lmh666-yes/Second_Project_Demo/README.md

# 环境监测系统
### STM32F407 双板 + LoRa + MQTT + Qt 上位机

> 两套独立固件（检测端 / 通信端）通过 LoRa 组网，通信端经 ESP8266 上云，
> PC 端用 Qt 实时显示曲线、告警与历史数据。

---

## ⚠️ 先看这个：项目实际做到哪一步

**这个项目和最初的设计预期不完全一致。** 下面是逐项核对的结果（以仓库里的当前源码为准，不看设计文档）：

| 能力 | 设计预期 | 实际代码 | 状态 |
|---|---|---|---|
| **4 路 I2C 传感器** | SHT30 / BMP280 / BH1750 / CCS811 | `CollectAll()` 确实读这 4 路，`SYS_I2C_Init()` 已调用 | ✅ **已实现** |
| **20 字节定长帧** | AA55 + CMD + LEN + 12B 数据 + CRC16 + 55AA | `sys_frame` 模块实现组帧/解帧/CRC | ✅ **已实现** |
| **LoRa 收发** | E22-400T22S，USART3/6 | `lora_e22` 模块 + `vTaskComm`/`vTaskLoraRx` | ✅ **已实现** |
| **断网缓存** | W25Q128 环形日志 | `w25qxx_log.h`：**255 扇区 ≈ 1020 KB ≈ 32640 条 ≈ 18 h** | ✅ **已实现** |
| **自动补传** | 按原时间戳回传 | `vTaskReplay` + `replay_*`，重连即自动补传 | ✅ **已实现** |
| **MQTT 上报** | 周期性上报环境数据 | 有 `publish_env()`，但**只在上报时机调用**，周期性待确认 | ⚠️ **部分实现** |
| **自检（18 项）** | 上电跑 18 项自检 | `board_selftest.c` **已写好，但没接入 `main.c`** | ⚠️ **代码在，没接线** |
| **MQ-135 空气质量** | 接入第 6 路 | 全代码 **0 处引用**，帧第 6 字段固定 0 | ❌ **未做** |
| **实测指标** | 周期抖动 / 72h 长稳 / 丢包率 | **硬件还没组装**，所有实测数据为空 | ❌ **未做** |
| **DHT11** | 早期方案的主传感器 | 当前代码 **0 处引用**（已被 4 路 I2C 取代） | 🔄 **已废弃** |

### 为什么会不一致

三个阶段叠加造成的结果：

1. **第一阶段（2026-10 前）**：写了一套完整参考实现——板1 1074 行、板2 1694 行，带 12 个 `test_*` 自检函数，自检 18/18 通过。
2. **第二阶段（2026-10-12）**：为了「从零自建」练手，`main.c` 被换成阶段骨架（板1 72 行、板2 83 行），Qt 的 5 个业务类改成桩函数。参考实现整套备份在 `_参考实现备份\20261012_195704\`。
3. **第三阶段（2026-10-20 之后）**：自己重写，当前是板1 **995 行**、板2 **834 行**——主体功能回来了（4 路传感器、帧协议、缓存、补传），但**自检没接回来**（`board_selftest.c` 写好了躺在目录里），**MQ-135 没接**，**硬件没到货所以没实测**。

**所以准确的说法是：软件主体功能已实现并编译通过，但自检未接入、MQ-135 未接、硬件未上板、无任何实测数据。**

---

## 一、项目做什么

在实验室多点布置环境监测节点，自动采集温湿度、气压、光照、空气质量，数据经 LoRa 汇总到通信端，再经 WiFi/MQTT 上云，PC 上位机做实时可视化。

**要解决的问题**：替代人工巡检抄表——4 类参数自动采集、超限告警、历史可追溯。

---

## 二、系统结构

```
┌──────────────┐   LoRa 433MHz   ┌──────────────┐   WiFi/MQTT   ┌────────────┐
│ 检测端 F407ZE │ ──────────────> │ 通信端 F407ZG │ ────────────> │  云 / 上位机 │
│ 4 路 I2C 传感器│   20 字节帧      │ TFT 显示/缓存 │   ESP8266 AT  │   Qt 程序   │
└──────────────┘                 └──────────────┘                └────────────┘
```

| 角色 | 主控 | 职责 |
|---|---|---|
| **检测端** | STM32F407ZE | 采集 4 路传感器、滤波、告警判断、LoRa 上报 |
| **通信端** | STM32F407ZG | LoRa 接收、TFT 显示、断网缓存、WiFi 上云、上位机转发 |
| **上位机** | PC (Qt 6) | 实时曲线、告警配色、CSV 导出、下发控制 |

---

## 三、传感器与硬件

### 检测端 4 路 I2C 传感器

| 传感器 | 测量 | I2C 地址 | 状态 |
|---|---|---|---|
| SHT30 | 温湿度 | 0x44 | ✅ 驱动已实现 |
| BMP280 | 气压 | 0x76/0x77 | ✅ 驱动已实现 |
| BH1750 | 光照 | 0x23 | ✅ 驱动已实现 |
| CCS811 | 空气质量（TVOC/eCO2） | 0x5A | ✅ 驱动已实现 |
| MQ-135 | 空气质量（模拟） | ADC PF7 | ❌ 未接入 |

### 通信与外设

| 器件 | 用途 | 状态 |
|---|---|---|
| LoRa E22-400T22S | 节点间无线（433MHz） | ✅ 已实现（USART3 板1 / USART6 板2） |
| ESP8266 + AT | WiFi 上云（MCU 侧自实现 MQTT 3.1.1） | ✅ 已实现 |
| W25Q128（实为 GD25Q128） | 16MB SPI Flash，断网缓存 | ✅ 已实现 |
| ILI9481 TFT 3.5" | 本地显示（板2） | ✅ 已实现 |
| CH340C | USB 转串口（调试） | ✅ |

---

## 四、通信协议：20 字节定长帧

```
┌──────┬──────┬──────┬────────────────────┬────────┬──────┐
│ AA55 │ CMD  │ LEN  │ 6 × int16 大端定点  │ CRC16  │ 55AA │
│ 2B   │ 1B   │ 1B   │ 12B                │ 2B     │ 2B   │
└──────┴──────┴──────┴────────────────────┴────────┴──────┘
```

| 字段 | 说明 |
|---|---|
| 帧头 | `0xAA55` |
| 命令 | `0x01` 环境帧上行；`0x10`–`0x16` 下行请求；`0x80`–`0xFF` 应答（= 请求 \| 0x80） |
| 长度 | `0x0C`（12 字节负载） |
| 数据 | 6 个 int16 大端：温度×100、湿度×100、气压×10、光照、TVOC、**第 6 字段保留（MQ-135 未接，固定 0）** |
| CRC16 | MODBUS 多项式，覆盖前 14 字节，**低字节在前** |
| 帧尾 | `0x55AA` |

**下行命令**：`0x16` 触发补传、`0x15` 回传历史帧（4 字节原始时间戳 + 20 字节原帧）、`0x96` 回报状态。应答字 = 命令 \| `0x80`。

**协议向量（自检用）**：
```
0x16 01 01 → AA 55 16 01 01 50 54 55 AA
0x16 01 00 → AA 55 16 01 00 91 94 55 AA
```

**CRC 双向验证**：板1 组帧、板2 解帧、Qt 再解一遍，三处独立计算 CRC 并互验。

---

## 五、FreeRTOS 任务结构

### 检测端（板1）

| 任务 | 职责 |
|---|---|
| `vTaskSensor` | 采集：`CollectAll()` 读 4 路 I2C，带失败重试与降级 |
| `vTaskProcess` | 滤波 + 双阈值迟滞告警 + 组帧 |
| `vTaskComm` | LoRa 发送 |
| `vTaskLoraRx` | 下行指令接收与处理 |
| `vTaskUi` | 本地显示 |
| `vTaskMonitor` | 看门狗 + 统计 |

### 通信端（板2）

| 任务 | 职责 |
|---|---|
| `vTaskLoraRx` | 收帧，按字节间隔切帧 |
| `vTaskCmd` | 命令解析与应答 |
| `vTaskNet` | WiFi/MQTT 连接与发布 |
| `vTaskReplay` | 断网补传（50 ms/条） |
| `vTaskUi` | TFT 刷新 |
| `vTaskMonitor` | 看门狗 + 统计 |

队列解耦各环节，按栈水位实测调优任务栈大小。

---

## 六、断网缓存（可靠性设计）

网络断开时数据不丢：

```
采样 → 带时间戳 → 写 W25Q128 环形日志（255 扇区 ≈ 1020KB ≈ 32640 条）
     → 网络恢复 → 按原时间戳自动补传（50ms/条）
```

配置见 `w25qxx_log.h`：

```c
#define W25QXX_LOG_SECTORS   255U   /* ≈1020KB ≈ 32640 条，约 18 小时@0.5 帧/秒 */
#define W25QXX_LOG_SLOT_SIZE 32U    /* 32 字节/条，4KB 扇区正好 128 条 */
#define W25QXX_LOG_HDR_SIZE  12U    /* 12B 头 + 20B 整帧 */
```

- 环形覆盖：写满后从最旧开始覆盖
- 先写数据再写序号 → 掉电原子性
- 时间戳保留：补传的是采样原始时刻，不是当前时间

**已知不足**（设计文档自己列的）：
- 补传期间新帧只计数不补发
- 无掉电续传游标
- `0x96` 剩余条数只有 1 字节（255 表示"以上"）
- 清空 16 扇区期间挂起调度器 0.5~1 s

---

## 七、上位机（Qt 6）

| 功能 | 状态 |
|---|---|
| 实时曲线（QCustomPlot） | ✅ |
| 6 项数值显示 | ✅ |
| 环形缓冲 | ✅ |
| CSV 导出（10 列，末列区分实时/补传） | ✅ |
| 双阈值迟滞告警 + 告警记录 | ✅ |
| 补传按钮与进度显示 | ✅ |
| 命令下发 | ✅ |

自检命令：`--selftest`、`--rangecheck`、`--cmdselftest`（**当前是桩化版本，数字不能当实测**）。

---

## 八、目录说明

```
Second_Project_Demo/
├── README.md                       ← 本文件
├── 01_检测端_STM32F407/
│   ├── Project/                    ← Keil 工程 + 源码（main.c 995 行）
│   ├── 检测数据端设计.md            ← 设计说明
│   ├── LoRa模块参数.md
│   └── 该端目前采用STM32F407_zet6.txt
├── 02_通信端_STM32F407/
│   ├── Project/                    ← Keil 工程 + 源码（main.c 834 行）
│   ├── 数据传输端设计.md
│   └── LoRa模块参数.md
├── 03_上位机_Qt/
│   ├── SerialMonitor/              ← Qt 工程源码
│   └── Qt上位机设计.md
├── 04_文档/
│   ├── 架构与设计/                 ← 18 份设计文档
│   │   ├── 设计思路报告.md
│   │   ├── 实现事实清单.md          ← ★ 逐行代码取证，最硬的一份
│   │   ├── 项目进度.md             ← ★ 完成/未完成清单
│   │   ├── 核心软件和FreeRTOS架构.md
│   │   ├── 断网缓存补传设计.md
│   │   ├── 代码审查报告.md
│   │   ├── 项目整体评审与升级建议.md
│   │   └── ...
│   └── 问题与分析/
│       ├── 我遇到我问题以及的分析.md  ← ★ 踩坑记录
│       ├── 嵌入式项目面试问答.md
│       └── 视频拍摄脚本.md
├── 05_硬件资料/                    ← 传感器手册 + 接线表
└── 06_工具脚本/
    ├── 诊断/（串口识别、诊断两块板）
    ├── 长稳测试/
    └── OTA救援/
```

---

## 九、编译与烧录

### 固件（Keil MDK）

```
01_检测端_STM32F407/Project/标准模板.uvprojx      （板1，编译宏 SYS_TEST_BOARD=1）
02_通信端_STM32F407/Project/000标准模板库.uvprojx  （板2，编译宏 SYS_TEST_BOARD=2）
```

两板共用一份 `main.c` 源码思路，通过 `SYS_TEST_BOARD` 宏分支：
- `SYS_TEST_BOARD=1` → `HAS_DHT11=1`
- `SYS_TEST_BOARD=2` → `HAS_W25QXX=1`
- 未定义直接 `#error`

编译产物参考：板1 `Code=28908 RO=1288 RW=304 ZI=34848`；板2 `Code=40160 RO=2632 RW=396 ZI=36340`（0 Error 0 Warning）。

### 上位机（Qt 6）

```
03_上位机_Qt/SerialMonitor/SerialMonitor.pro
```

Qt Creator 打开 `.pro`，选 Qt 6 + MinGW 构建。

---

## 十、还没做的事（诚实清单）

| 优先级 | 事项 | 现状 |
|---|---|---|
| **高** | 硬件组装 | 传感器 / LoRa / OLED 未采购到货，**一次都没上板跑过** |
| **高** | 上板跑通单链路 | 检测端 → LoRa → 通信端 → Qt，全链路未联调 |
| **高** | 接入自检 | `board_selftest.c` 已写好（2026-10-20 生成），未加进 Keil 工程、未在 main 调用 |
| **高** | 接入 MQ-135 | 驱动未写，帧第 6 字段固定 0 |
| **中** | MQTT 周期上报 | 现在只在特定时机发布，未做定时上报 |
| **中** | I2C 地址宏 | BH1750(0x23)/CCS811(0x5A)/BMP280(0x76) 部分缺宏 |
| **中** | 采集周期压回 1 s | 当前 2 s |
| **中** | 看门狗心跳汇总 | `SYS_WDG_HEARTBEAT_COUNT` 仍为 0，只喂狗不用心跳位图 |
| **低** | 补传细节 | 无掉电续传游标、剩余条数只有 1 字节 |
| **低** | 实测指标 | 周期抖动、单轮耗时、72h 长稳、丢包率全部为空 |

---

## 十一、这个项目真实的价值

不是"读几个传感器显示出来"，而是这几件**已经写进代码**的事：

1. **两套独立固件**通过网络协同，`SYS_TEST_BOARD` 宏分板、编译期断言防错
2. **自定义二进制帧协议**（20 字节定长 + CRC16 + 三端互验 + 协议向量自检）
3. **断网缓存 32640 条 + 原时间戳补传**（掉电原子性、环形覆盖）
4. **FreeRTOS 多任务**（队列解耦、栈水位实测调优、看门狗）
5. **Qt 上位机**（实时曲线、双阈值迟滞告警、CSV、补传控制）
6. **逐行代码取证的文档**（`实现事实清单.md` 572 行，每行结论都带文件行号）

**还没兑现的**：上板实测 + 自检接入 + MQ-135。

**这个项目最值钱的部分可能不是功能，是那份 `实现事实清单.md`**——把每一条结论都钉到具体文件的具体行，这种取证能力比"能跑"更难。

---

*文档版本 v2.0 · 2026-11 · 本版按实际代码重新核对，修正了 v1.0 中过度乐观的表述*
