lmh666-yes/Second_Project_Demo/04_文档/架构与设计/项目整体评审与升级建议.md

# 项目整体评审与升级建议

> 项目 : 精密仪器实验室环境监护系统
> 定位 : 分布式环境监测系统（两块 STM32F407）
> 日期 : 2026-10-09
> 状态 : 设计定稿期（外设尚未采购）

---

## 0. 结论

| 问题 | 结论 |
|---|---|
| 项目能做出来吗 | 能。底层驱动比预期完整：两板各有 40+ 个自研 `sys_*` 驱动，FreeRTOS 已跑通、编译零错误 |
| 技术覆盖面如何 | 覆盖嵌入式岗位的主要考点，比常见的单板学生项目多一个分布式层次 |
| 最大的短板 | 没有可量化的结果（没有丢包率、堆余量等实测数字），以及 8 项外设里 7 项还没买到 |
| 最该先做的一件事 | 用手上的板载 DHT11 先跑通完整链路（采集→队列→组帧→LoRa→网关→Qt），再插传感器 |
| 定位口径建议 | 不用"高精度科研级"这类说法（没有校准设备与计量依据），改为"工业级环境监测 + 数据可追溯"，后者有 CRC16、心跳、断网缓存支撑 |

---

## 1. 项目做什么

用两块 STM32F407 组成"无线采集 + 边缘网关"的分布式系统，对实验室的温湿度、气压、光照、空气质量做长期监测，数据同时送到电脑上位机和云端，超限时本地与远程双重告警。

数据通路：采集节点通过 I2C 挂 SHT30、BMP280、BH1750、CCS811 四类传感器，1 秒一轮采集，经滑动滤波后按自定义的 20 字节二进制协议组帧、带 CRC16 校验，通过 LoRa 无线发出。

网关端也是 F407，用串口 DMA + 空闲中断收帧，状态机解析并校验，然后同时走两路：一路通过 RS232 发给 Qt 上位机做实时曲线和 CSV 记录，一路通过 ESP8266 走 MQTT 上巴法云，云端可直接推到手机。网关侧还有 W25Q128 断网缓存：云端断开时把数据落进 Flash，网络恢复后按序号补传。上位机用 Qt 写，实时显示 6 个参数、画历史曲线、导出 CSV，带双阈值迟滞告警和协议一致性自检。

---

## 2. 技术栈总览

| 层次 | 技术 | 说明 |
|---|---|---|
| 硬件 | STM32F407ZET6（采集节点）+ STM32F407ZGT6（边缘网关） | 双 F407，同系列不同 Flash 容量（512 KB / 1 MB） |
| 底层驱动 | ST 标准外设库（StdPeriph Library） | 非 HAL；两板工程各含 40+ 个自研 `sys_*` 封装驱动 |
| RTOS | FreeRTOS 10.4.6（原生 API，非 CMSIS-RTOS 封装） | heap_4，30 KB 堆，抢占式调度 |
| 无线 | LoRa E22-400T22S（433 MHz） | 板1 ↔ 板2 的唯一链路 |
| 云端 | ESP8266 + AT 指令 + MQTT（巴法云 bemfa.com） | 通过 WiFi 上云，可直接推微信/小程序 |
| 上位机 | Qt 6.11.2（MinGW 64-bit）+ QCustomPlot | 串口通信、实时曲线、CSV、告警 |
| 传感器 | SHT30(I2C) / BMP280(I2C) / BH1750(I2C) / CCS811(I2C) / MQ-135(ADC) | 4 类物理量 + 2 类空气质量 |
| 存储 | W25Q128 SPI Flash（板载） | 断网缓存，64 KB 专用区 ≈ 2000 条 |
| 协议 | 自定义 20 字节二进制帧 + CRC16-MODBUS | 三端（板1/板2/Qt）一致 |

---

## 3. 系统架构

### 3.1 三端数据流

```
┌──────────────────────────────┐
│   板1 采集节点 (F407ZET6)     │
│                              │
│  SHT30 ┐                     │
│  BMP280├─ I2C ──► SensorTask │  1 s 周期
│  BH1750│          (优先级 3)  │
│  CCS811┘              │      │
│  MQ-135 ── ADC ───────┤      │
│                       ▼      │
│                   Queue1     │
│                       ▼      │
│              ProcessTask(3)  │  滤波 + 阈值 + 组帧
│                       ▼      │
│                   Queue2     │
│                       ▼      │
│               CommTask(4) ───┼──► LoRa E22 ──┐
│                              │               │
│  MonitorTask(5) 心跳 + 喂狗   │               │
└──────────────────────────────┘               │
                                               │ 无线 433MHz
                                               ▼
┌──────────────────────────────────────────────────────────────┐
│   板2 边缘网关 (F407ZGT6)                                     │
│                                                              │
│  LoRa ──► USART6 + DMA + 空闲中断 ──► Sem1（二值信号量）       │
│                                              ▼               │
│                                    CommRxTask(4) 状态机解帧   │
│                                      找帧头/验长度/CRC16/验尾  │
│                                              ▼               │
│                                          Queue3              │
│                                              ▼               │
│  ┌───────────────────────────┬───────────────────────────┐  │
│  ▼                           ▼                           │  │
│ ForwardTask(3)          CloudTask(3)                     │  │
│  USART2 → RS232          USART3 → ESP8266 → MQTT         │  │
│      │                        │                          │  │
│      │                  失败 3 次                         │  │
│      │                        ▼                          │  │
│      │                     Queue4                         │  │
│      │                        ▼                          │  │
│      │                  CacheTask(3) → W25Q128           │  │
│      │                  断网落盘 / 恢复后补传              │  │
│      │                                                   │  │
│  MonitorTask(5) 心跳位图 + 喂狗                            │  │
└──────┼───────────────────────────────────────────────────┘  │
       │                                                      │
       ▼                                                      ▼
┌──────────────────┐                              ┌──────────────────┐
│  Qt 上位机        │                              │  巴法云 MQTT      │
│  数值 / 曲线      │                              │  → 微信 / 小程序  │
│  CSV / 阈值告警   │                              └──────────────────┘
│  一致性自检       │
└──────────────────┘
```

### 3.2 任务划分与优先级

板1（采集节点）

| 任务 | 优先级 | 周期/触发 | 职责 |
|---|---|---|---|
| SensorTask | 3 | 1 s（vTaskDelayUntil） | 读 5 路传感器，失败填故障标记不阻塞 |
| ProcessTask | 3 | Queue1 触发 | 滑动/中值滤波、双阈值判断、按协议打包 |
| CommTask | 4 | Queue2 触发 | 组帧 + CRC16 + 经 USART3 发 LoRa |
| MonitorTask | 5 | 定时 | 心跳位图巡查，全刷新过才喂 IWDG |

板2（边缘网关）

| 任务 | 优先级 | 周期/触发 | 职责 |
|---|---|---|---|
| CommRxTask | 4 | Sem1（空闲中断） | 状态机解帧、CRC 校验、提取数据 |
| ForwardTask | 3 | Queue3 触发 | 经 USART2 透传给 Qt 上位机 |
| CloudTask | 3 | 30 s / 告警插播 | AT 指令 + MQTT 上报巴法云 |
| CacheTask | 3 | Queue4 触发 | 断网写 W25Q128，恢复后按序号补传 |
| MonitorTask | 5 | 定时 | 心跳位图 + 喂狗 + ESP8266 在线巡查 |

> CloudTask 与 ForwardTask 必须分开：AT 指令是一问一答，单条 `AT+CIPSEND` 可能阻塞几百毫秒。
> 如果和 Qt 转发挤在一个任务里，云端阻塞时会连带阻塞上位机的实时曲线。

---

## 4. 能力覆盖面

| 方向 | 本项目对应 |
|---|---|
| STM32 外设驱动开发 | GPIO / USART(+DMA+IDLE) / I2C / SPI / ADC+DMA / TIM / EXTI / IWDG / WWDG / RTC / FLASH |
| 通信协议设计 | 自定义 20 字节帧 + CRC16-MODBUS + 状态机解帧 + 边界处理（帧头粘连、半帧、CRC 错） |
| RTOS 应用 | 多任务划分、队列解耦、二值信号量、互斥锁、心跳喂狗、中断优先级约束 |
| 分布式/无线通信 | 双板 LoRa 组网，采集与网关分离 |
| 上位机开发 | Qt 串口、QCustomPlot 实时曲线、CSV 导出、阈值告警 |
| 物联网/云平台 | ESP8266 AT + MQTT + 云平台推送到微信 |
| 可靠性/工程化 | 断网缓存补传、CRC 校验、看门狗、心跳、故障恢复、边界用例测试 |
| 调试手段 | 逻辑分析仪抓 I2C/串口、三端一致性自检、实测指标记录 |

覆盖面较均衡，其中可靠性设计部分（断网、误码、任务卡死的处理）是常见学生项目普遍缺失的一块。

---

## 5. 与常见学生项目的差异

| 常见学生项目 | 本项目 |
|---|---|
| 单板采集，串口打印到电脑 | 双板分布式，采集与网关分离，无线 LoRa 链路 |
| 用文本协议（`TEMP:25.3\n`） | 自定义二进制帧 + CRC16，带完整的状态机解析与边界处理 |
| 只做"读传感器 + 显示" | 有滤波算法、双阈值迟滞告警、分级告警（本地蜂鸣器 + 远程上位机） |
| 断线即中断 | 断网缓存 + 补传（W25Q128，约 2000 条 ≈ 16 小时） |
| 看门狗单点喂狗 | 心跳位图，全任务刷新过才喂狗，避免单任务死循环被掩盖 |
| 没有测试环节 | 三端一致性自检 + 边界用例（负温度、CRC 错、帧头粘连、半帧） |
| 只有"能跑"的结论 | 有实测指标表（周期抖动、丢包率、CRC 错误率、堆余量、端到端延迟） |

---

## 6. 已有的技术底子

评审时把两板的 `FWLIB/inc` 逐个列了出来，结论是底座比一开始以为的完整得多。

### 6.1 两板驱动库规模

| | 头文件数 | 说明 |
|---|---|---|
| 板1 (`Project_1_检测端/Project/FWLIB/inc`) | 31 个 | 纯 `sys_*` 风格封装 |
| 板2 (`Project_2_数据通信端/Project/FWLIB/inc`) | 54 个 | 含板卡外设驱动（LCD/按键/RGB 等）+ `sys_*` 系统层 |

### 6.2 可直接复用的模块

这些模块正好覆盖本项目最花时间的部分：

| 模块 | 位置 | 对本项目的价值 |
|---|---|---|
| `sys_frame` | 两板都有 | 组帧/收帧状态机：内建帧同步（帧头不对自动丢到下一个）、粘包/半包处理、校验错自动重找帧头、`SYS_FRAME_Verify()` 双保险、`SYS_FRAME_ErrCount()` 链路质量统计。2026-10-10 已完成改造：帧格式为定稿的 `AA 55 \| CMD \| LEN \| DATA \| CRC16(低字节在前) \| 55 AA`（总长 `8+LEN`，CRC 范围 = 帧内 `[2 .. 4+LEN)`），旧的单字节头/尾与"简化帧"（`SYS_FRAME_WITH_LEN`）已删除，并新增 `SYS_FRAME_BuildEnv()` / `SYS_FRAME_UnpackEnv()` 两个环境帧助手 |
| `SYS_MODBUS_Crc16()` | 板1 `sys_modbus.h:58` | CRC16-MODBUS 现成实现（多项式 `0xA001`、初值 `0xFFFF`） |
| `MODBUS_CRC16()` | 板2 `modbus.h:110` | 同上（板2 版本，注释明确 `frame[6]=c&0xFF, frame[7]=c>>8` 低字节在前） |
| `sys_wdg` 心跳汇总 | 两板 `sys_wdg.h` | 多任务心跳喂狗已实现：`SYS_WDG_HEARTBEAT_COUNT` 设任务数 → 每个任务 `SYS_WDG_Heartbeat(id)` 报到 → 主循环/最低优先级任务调 `SYS_WDG_HeartbeatPoll()`，全员到齐才喂狗 |
| `SYS_WDG_ResetCauseDecode()` | `sys_wdg.h:130` | 可判断复位原因（`SYS_WDG_RST_IWDG` 独立看门狗复位 / `RST_WWDG` / `RST_POR` / `RST_BOR` 等），能做复位原因诊断 |
| `sys_fault` | 两板 `sys_fault.h` | CPU 故障记录：接管 NMI/HardFault/MemManage/BusFault/UsageFault，把出错地址、寄存器、故障状态存进全局 `SYS_FAULT_Record`，可 `SYS_FAULT_Report()` 生成文字发串口。与 FreeRTOS 共存（不碰 SVC/PendSV/SysTick） |
| `sys_softimer` | 两板 `sys_softimer.h` | 软件定时器：`SYS_SOFTIMER_Add(callback, period_ms)` + 主循环 `SYS_SOFTIMER_Poll()`，用于事件驱动任务的兜底心跳 |
| `sys_oled` | 板1 `sys_oled.h` | SSD1306 驱动：显存缓冲 + 内置 8×8 字库 + `SYS_OLED_ShowString/ShowNum/ShowFloat/ShowBitmap/SetPixel` + 整帧刷新 |
| `sys_dht11` | 板1 `sys_dht11.h` | 板载 DHT11 驱动现成，阶段一的数据源不用写 |
| `sys_filter` + `kalman` | 板2 | 滑动平均/中值滤波 + 卡尔曼，滤波算法对比实验零成本 |
| `esp8266` + `mqtt` | 板2（10.8 KB / 11.6 KB 头文件） | AT 指令封装 + MQTT 客户端现成 |
| `w25qxx` + `w25qxx_log` | 板2 | W25Q128 驱动 + 日志封装，断网缓存底座现成 |
| `sys_eth` + `ETH/` | 板1 有 PHY 可用；板2 无 PHY，是模板代码 | 板1 以太网 MAC 驱动齐全（板1 GEC-M4 有 LAN8720）；板2 已核实没有以太网 PHY（"以太网模块接口"实为 NRF24L01 座），此路不通。两板都无 TCP/IP 协议栈 |
| `sys_usart` | 两板（板1 15.5 KB / 板2 16.4 KB 头文件） | DMA、空闲中断、`SendFormat`/`ReadUntil`/`DmaRxDone` 等收帧原语齐全 |

> 结论：这些模块可覆盖大部分底层，本项目实际要写的是
> 复用现有底座 + 5 个传感器驱动 + 1 个 LoRa 驱动 + 业务逻辑。

### 6.3 板2 与项目无关但说明工程完整的驱动（54 个头文件）

`vl53l0x`（激光测距）、`ds18b20`、`ntc_pt100`、`hcsr04`（超声波）、`xpt2046`（触摸）、`rgb5x5`、`tb6612`/`uln2003`（电机）、`pid`、`encoder`、`sram`、`lcd_font` 等。

这些本项目用不到，说明板2 的库是一个成体系的工程模板。

### 6.4 需要新写的文件

| # | 文件 | 接口 | 依据 |
|---|---|---|---|
| 1 | `sht30.c/.h` | I2C 0x44 | 地址宏 `SYS_I2C_ADDR_SHT30` 已存在，只差驱动 |
| 2 | `bmp280.c/.h` | I2C 0x76/0x77 | 需补地址宏；先验 ID `0xD0` = 0x58 |
| 3 | `bh1750.c/.h` | I2C 0x23 | 需补地址宏 |
| 4 | `ccs811.c/.h` | I2C 0x5A | 需补地址宏；WAKE 脚拉低 |
| 5 | `mq135.c/.h` | ADC | 复用 `sys_adc`，只需换算/校准封装 |
| 6 | `lora_e22.c/.h` | UART | 两板共用，板1↔板2 的唯一通道 |
| 7 | 板2 的 `sys_usart` 扩第 4 路（USART6） | UART | 若用方案 A（见 `数据传输端设计.md` 3.2） |

新增成本最高的是 LoRa E22 驱动，需要处理 AT 配置模式、M0/M1 时序、AUX 引脚、透传收发。
其余 5 个传感器驱动都是读取 I2C 寄存器后按数据手册换算，工作量以小时计。

同时要做的改造（不是重写）：

| 项 | 动作 |
|---|---|
| `sys_frame` 改造 | 已完成（2026-10-10）：帧头/帧尾已改双字节（`SYS_FRAME_HEAD_HI/LO` = `0xAAU`/`0x55U`，`SYS_FRAME_TAIL_HI/LO` = `0x55U`/`0xAAU`）、校验已换 CRC16-MODBUS（初值 `0xFFFF`、多项式 `0xA001`、范围 = 帧内 `[2 .. 4+LEN)`）、总长 = `8 + LEN`。`sys_frame.c` 内已自带 `frame_crc16()`，且两板该文件逐字节相同（`sys_frame.c` 524 行 / `sys_frame.h` 277 行）。旧宏 `SYS_FRAME_HEAD`/`SYS_FRAME_TAIL`/`SYS_FRAME_WITH_LEN` 与全部"简化帧"路径已删除；`SYS_FRAME_ERR_CHECK` 更名 `SYS_FRAME_ERR_CRC`（旧名保留为别名）。长度字段不是固定 0x0C：环境帧是 `LEN = 0x0C`，框架本身按 `LEN` 变长（上限 `SYS_FRAME_MAX_PAYLOAD` = 64） |
| `sys_wdg` 配置 | 把 `SYS_WDG_HEARTBEAT_COUNT` 从 0 改成实际任务数，然后在各任务上报到。`COUNT = 0` 时 `SYS_WDG_HeartbeatPoll()` 退化为普通喂狗，不是空操作，所以"忘了配"不会变成上电复位循环 |
| 采集任务 | `SensorTask` 里逐个调用新传感器驱动 |

---

## 7. 关键工程决策

| 决策 | 选择 | 理由 |
|---|---|---|
| 协议精度 | 温度/湿度 ×100，气压 ×10 | SHT30 分辨率 0.01 ℃，用 ×10 只有 0.1 ℃ 分辨率，浪费传感器精度；气压若用 ×100，1013.25×100 = 101325 超出 uint16 上限 65535，所以只能 ×10 |
| CRC 字节序 | 数据段大端，CRC 低字节在前 | 大端便于人工阅读抓包；CRC16-MODBUS 的标准传输顺序本来就是低字节在前，跟随标准比自创更不易出错 |
| 解帧策略 | 校验失败丢一个字节重新找帧头 | 若跳过整帧长度，遇到帧尾 `55 AA` 与下一帧头 `AA 55` 粘连成 `55 AA AA 55` 时会连续丢帧 |
| 缓冲环设计 | 环形缓冲 + 状态机 | 串口是字节流，可能收到半个包或三个包，不能用"一次读到一包"的假设 |
| 云端报文格式 | `#` 分隔文本（不是 JSON） | 巴法云可直接把消息推微信/小程序，文本格式在手机上可直接阅读；JSON 需要额外一层解析，演示中没有收益 |
| 断网缓存位置 | 网关侧 W25Q128，不是采集端 | 采集端加 Flash 会增加功耗与成本；网关常供电，且工程里 `w25qxx_log.c` 现成，零采购零硬件改动 |
| 中断优先级 | 串口 ISR 抢占优先级必须 ≥ 5 | `configLIBRARY_MAX_SYSCALL_INTERRUPT_PRIORITY = 5`，优先级数值小于 5 的中断里不能调 FreeRTOS API，否则破坏内核临界区 |
| 喂狗方式 | 心跳位图，全任务刷新过才喂 | 若只看"MonitorTask 自己还在跑"，某个业务任务死循环时狗照样被喂，故障被掩盖 |
| 光照传感器 | BH1750（I2C）而非光敏电阻 + ADC | 光敏电阻需要标定才能得到 lux，且温漂大；BH1750 直接出数字照度，省掉标定环节 |
| 是否用 HAL | 不换，继续标准库 | 见第 9 节 |

---

## 8. 待补的短板（优先级从高到低）

### P0 先做这两件

| # | 事项 | 原因 |
|---|---|---|
| 1 | 先用板载 DHT11 跑通完整链路：DHT11 → Queue1 → 滤波 → 组帧 → LoRa → 板2 → 解帧 → Qt 曲线 | 传感器到货前就能验证整条骨架。到货后只换 `SensorTask` 里的读取函数，架构不动。这是把"8 项待采购"从阻塞项变成非阻塞项的关键 |
| 2 | 建立实测指标表并实测 | 目前没有可量化的结果。至少测：1) 任务周期抖动；2) 连续 24/72 h 丢包率与 CRC 错误率；3) FreeRTOS 堆余量（30 KB 池的实测峰值）；4) 端到端延迟（板1 采集 → Qt 显示）；5) 断网恢复时间 |

> 第 2 条的做法：让板1 每帧带一个自增序号，Qt 端统计"收到帧数 / 序号跳变次数"即可算丢包率。

### P1 做完 P0 后

| # | 事项 | 收益 |
|---|---|---|
| 3 | 滤波算法对比实验 | 工程自带 `sys_filter.c` 与 `kalman.c`。同一次实测数据分别跑"无滤波 / 滑动平均 / 中值 / 卡尔曼"，画对比曲线并算噪声方差。纯软件工作，零采购 |
| 4 | 三端一致性自检脚本 | 板1 抓包导出 → Qt 回放解析 → 与预期逐字段比对 |
| 5 | ESP8266 断线重连状态机 + 可视化 | 拔路由器 → 网关自动重连 → 缓存补传，全流程可见 |

### P2 时间允许再做

| # | 事项 | 备注 |
|---|---|---|
| 6 | 多节点组网（再买 1 个 LoRa） | 帧里预留节点 ID，从点对点升级成星型组网 |
| 7 | 以太网替代 USB 转 TTL 接 Qt | 不成立。已逐字核对板2 原理图：本板没有以太网 PHY，"以太网模块接口"实为 NRF24L01 座；`sys_eth.c` 只是参考工程留下的模板（`SYS_ETH_ENABLE` 默认 0）。要走网口须另买 SPI 接口 W5500/ENC28J60 模块并自封网卡驱动 |
| 8 | 网关本地 OLED | 不接电脑也能看到数据 |
| 9 | 16 位 ADC 过采样 | 提升 MQ-135 分辨率 |

### P3 不建议做

| 事项 | 原因 |
|---|---|
| 换 HAL + STM32CubeMX 重写 | 见第 9 节，投入产出比差 |
| 裸机"时间片轮转调度器" | 与 FreeRTOS 职责重复 |
| 上 RTOS 后再做 Tickless 低功耗 | 本工程 `configUSE_TICKLESS_IDLE = 0`，且设备 USB 供电固定式，没有省电需求 |

---

## 9. 关于是否改成 HAL + STM32CubeMX

`方案13.md` 里有一条建议是"改为纯 HAL 库 + STM32CubeMX"。结论是不换，理由如下。

| 维度 | 继续用标准库（现状） | 改成 HAL + CubeMX |
|---|---|---|
| 已有代码 | 两板各 40+ 个 `sys_*` 驱动 + 完整的 `FWLIB`，全部可用 | 全部作废重写，等于把项目推倒重来 |
| 外设驱动经验 | 需要理解寄存器时序（I2C 的 IDLE 标志、DMA 请求映射、时钟总线） | CubeMX 生成代码，难以说明生成代码的内部行为 |
| 工作量的时间成本 | 7 个传感器驱动 + 业务逻辑 | 上述 + 重新移植 FreeRTOS + 重写全部底层 |
| 对本项目的收益 | — | 几乎为零（本项目的外设在标准库下都有驱动） |
| 对代码掌握程度的体现 | 读参考手册后自己封装底层驱动库 | 使用工具生成 |

折中方案：

- 主线继续用标准库
- 同时读懂 HAL 的对应写法（`HAL_I2C_Master_Transmit`、`HAL_UART_Receive_DMA` 等），能说清标准库和 HAL 的差异与适用场景
- 如果将来投偏应用/快速开发的岗位，可以在另一个小 demo 里用 CubeMX 走一遍，但不要动这个项目

> 本机已装 `E:\STM32CudeMax\STM32CubeMX.exe`、`E:\ST32 Cude IDE\STM32CubeIDE_2.0.0`，
> 需要做 HAL 对比 demo 时工具是现成的。

---

## 10. 项目表述口径

| 当前说法 | 建议改成 | 原因 |
|---|---|---|
| "高精度科研级监测" | "工业级环境监测 + 数据可追溯" | "高精度"需要计量校准设备和依据；"数据可追溯"有 CSV、Flash 缓存、CRC 支撑 |
| "接入 8 种传感器" | "覆盖 5 类环境物理量，支持故障降级" | 强调类别而非数量；"故障降级"（某传感器坏了不影响其他）更能体现设计 |
| "实现远程监控" | "三级告警：设备本地蜂鸣器 → 上位机界面告警 → 云端推送微信" | 同样的事实，分层描述更清楚 |
| "用了 FreeRTOS" | "两板各 4 个任务（板1：采集 / 处理 / 发送 / 监控；板2：LoRa 接收 / 转发 / 命令 / 监控），队列解耦 + 板2 发送互斥 + 心跳位图看门狗" | 需要给出具体机制 |
| "能跑" | "连续运行 72 小时，丢包率 0.x%，堆余量 x KB" | 数字比形容词更有说明力 |

---

## 11. 技术问题与回答要点

| 问题 | 要点 |
|---|---|
| 为什么用 LoRa 不用 WiFi/蓝牙 | LoRa 是 Sub-1GHz 窄带，穿透和绕射能力比 2.4 G 强，传输距离远（开阔地几公里）且功耗低；本项目是固定式低速采集（1 s 一帧 20 字节），不需要 WiFi 的带宽。WiFi 放在网关端做上云，分工是"LoRa 负责可靠到达，WiFi 负责接入互联网" |
| 为什么用两块板而不是一块 | 采集节点要放到被测环境里（可能离实验室角落很远），网关要靠近路由器和电脑，物理位置分开就需要无线链路；双板也天然形成分布式架构，网关能做缓存、协议转换、多节点汇聚 |
| CRC16 怎么算的 | 多项式 `0xA001`（MODBUS），初值 `0xFFFF`，逐字节异或后右移 8 次，每次最低位为 1 就异或多项式；低字节先发 |
| 帧尾和下一帧帧头粘在一起怎么办 | 解析器以帧头为最高优先级：每次同步失败或 CRC 失败都只丢一个字节重新找 `AA 55`，同时要求"长度字段 = 0x0C"和"帧尾 = 55 AA"双重确认。测试里有专门构造 `...55 AA AA 55...` 的用例 |
| 中断里为什么不能随便调 FreeRTOS API | FreeRTOS 用 `BASEPRI` 屏蔽中断来保护临界区。抢占优先级数值小于 `configLIBRARY_MAX_SYSCALL_INTERRUPT_PRIORITY`（本工程=5）的中断不受内核控制，在这种中断里调 `xQueueSend` 之类可能破坏内核数据结构，所以必须用 `FromISR` 版本且优先级 ≥ 5 |
| 看门狗为什么不用简单喂狗 | 简单喂狗只能检测"整个系统死了"。用心跳位图：每个任务完成一轮工作后置自己的位，MonitorTask 检查全部位是否都被刷新过才喂狗，这样单个任务死循环也能被发现。事件驱动的任务还配了软定时器兜底 |
| 堆只有 30 KB 够用吗 | 任务是动态创建的，队列、信号量、任务栈都从这 30 KB 出。实测记录 `xPortGetFreeHeapSize()`，保留 >8 KB 余量；`configCHECK_FOR_STACK_OVERFLOW = 2` 和 `vApplicationMallocFailedHook` 都开了，异常时会打印任务名并停机，便于定位 |
| 断网了数据怎么办 | 网关 CacheTask 把帧写进 W25Q128 的 64 KB 专用区，每条 18 字节按 32 字节对齐，约 2000 条 ≈ 16 小时；每条自带序号和 CRC16；网络恢复后按序号升序、约 1 s 一条补传直到追平，不丢也不重 |
| 最难的地方 | 串口空闲中断 + DMA 收不定长帧，以及 I2C 上挂多个传感器时的地址冲突与总线锁死处理。具体表现：上电先 `SYS_I2C_Scan()` 逐个确认地址；多个模块的板上拉并联后等效阻值过小，要断开多余上拉 |
| 重做一次会怎么改 | 1) 一开始就把节点 ID 和状态位放进帧格式；2) 更早引入逻辑分析仪，I2C 调试会快很多；3) 传感器一次只挂一个，不全插上 |
| 为什么不用 MQTT 的 QoS 1/2 | 应用层已经用序号 + Flash 缓存 + 补传保证不丢，QoS 0 够用；QoS 1/2 会增加握手往返，在 ESP8266 的 AT 流程里实现复杂。可靠性放在应用层做，链路层保持简单 |

---

## 12. 演示流程

| 步 | 动作 | 观察点 | 时长 |
|---|---|---|---|
| 1 | 上电，Qt 自动连接串口 | 串口扫描 + 连接状态 | 20 s |
| 2 | 观察 6 项数值与曲线实时刷新 | 实时性、界面完整度 | 30 s |
| 3 | 对着 SHT30 哈气 / 用热风枪远吹 | 温度曲线响应 | 20 s |
| 4 | 用手遮住 BH1750 | 光照骤降 | 15 s |
| 5 | 触发阈值 | 数值卡片变红 + 板1 蜂鸣器响（分级告警） | 30 s |
| 6 | 拔掉板1 的 LoRa 天线 → 插回 | 网关统计 CRC/丢帧，恢复后自动继续 | 40 s |
| 7 | 拔掉路由器电源 → 恢复 | 断网缓存 + 序号补传，数据一条不少 | 60 s |
| 8 | 导出 CSV 并打开 | 数据可追溯 | 30 s |
| 9 | 运行一致性自检 | 协议一致性 | 30 s |

> 第 6、7 步是本项目与常见学生项目的主要区别，需要练熟，保证在 40 秒内干净地演完。

---

## 13. 交付前的准备

| 事项 | 说明 |
|---|---|
| README.md 与板级 README | 仓库导览 `README.md` 已在 2026-10-10 改写（系统构成、协议要点、目录与文档索引、验证命令、当前状态），与 `项目进度.md`、`上板验证步骤.md`、`代码审查报告.md` 一起放在 `EnvMonitor\项目架构思路设计参考\` 下；板1 `Project\README.md` 119.9 KB、板2 199.1 KB 仍然过大，后续可精简为"工程说明 + 编译步骤" |
| 准备一张端到端数据流图 | 讲项目时直接引用（`项目架构思路设计参考/` 下已有 `端到端的数据流向与协议解析图.png`，需与最新协议校对） |
| 准备实测数据截图 | 曲线截图、CSV 截图、串口抓包截图、逻辑分析仪波形截图各留一份 |
| git 历史要干净 | 目前工作区已整理、有 1 个本地提交未推送。推送前确认没有把临时文件、大二进制、个人配置提上去（`.uvoptx` 已停止跟踪，`本地工具/` 已忽略） |
| 项目条目的写法 | 格式：项目名 + 技术栈关键词 + 3 条量化成果。例："分布式环境监护系统（STM32F407 ×2 / FreeRTOS / LoRa / MQTT / Qt）——设计 20 字节二进制协议 + CRC16，三端一致；网关侧 W25Q128 断网缓存约 2000 帧、恢复后无丢失补传；连续运行 72 h，丢包率 0.x%" |

---

## 14. 下一步行动清单

### 立即（本周）
- [ ] 用手上现有的板子 + 板载 DHT11，跑通"采集→队列→组帧→LoRa→网关→Qt"完整链路（代码已就绪，等上板）
- [ ] 按《外设采购清单.md》阶段一下单（LoRa ×3 + 杜邦线，约 ¥130），下单前对照该文档 §0.5 的驱动就绪状态表
- [x] 把两张架构图与代码实测对齐一遍（2026-10-10 完成，两处图都重出一版，见《架构图修订说明.md》第 6 节）

### 外设到货后
- [ ] 逐项验收（先 `SYS_I2C_Scan()`，一次只挂一个器件）
- [ ] 补两个驱动：SHT30（I2C）与 MQ-135（ADC，库里没有）；BMP280 / BH1750 / CCS811 / LoRa E22 库里已有，接上后要把读数填进 `SensorMsg_t` 与 `main.c` 里那次 `frame_build()`
- [ ] 开始记录实测指标（周期抖动、丢包率、堆余量、端到端延迟）

### 项目完工前
- [ ] 滤波算法对比实验（P1）
- [ ] 三端一致性自检脚本（P1）
- [ ] 练熟演示流程第 6、7 步
- [ ] 重写根 README（3 分钟版），整理 git 历史并推送

---

## 15. 相关文档索引

| 文档 | 内容 |
|---|---|
| `EnvMonitor/Project_1_检测端/检测数据端设计.md` | 采集端：传感器、引脚、时间预算、协议、心跳、验收清单 |
| `EnvMonitor/Project_2_数据通信端/数据传输端设计.md` | 网关端：四路串口、任务划分、MQTT 定稿、W25Q128 缓存 |
| `EnvMonitor/QT_project/Qt上位机设计.md` | 上位机：帧解析、界面、CSV、阈值告警、一致性自检 |
| `EnvMonitor/项目架构思路设计参考/核心软件和FreeRTOS架构.md` | 任务拓扑、优先级、心跳、FreeRTOS 配置与三条约束 |
| `EnvMonitor/项目架构思路设计参考/外设采购清单.md` | 分阶段采购清单、型号注意点、到货验收流程 |
| `检查报告.md`（根目录） | 仓库现状、驱动缺口、编译记录、历史改动 |
