lmh666-yes/Second_Project_Demo/04_文档/问题与分析/嵌入式项目面试问答.md

# 嵌入式项目面试问答 · EnvMonitor 环境监测系统（板1 / 板2 / Qt 三端）

> 用法：面试前按主题过一遍；被问到时先给结论，再给"我是怎么做的"，最后给"踩过什么坑"。
> 所有数字、文件名、行号都来自真实工程，被追问细节时能直接翻代码。
>
> - 板1 检测端：STM32F407ZET6 + FreeRTOS，`EnvMonitor/Project_1_检测端/Project/main.c`
> - 板2 数据通信端：STM32F407ZGT6 + FreeRTOS + ESP8266/MQTT，`EnvMonitor/Project_2_数据通信端/Project/main.c`
> - Qt 上位机：Qt 6.11 + MinGW，`EnvMonitor/QT_project/SerialMonitor/`

---

## 0. 项目自述（三个版本，背熟 1 分钟版）

### Q0.1 用 30 秒介绍一下这个项目
**面试官想听：** 能不能一句话说清"做了什么、解决什么问题"。

**答：** 就是个环境监测系统，我拆成了三个端。板1 负责采集，STM32F407 跑 FreeRTOS，把温度、湿度、气压、光照、TVOC 五路读上来，打成 20 字节的定长帧，用 LoRa 发出去。板2 是数据通信端，收到 LoRa 帧先做协议解析，再通过 ESP8266 走 MQTT 传到云平台；网断了就写进 W25Q128 缓存，恢复后按 50ms 一条补传。板2 还挂了块 3.5 寸 LCD 做本地显示。Qt 上位机通过串口接板2，画实时曲线、统计报警，平时也拿它做故障注入测试。

### Q0.2 用 1 分钟版
**答：** 板1 的固件是我写的，FreeRTOS 六个任务怎么分、传感器驱动、CRC 组帧、LoRa 发送都在里面。板2 的网关固件也主要是我做，断网缓存补传和下行命令应答是花时间最多的地方。Qt 那边我负责数据模型和曲线。

要说技术上值得讲的，协议设计算一个。帧头 AA55、长度、CRC16-MODBUS、帧尾 55AA，板1、板2、Qt 三端用同一份定义；CRC 我在固件里算一遍，又用 Python 独立复算一遍，免得自己验证自己。

可靠性那块，IWDG 独立看门狗 4 秒、栈水位监控、HardFault 现场转储，还有指示灯状态机，把启动中、运行中、故障三种状态用灯区分开。

断网补传也算一个：W25Q128 掉电不丢，网络恢复后按时间顺序补发，补完主动上报一帧完成应答。

### Q0.3 项目中你最有成就感的一件事
**答：** 最难忘的是板1 那个串口只打印半句、LED 也不按 500ms 闪的问题，查了两天。

最后定位到 FreeRTOS 的 `port.c`，它通过宏 `#define xPortSysTickHandler SysTick_Handler` 生成了一个强符号，把我 `sys_tick.c` 里 `__weak` 的 SysTick 中断服务函数顶掉了。偏巧我在调度器启动前就把 SysTick 中断开了，中断进来访问 `pxCurrentTCB` 还是空指针，直接进 HardFault，静默停机。

证据是 map 文件里那行 `Removing sys_tick.o(i.SysTick_Handler), (16 bytes).`，链接器把弱符号删了。从那以后我遇到怪问题会先看 map 和反汇编，再猜代码。

---

## 1. 系统架构与分工

### Q1.1 为什么拆成两块板子，不是一块板全干完？
**面试官想听：** 有没有系统级思考，而不是堆功能。

**答：** 主要是位置和实时性逼的。采集点得放进被测环境，网关得搁在有 WiFi 的地方，中间几十米只能靠 LoRa。

再一个是隔离故障。ESP8266 重连会卡好几秒，放板1 上采样就断了；挪到板2，最多晚点上传，数据先进缓存。

实时性也在里面。板1 得保证 1Hz 稳定采样，网络重连、LCD 刷新这种长耗时操作不能拖累它，拆开后它只做采集和发送，任务周期能稳在毫秒级。

### Q1.2 数据从传感器到 Qt 曲线，完整链路是怎样的？
**答：** 链路是五段。

板1 的 `vTaskSensor` 每 2 秒采一次，原始值滤波后放进 `s_q_sensor` 队列；`vTaskProcess` 取出来做阈值判定，带回差，生成告警位再放进 `s_q_result`；`vTaskComm` 负责组 20 字节帧，CRC16 从 `AA 55` 之后算到数据末尾，通过 USART3 交给 E22 模块。

板2 那边，`vTaskLoraRx` 用 `SYS_FRAME_Poll/Get` 收帧校验，合法帧进 `s_q_env` 队列，同时 `vTaskNet` 发 MQTT、`vTaskUi` 刷 LCD。

还有一路是板2 的 USART1 把原始帧透传给 Qt，Qt 用 `FrameParser` 做同样的校验，进 `DataModel` 的环形缓冲，曲线和统计都从模型取数。

### Q1.3 三端怎么保证协议理解一致？
**答：** 我给它定了个单一事实源，然后两边互相验。

结构体定义只有一份，在 `FWLIB/inc/sys_frame.h`，板1、板2 各放一份拷贝但内容一致，Qt 侧 `frameparser.h` 按同一套布局解析。

固件算完 CRC，我再写一份 Python 的 CRC16-MODBUS 独立复算，两边对上才算通过，这样能避开固件算错、Qt 也跟着错的自洽性陷阱。

另外有个 `--selftest`，专门拿变异用例试解析器，比如把帧头改成 AAAA、CRC 改一位，看它会不会拒绝。

### Q1.4 这个项目最大的技术难点是什么？
**答：** 最难的不是某个 API，是三端之间的时序和状态得对得上。

拿补传来说，板2 要从 W25Q128 读一条缓存，发 MQTT，等 CONNACK，再写回读指针，中间任何一步掉电都得能接着来。所以我把记录做成头部计数加整条 20 字节定长，没用可变长，恢复的时候好找断点。

命令应答也是这个道理。每条下行命令都要回 ACK，超时就重发，靠 `cmd + 0x80` 那个应答位区分请求和应答。

---

## 2. 板1 检测端

### 2.1 时钟与启动

### Q2.1 STM32F407 的时钟树你是怎么配的？168MHz 怎么来的？
<!--code: sys_clock.c:30-40 -->
**面试官想听：** 是否真懂时钟树，而不是抄 `SystemInit`。

**答：** 我走的是 HSE 8MHz 进 PLL 这条路。`PLLM=8`，8/8 得 1MHz 输入，`PLLN=336` 把 VCO 抬到 336MHz，`PLLP=2` 分频出 SYSCLK 168MHz，`PLLQ=7` 给 USB/SDIO 48MHz。

总线这边 `AHB=168MHz`，`APB1=42MHz` 走 4 分频，`APB2=84MHz` 走 2 分频，APB1 的上限就是 42。

Flash 必须配 `FLASH_Latency_5`，168MHz 要 5WS，不配会跑飞。

这些都封在 `FWLIB/src/sys_clock.c` 的 `SYS_CLK_ToHighSpeed()` 里，启动后我会打印 `HCLK = 168 PCLK1=42 PCLK2=84`，算是板1进度文档阶段2 的验收证据。

追问过为什么 APB1 只能 42MHz：芯片规格就这么定的，超了会挂。USART2/3、I2C1/2 都挂在 APB1，所以算波特率得用 42MHz，不是 84。

### Q2.2 上电到 main 之间发生了哪些事？
**答：** 上电先走复位向量，进 `SystemInit()`，它开 FPU、设向量表基址，然后到启动文件的 `__main`，把 `.data` 段拷到 RAM、把 `.bss` 段清零，最后才进 `main()`。

有个细节，栈大小是在启动文件里定死的，`startup_stm32f40_41xxx.s` 里的 `Stack_Size` 管的是主栈；FreeRTOS 的任务栈是从堆里分的，这两回事，别混。

### Q2.3 为什么 `SYS_NVIC_Init()` 必须在所有中断打开之前调？
<!--code: sys_nvic.c:12-40 -->
**答：** 因为它设的是 NVIC 优先级分组，`NVIC_PriorityGroup_4`，4 位全给抢占优先级。分组一定下来，中断已经使能了再去改，已配置的优先级含义就乱了。

所以我固定按这个顺序：时钟、NVIC 分组、外设初始化、开中断、启调度器。

这个坑我踩过。板1 阶段 3 刚上 FreeRTOS 时串口没反应，原因之一就是漏了 `SYS_NVIC_Init()`。

### 2.2 FreeRTOS

### Q2.4 板1 分了几个任务？优先级怎么定的？
<!--code: main.c:959-979 -->
**面试官想听：** 任务划分是否有依据，而不是照抄教程。

**答：** 分了六个任务，优先级数字越大越急。职责和为什么这么定，放一张表里看更清楚：

| 任务 | 栈 | 优先级 | 职责 | 为什么这个优先级 |
|---|---|---|---|---|
| `vTaskMonitor` | 384 字 | 5 | 100ms 报心跳、喂狗、5s 打统计 | 最高：心跳断 2 秒就要判故障，必须最先跑 |
| `vTaskComm` | 512 字 | 4 | 组帧、CRC、发 LoRa | 次高：发送有节拍，晚了下游就断流 |
| `vTaskSensor` | 640 字 | 3 | 采 5 路传感器 | 中：2 秒一次，不急着抢 |
| `vTaskLoraRx` | 512 字 | 3 | 收下行帧 | 中：轮询 + 中断收字节 |
| `vTaskProcess` | 512 字 | 3 | 滤波、阈值、告警位 | 中：跟着采集走 |
| `vTaskUi` | 512 字 | 2 | OLED 显示与按键 | 最低：人机界面不赶采样节拍 |

数据流就是采集、处理、发送，中间拿两个队列解耦：`s_q_sensor` 深度 4，存 `SensorMsg_t`；`s_q_result` 也是 4，存 `ProcResult_t`。UI 只读全局变量，不占队列。

### Q2.5 队列深度为什么是 4，不是 8 或 2？
<!--code: main.c:959-960 -->
**答：** 是按一拍里生产和消费的差算的。采集 2 秒一次，处理只要几毫秒，正常时候队列几乎是空的；深度 4 是留给处理任务被更高优先级任务暂时打断的余量。

2 太浅，偶发抖一下就会丢帧；8 又太深，会把问题盖住——队列长期贴着满值，本身就说明消费端有毛病，该暴露出来。

阶段 9 的验收判据我专门写了，两个队列要在 0~1 之间波动，而不是稳定在满值 4。

### Q2.6 静态创建和动态创建任务，你选哪个？堆多大？
<!--code: FreeRTOSConfig.h:34 -->
**答：** 我用的是动态创建，`xTaskCreate` 加 `heap_4.c`，`configTOTAL_HEAP_SIZE = 30KB`。

六个任务栈加起来 `640 + 512×4 + 384 = 3072 字 = 12288 B ≈ 12KB`，再加 TCB、队列，30KB 还有余量。

`heap_4` 会把相邻空闲块合并，比 `heap_1` 不能释放、`heap_2` 不合并都合适。代价是分配时间不确定，所以运行中我不动态创建任务，启动阶段一次建完。

追问怎么确认没爆：`uxTaskGetStackHighWaterMark()` 每 5 秒打一次每个任务剩余的最小栈，单位是字，低于 30 就要加；`configCHECK_FOR_STACK_OVERFLOW = 2` 会在栈尾放魔数，溢出直接进钩子。

### Q2.7 你踩过的那个"串口打印半句就停"的坑，完整讲一遍
**面试官想听：** 定位方法论——能不能从现象推到证据。

**答：** 现象是板1 上电后串口打印到 `HCLK = 168` 就断在半句，LED 也不按 500ms 闪。

我按顺序排的。先排除硬件，用示波器和万用表看供电，5V 和 3.3V 都正常，不是欠压复位。然后看现场，J-Link 挂上去 halt，`regs` 显示 `IPSR=3`，已经是 HardFault，`CFSR` 有有效位。接着反推位置，把 `PC/LR` 拿到 `Listings/标准模板.map` 里查符号，落在 SysTick 处理函数里。最后查符号归属，map 里有一行 `Removing sys_tick.o(i.SysTick_Handler), (16 bytes).`，同时 `startup_stm32f40_41xxx.o(RESET) refers to port.o(i.SysTick_Handler)`，说明链接器把弱符号删了，用的是 FreeRTOS `port.c` 里的强符号。

根因链是这样：`FreeRTOSConfig.h` 里 `#define xPortSysTickHandler SysTick_Handler`，`port.c` 就定义了一个强符号；我的 `main()` 又在 `vTaskStartScheduler()` 之前调了开 SysTick 中断的初始化，`SYS_CLK_ToHighSpeed()` 内部会 `SYS_RTOS_SYSTICK_RELOAD()`，第一个 tick 进来时 `pxCurrentTCB` 还是 NULL，访问空指针进 HardFault，最后 `sys_fault.c` 里 `for(;;)` 静默停机。

修法是把那一行宏注释掉，让弱符号重新生效。注意必须 Rebuild，不能增量 Build，旧的 `port.o` 还在。

追问过为什么不干脆关掉 SysTick 中断。我试过，`systick_ms` 不涨，`SYS_TICK_Delay_ms()` 会死等，按下葫芦浮起瓢。根子在于 RTOS 的 tick 和裸机延时共用 SysTick，上了 RTOS 就该统一用 `vTaskDelay`。

### Q2.8 tick hook 里能干什么，不能干什么？
**答：** `vApplicationTickHook()` 跑在 SysTick 中断上下文里，所以带阻塞的 API 一个都不能调。`vTaskDelay` 不行，等信号量不行，`printf` 打大段也不行。

板1 里它只干两件事：`LED_BlinkUpdate()` 是纯 GPIO 计算，微秒级；`SYS_STATUS_Tick()` 推几个计数器。板2 也用它推指示灯状态机。

我往里放东西之前会问自己两句：这段能不能在 1ms 内跑完，会不会调 FreeRTOS 的阻塞 API。两条都过了才放。

### Q2.9 优先级反转了解吗？你这个项目里会不会发生？
**答：** 会，不过概率很低。

像我这个场景，`vTaskProcess` 是中优先级、持有某个资源，`vTaskSensor` 同优先级不需要它，`vTaskMonitor` 高优先级要等这个资源，中间再插进来一个中优先级任务，高优先级就被拖得更久。

规避办法是任务之间只走队列，不共享带锁的资源。唯一的共享是 `printf` 那路串口，阶段 5 我踩过多任务打印交织成乱码的坑，后来把打印集中到 Process 一个任务里做；阶段 8 之后如果还要多处打印，就得加互斥量。

### 2.3 I2C 与外设驱动

### Q2.10 I2C 只用两根线，多个器件怎么区分？
**答：** 靠 7 位地址，再加每个器件自己的地址引脚。

I2C1 我用 PB8 做 SCL、PB9 做 SDA，开漏加外部上拉，上面挂了四个器件：BMP280 是 `0x76`，SDO 接地，接 3.3V 就变 `0x77`；BH1750 是 `0x23`，ADDR 接地；CCS811 是 `0x5A`，ADDR 接地，接高是 `0x5B`；SHT30 是 `0x44`，ADDR 接地，接高是 `0x45`。

上电我先跑 `SYS_I2C_Scan()` 把在线地址列出来，扫不到就先查线和地址，别急着调驱动。

### Q2.11 I2C 总线死锁是怎么回事？你怎么恢复的？
**面试官想听：** 知不知道 I2C 的经典故障模式。

**答：** 现象挺怪：外设全拔了，`SYS_I2C_Scan()` 还是 0 个器件。读 `GPIOB_IDR` 才发现 PB8（SCL）= 0，一直被人拉低。

原因是主机在传输中途复位了，比如下载时断电，从机还停在读一位的状态，SDA 被它拉着等 SCL，主机这边却认为总线空闲，典型的 I2C 死锁。

恢复我写了个 `I2C_BusRecover()`。先把 PB8/PB9 从复用开漏切成普通开漏输出，手动给 SCL 发 9 个时钟脉冲，够从机把一个字节移完；再补一个 STOP，SCL 高的时候让 SDA 从低到高；最后切回复用功能，重新 `SYS_I2C_Init()`。验证是扫描从 0 个恢复到 3 个，板载的 0x1A 音频、0x50 EEPROM、0x68 MPU6050 都回来了。

这里有个真坑。第一版恢复函数里我用了 `delay_us(5)`，结果卡在第二个脉冲就再也不动。因为这个工程的 `delay_us` 依赖 DWT，而那时候时钟还没配好。换成空循环 `for(i=0;i<50;i++)` 就正常了。另外这工程的 CMSIS 头文件里 `GPIO_TypeDef` 没有 `BSRR` 字段，只能用 `GPIO_SetBits/ResetBits`，写 `->BSRR` 直接编译不过。

### Q2.12 I2C 400kHz 为什么后来降到 100kHz？
<!--code: main.c:487 -->
**答：** 400kHz 是快速模式的上限，但它要求总线电容小、上拉够强。

我的板子是内部上拉，大概 40kΩ，加 20cm 排线和四个器件，边沿上升太慢，偶发 NACK。降到 100kHz 就稳了。代价是读一个 6 字节操作从约 0.2ms 变成 0.8ms，可采集是 2 秒一次，完全没影响。

我一般的原则是先求稳再求快，速度真成瓶颈了再说。

### Q2.13 SHT30 怎么读？为什么用 `0x24 0x06` 而不是 `0x24 0x00`？
<!--code: sys_sht30.c:125-160 -->
**面试官想听：** 有没有读懂数据手册，而不是抄例程。

**答：** 这两个命令的差别就在时钟拉伸。`0x24 0x00` 是开启时钟拉伸（clock stretching），测量期间从机会把 SCL 拉低，主机必须支持拉伸才读得到；我的驱动是发命令、延时、再主动读，不支持拉伸，用这个会一直读到 NACK，严重了就卡死。`0x24 0x06` 是关闭拉伸，主机自己等 15ms 再来读，简单也可靠，所以我用后者。

流程是 `WriteCmd(0x24, 0x06)`，`delay_ms(15)`，`ReadRaw(6 字节)`，每 3 字节做一次 CRC-8，多项式 0x31、初值 0xFF，然后换算：`T = -45 + 175 × raw/65535`，`RH = 100 × raw/65535`。

追问过 CRC-8 为什么能抓错：单字节翻转、整字节冗余都能检出，比只比长度可靠得多；代价是每次读多 2 字节。

### Q2.14 CCS811 上电后一直读不到，是什么原因？
**答：** 先看 nWAKE，这脚得拉低，这脚悬空时芯片根本不进 I2C 模式，连扫描都扫不到。上电等 20ms，然后看 `HW_ID` 必须是 0x81，再看 `APP_VALID`，最长要等 1000ms。还有就是 TVOC/eCO2 要 24~48 小时老化，新片子读出来 400/0 是量程下限，不是坏了。我第一次就是贴在地板上以为坏了，其实是没老化。

### Q2.15 BMP280 和 SHT30 都测温度，读数差 0.8℃ 正常吗？以谁为准？
**答：** 正常。BMP280 本来是气压传感器，温度是顺带测的，芯片自己发热会让读数偏高 1~3℃，差 0.8℃ 不奇怪；SHT30 是专门的温湿度传感器，精度 ±0.3℃。所以项目里温度和湿度以 SHT30 为准，BMP280 只取气压。选型的时候得看清每个器件的主计量是什么。

### Q2.16 为什么最后放弃了 MQ-135？
**答：** 不是软件的事，板子没有空闲 ADC 脚了。我对着原理图查的：PA5 接了板载电位器；PF3~PF5 给了 FSMC，也就是 LCD；PF6 是 GBC_KEY；PF7 焊死了板载光敏，R22 10k 上拉，LS1 下拉，R24 1k 串到脚上。要么拆 R24 动硬件，要么换板子。最后决定这一路固定填 0，注释里写明原因。

面试里我一般会主动说这个：需求被硬件约束砍掉时，要留证据和原因，而不是假装实现了。

### 2.4 数据处理

### Q2.17 滤波怎么做的？为什么用滑动平均而不是卡尔曼？
**答：** 用的是长度 8 的滑动平均，`Filt_t` 里一个 8 点环形缓冲加一个累加和。板1 是 2 秒采一帧，8 个点就是 16 秒的窗口，群延迟约 8 秒——曲线不抖了，但代价是突变要等十几秒才反映出来。传感器噪声以白噪声为主，卡尔曼要建模、要调参，在我这个精度要求下性价比不高。

具体实现就在 `main.c` 的 `filt_push()` 里（`main.c:312`）：`Filt_t` 里一个 `int32_t buf[8]`、一个累加和 `sum`、一个写指针 `idx`，新值进来先减去最旧的那个、加上新值、指针模 8 前进，返回 `sum / cnt`。`FILT_N = 8`（`main.c:51`）。

有两个细节：前 7 帧 `cnt` 在涨，除的是实际个数，不是补零除 8，所以开机不会先掉到 0；除法是整数截断，温度 ×100 后差 1 就是 0.01℃，影响不大。坏帧在进滤波前就用 `valid` 位挡掉了，但单个野值没有做限幅或中值剔除，真出现尖峰还是会进平均——这是我后来觉得该补的地方。

要是做快速响应，比如烟雾报警，滑动平均的延迟反而成了缺点，那就该换中值滤波加一阶低通的组合。

### Q2.18 阈值判定为什么要加回差（迟滞）？
<!--code: main.c:324-345 -->
**面试官想听：** 会不会想到"抖动"这个工程问题。

**答：** 阈值卡在边界上，数值在 25.99/26.01 之间抖，告警就会疯狂翻转，LED 闪、蜂鸣器响、日志刷屏。

回差的做法是上限用 `> 26.00` 触发，但恢复要 `< 25.00`，中间这 1℃ 是保持带。

验收方法我写在进度文档里：临时把阈值改成 26.00，用手捂着传感器让读数在边界来回，告警位只翻转一次就算通过。

### Q2.19 告警位为什么用一个字节的 bitmap，而不是多个 bool？
<!--code: main.c:65-70 -->
**答：** 一个是省 RAM，`ProcResult_t` 要在队列里传，越小越好。另一个是组帧方便，12 字节 payload 里本来就要放一个状态字节，bitmap 直接塞进去就行，不用逐个打包。

位定义是 bit0 温度高、bit1 湿度高、bit2 气压异常、bit3 光照低、bit4 TVOC 高，低位算低告警。

### 2.5 协议与 LoRa

### Q2.20 20 字节帧的格式讲一下，为什么这么设计？
**答：** 格式是 `AA 55 | CMD 1B | LEN 1B | DATA 12B | CRC16 2B | 55 AA`。

帧头和帧尾是双保险，错位时能快速重新同步。长度字节留着以后扩 payload，解析器不用改。CRC 用 CRC16-MODBUS，初值 0xFFFF、多项式 0xA001、低字节在前，计算范围是 CMD+LEN+DATA，不含帧头帧尾。12 字节数据里，温度 ×100、湿度 ×100、气压 ×10、光照、TVOC、MQ-135，各占 2 字节，大端。

为什么定长：1Hz、20 字节，LoRa 空速 2.4kbps 下空中时间约 107ms，定长好算占空比；变长一旦丢包，很难判断是丢了还是没发完。

### Q2.21 CRC 你自己怎么验证算对了？
**答：** 两边独立算。固件里 `SYS_FRAME_BuildEnv()` 算一遍；我再按同一个多项式用 Python 独立写一遍，拿同一组数据比对。

然后做变异测试：把帧头改成 `AA AA`、CRC 改一位、长度改错，确认 `SYS_FRAME_Verify()` 分别返回 1/4/3。第三点很关键，只测正确的能过不够，还得测错误的必须被拒。

### Q2.22 LoRa 模块 E22-400T22D 怎么配置的？AT 指令还是寄存器？
**面试官想听：** 会不会区分型号，有没有读手册。

**答：** 这模块没有 AT 指令，是寄存器指令体系。这里还有个型号坑：`E22-400T22D` 是寄存器版，配置用 `C0` 写、`C1` 读、`C2` 写临时寄存器掉电失效、`CF CF` 做无线配置；`E22-400T22S` 才是 AT 固件版，能用 `AT+VER` 这类命令。我一开始按 S 版写了 `LORA_E22_SendAT()`，后来对着模块回包才发现 D 版不认。

配置流程是 `M1=高、M0=低` 进配置模式，只支持 9600 8N1，发 `C1 00 09` 读 10 个寄存器，解码，再用 `C0` 写回，最后退出配置模式。

追问过怎么确认读对了，模块回的是 `C1 00 09 00 00 00 62 00 17 03 00 00`。00H/01H 地址 `0x0000`；03H = `0x62`，就是串口 9600 8N1、空速 2.4kbps；04H = `0x00`，分包 240 字节、发射功率 22dBm；05H = `0x17`(23)，信道 23，频率 410.125 + 23 = 433.125MHz；06H = `0x03`，透明传输模式。两块板子读出来逐字节一致，所以能直接互通。

### Q2.23 LoRa 发送为什么必须先等 AUX 空闲？
<!--code: lora_e22.c:217-240 -->
**答：** AUX 是模块的忙指示，低电平表示它正在处理，发射、接收、配置都算。串口 9600 灌 20 字节只要 21ms，可空中 2.4kbps 发 32 字节要 107ms，串口比空中快 4 倍，连着发会把模块内部缓冲冲爆，表现就是丢包或者乱码。所以每帧发送前我都会调 `LORA_E22_WaitReady()`：接了 AUX 就等它变高，超时放弃这一帧并计数；没接 AUX 就固定延时 2ms 兜底。

这里有个真坑。这个 API 的语义是返回 1 表示已空闲，我一开始写成 `if (WaitReady(...) == LORA_E22_OK)`，`OK` 是 0，判反了。结果每一帧都走进 AUX 一直忙、本帧放弃的分支，一帧都发不出去。这种布尔语义反了的 bug 编译不报错，只能靠计数器和日志发现。

**事实边界：** 我这版两块板的 AUX 都没接——板1 的 AUX 宏在 `lora_e22.h` 里被注释掉，板2 的 PE7 要留给 LCD 的 FSMC_D4，所以 `lora_cfg.aux_port == 0`，走的是固定 2ms 延时兜底。面试别把它讲成「我一直在等 AUX」，被追问引脚就尴尬了。

### Q2.24 1Hz 发送，占空比大概多少？会不会违规？
**答：** 20 字节帧加上帧头开销按 32 字节算，是 256 bit，2.4kbps 下大概 107ms。1 秒一帧占空比约 11%，2 秒一帧约 5%。

国内 470MHz 频段对占空比有限制，433MHz 属于 ISM，通常要求 <10% 或者按地区规定，所以我实际用了 2 秒一帧。

要是改 03H 寄存器换更大的空速，空中时间能压到 30ms 以内，但两块板子必须同时改，不然收不到。

### Q2.25 为什么 LoRa 一定要先接天线再上电？
**答：** 发射的时候功率放大器输出端等于开路，驻波全反射回 PA，很容易烧功率管。这是硬件常识，我在接线说明里写死了。

### 2.6 可靠性设计

### Q2.26 看门狗怎么用的？为什么是 4 秒？
**答：** 用的片内 IWDG，LSI 32kHz，独立于主时钟，主频跑飞了它也能复位。4 秒是按最长正常阻塞定的：采集一轮最坏约 200ms，LCD 刷新才几毫秒，4 秒足够宽松，卡死后也能在 4 秒内恢复。

喂狗只放在监控任务里，它优先级最高、周期 100ms，别的任务不喂。这样任何一个任务卡死，监控任务也拿不到 CPU，狗就会复位，不会出现某个任务死了别人还在喂狗的假活。

4 秒也不是拍脑袋填的。`SYS_WDG_Init()` 按 `4<<PR` 从 4 分频往上试，找到第一个能让重载值 ≤4096 的档：4000ms 落在 PR=3（32 分频），RLR=3999，实际超时 4000×32/32000 = 4.000s（`sys_wdg.c:34`）。喂狗就一句 `IWDG_ReloadCounter()`（`sys_wdg.c:74`），调用点只有 `vTaskMonitor` 的 100ms 循环（`main.c:685`，初始化在 `main.c:989`），别的地方调不到。

WWDG 我也封了 `SYS_WDG_WwdgInit()`，但项目没用。窗口看门狗要求“不能喂太早也不能喂太晚”，适合必须严格按节拍运行的场景；我这里只要防卡死，IWDG 更省事。

追问调试时怎么办：`sys_wdg.h` 里 `SYS_WDG_DEBUG_FREEZE = 1`，会自动置 `DBGMCU->APB1FZ` 的 IWDG 停止位，调试器一暂停狗也暂停，不会在断点上被复位。

### Q2.27 怎么区分"这次复位是谁干的"？
<!--code: sys_wdg.c:82-110 -->
**答：** 读 `RCC_CSR` 里的复位标志位，`IWDGRSTF`、`BORRSTF`、`PORRSTF` 这些，用 `SYS_WDG_ResetCause()` 取出来，`SYS_WDG_ResetCauseDecode()` 转成字符串打印，打完再 `SYS_WDG_ClearResetFlags()` 清掉，免得下次误判。

我真靠这个抓到过问题。板1 接 LoRa 用 3.3V 供电时，`RCC_CSR` 里 `BORRSTF` 置位，`CYCCNT` 只有 0.36 秒，而实际已经上电 5 秒，说明芯片在反复欠压复位，不是软件 bug。换成 5V 独立供电就好了。

### Q2.28 指示灯状态机是干什么的？为什么值得单独做个模块？
<!--code: sys_status.c:53-120 -->
**答：** 因为板子没反应是最难排查的状态，我得让肉眼能区分三种情况。BOOT 是四灯流水，0.2 秒一步，说明还在初始化，别急着断电；RUN 是 LED3 慢闪，说明调度器跑起来了；FAULT 是 LED0 常亮代表硬件异常，或者四灯快闪 3 次，表示上次是看门狗复位。

实现放在 `sys_status.c`。BOOT 阶段用 `delay_ms_dwt` 推进，那会儿还没有 RTOS 节拍；RUN 阶段由 1ms tick hook 推进，2 秒没收到 `SYS_STATUS_Heartbeat()` 就进 FAULT 并锁存。

这里也有个真坑。我一开始把 BOOT 做得很慢，四步各 500ms，用户按复位后看到 LED0 亮 3.5 秒，以为卡死了。改成 200ms 一步、总共 0.8 秒后就正常了。给人看的东西，响应时间也是需求。

### Q2.29 HardFault 了怎么留下现场？
<!--code: sys_fault.c:105-150 -->
**答：** `SYS_FAULT_Init()` 把 HardFault、BusFault、UsageFault 的处理都注册上。进异常以后，先从事先压好的栈帧里把 `R0-R3、R12、LR、PC、xPSR` 取出来，用的是 `MSP` 还是 `PSP`，看 `EXC_RETURN` 的 bit2；再读 `CFSR/HFSR/MMFAR/BFAR`，判断是取指、数据访问还是未对齐；最后把现场通过串口打出来，然后 `for(;;)` 停机等看门狗复位。

有了 PC 值再去 map 里查符号，基本一步定位。我定位 SysTick 那个 bug 就是这么干的。

### Q2.30 栈溢出怎么防？
<!--code: freertos_hooks.c:26-45 main.c:686-695 -->
**答：** 栈这块我层层设防。`configCHECK_FOR_STACK_OVERFLOW = 2`，创建任务时在栈尾写魔数，切换时校验，被踩了就进 `vApplicationStackOverflowHook`；`uxTaskGetStackHighWaterMark()` 每 5 秒打一次剩余最小栈；栈大小按最坏路径估，`vTaskMonitor` 给 384 字，也就是 1.5KB，因为它要调 `printf`，我就把打印频率降到 5 秒一次，再实测水位。

### 2.7 调试与工具链

### Q2.31 `Error: Flash Download failed - "Cortex-M4"` 你是怎么解决的？
**面试官想听：** 有没有排除法的思路，而不是乱试。

**答：** 这个错误 μVision 只给一句笼统的话，只能自己分层排。

先用 J-Link 命令行绕开 Keil：`JLink.exe` 里 `device STM32F407ZE`，`erase`，只花了 0.019 秒，读回 Flash 全是 `0x00000000`，正常擦除后应该是 `0xFF`。这说明擦除是假的，芯片处于能连、不能擦、不能写的状态。

我判断是选项字节被写坏了，上次下载中途失败留下的。在 Commander 里执行 `unlock`，再 `erase`，这次花了 8.1 秒，是真擦除，读回 `FF FF...`，重新 `loadfile` 就成功了。

另外还查到两个配置问题：工程里 `<Flash2>BIN\UL2CM3.DLL` 是 ULINK2 的驱动，实际用的是 J-Link，界面上切过但没 Ctrl+S 保存；还有 Flash 算法挂的是 1024KB 版本，芯片只有 512KB，代码才 33KB，碰不到不存在的扇区，所以不是主因。

追问过为什么不直接说 Keil 坏了：J-Link 命令行能烧、Keil 不能，说明芯片和探针都是好的，问题在 Keil 的下载配置或者芯片状态，这个交叉验证一秒钟就能缩小范围。

### Q2.32 你怎么看 map 文件？
**答：** 我主要看三个地方。查符号地址，HardFault 拿到 PC 后在 map 里搜地址区间，定位到函数，比如 `0x080047F5 delay_us size=46`；看谁被链接器删了，`Removing xxx.o(i.SysTick_Handler)` 这种行就是弱符号被强符号顶掉的证据；看内存分布，Code、RO、RW、ZI 各多大，栈和堆在哪，判断还剩多少余量。

### Q2.33 串口调试你踩过什么坑？
**答：** 踩过两个。一个是读错端口，拔插 USB 后 CH340 的 COM 号会变，COM9 和 COM7 来回跳，有时显示 0 字符，其实是读了个不存在的口。另一个是串口助手独占，sscom 开着，Python 脚本就打不开，反过来也一样。所以我现在先枚举串口，`build_flash.list_serial_ports()`，读之前确认没别的程序占着。

### Q2.34 编译报 `L6218E: Undefined symbol SYS_SHT30_Init` 是怎么回事？
**答：** 典型的头文件包含了、源文件没加进工程。我把 `sys_sht30.c` 放进了 `FWLIB/src/` 目录，但 Keil 的工程文件里没有对应的 `<File>` 条目，它就不参与编译，链接时自然找不到符号。

解决是在 `.uvprojx` 的 FWLIB 组里加上文件条目，或者在界面里 Add Existing Files，重编就 0 Error。教训是新建源文件后必须确认它在工程的编译列表里，光放进目录没用。
---

### Q2.35 “一按复位就卡死”，插着仿真器必现、拔掉就好 —— 这是怎么回事？

**面试官想听：** 知不知道调试器会改变目标状态（而不是只“看”）。

**答：** 现象是板1 烧完程序后按复位，串口只打印到 `[board1] boot...` 就停住，LED 也不按预期闪；把 J-Link 的 USB 线一拔，复位立刻正常。

根因是 J-Link 连着的时候，内核被调试器按在 halt 状态。调试器通过 SWD 连上目标后会置 `DHCSR` 的 `C_HALT`，有的还会置 `DEMCR` 的 `VC_CORERESET`，也就是复位后保持 halt，内核停在原地不动，直到调试器发 Go。μVision 退出调试时如果选了不释放目标，或者干脆异常退出，内核就一直躺在那儿。

怎么区分真死机和被调试器按住，我一般看四条：读 `RCC_CSR` 的复位标志，有 `IWDGRSTF` 或 `PORRSTF` 说明真的在复位循环，全 0 就不是复位问题；间隔 3 秒读两次 `xTickCount`，不涨说明内核根本没在执行；用 J-Link 发一条 `g` 后 tick 开始涨，那就实锤是被 halt 住的，不是程序 bug；串口停在固定的某一行，说明代码执行到那儿之后停住，也可能是真的卡住了，得结合第三条看。

板上实测的数据是这样：拔掉 J-Link 前读 `RCC_CSR = 0x00000002`，只有 LSION 位，没有任何复位标志；`xTickCount` 三次读数是 53853 → 56855 → 59856，每 3 秒 +3000，说明稳定运行；`s_state = 1`，是 RUN；`s_tx_ok = 30`，`s_dropCnt = 0`。而在用户按复位后的那次读数里，`xTickCount = 0`、`s_state = 0`，发 `g` 之后才涨起来。

教训有几条。调试器不是只读的，它会 halt 内核、改寄存器、冻结看门狗，甚至让芯片复位后不启动。排死机先分四类：没跑，被 halt 了；跑飞，HardFault；复位循环，看 `RCC_CSR`；卡在某个驱动调用里，看串口停在哪一行。交付给测试之前先拔掉调试器，不然你会花半天怀疑自己的固件。

追问看门狗会不会被调试器影响：会。`sys_wdg.h` 里 `SYS_WDG_DEBUG_FREEZE = 1` 会置 `DBGMCU->APB1FZ` 的 `DBG_IWDG_STOP`，调试暂停时看门狗也冻结，否则单步调试时狗会一直复位你。

### 2.8 定时器 / 串口 / SPI / GPIO 驱动

### Q2.36 你写过定时器驱动吗？PWM 输出怎么配、占空比怎么算？
**面试官想听：** 有没有自己算过 PSC/ARR，而不是照抄例程。

**答：** 写过，`FWLIB/src/sys_tim.c` 里把 TIM1~14 封了一层，PWM、定时中断、ETR 计数、输入捕获、输出比较都在里面。C 里没有类的概念，我实际是用一张 TIM 配置表当“对象”、一组函数当“方法”。主程序没拿硬件 TIM 干业务，采集靠 FreeRTOS 的节拍，这套驱动是我做外设练习和后面扩展时用的。

PWM 就两步：先把定时器时钟分频到合适的计数频率，再定一轮数多少个。`tim_calc_psc_arr()` 从 1 分频往上试，保证 ARR 不超过 16 位，PSC = div-1、ARR = clk/(freq×div)-1（`sys_tim.c:75`）。比如 APB1 的定时器时钟 84MHz、要 1kHz，1 分频 ARR 要 84000，超了，所以 div 取 2、PSC=1、ARR=41999。

占空比用千分比传，CCR = (ARR+1)×permille/1000（`sys_tim.c:285`），换频率时占空比不用重算。初始化是 PWM1、CCR 先给 0、开 ARR 预装载；TIM1/TIM8 还得 `TIM_CtrlPWMOutputs` 开 MOE，不开没波形（`sys_tim.c:210`）。

**加分/追问：** 运行中改频率要把各通道 CCR 按新旧 ARR 等比缩放，再 `TIM_GenerateEvent` 立即装载，不然占空比会跳一下（`sys_tim.c:311`）。

### Q2.37 输入捕获怎么实现的？测频率和占空比要注意什么？
**面试官想听：** 知不知道捕获是硬件干的，软件只算差值。

**答：** 硬件在边沿到来时把 CNT 抄进 CCRx，软件只读差值。`tim_cap_setup()` 把 PSC 按 tick_hz 配好、ARR 固定 0xFFFF，通道设成 DirectTI、不分频，滤波强度 0x0F（`sys_tim.c:664`）。比如 tick_hz 给 10000，一个数就是 0.1ms，两次上升沿的差值乘 0.1ms 就是周期；捕获中断里拿到的就是当次的 CCR 值（`sys_tim.c:410`）。

测占空比要换沿：先按上升沿捕一次，再用 `SYS_TIM_CaptureSetPolarity()` 切到下降沿捕一次，高电平时间除以周期（`sys_tim.c:793`）。

坑在量程：ARR 只有 16 位，满量程是 65536/tick_hz 秒，10kHz 下最多 6.55 秒。周期再长就得在中断里记溢出次数，或者把 tick_hz 降下来。我的驱动只给原始捕获值，换算放在应用层，就是不想把量程写死。

**加分/追问：** 捕获和比较共用 CCR、CCER，同一个通道只能选一种用法；TIM1/TIM8 的捕获中断走单独的 `TIM1_CC_IRQn`/`TIM8_CC_IRQn`，库内部已经分开处理了（`sys_tim.c:754`）。

### Q2.38 输出比较和 PWM 有什么区别？
**面试官想听：** 知不知道为什么有 PWM 了还要 OC。

**答：** PWM 本身就是输出比较的一种模式。PWM 模式在 CNT 小于 CCR 和大于 CCR 时自动给高低电平；比较模式只在 CNT 等于 CCR 那一刻做事——翻转、强置高/低，或者什么都不动只产生中断。

`SYS_TIM_OcInit()` 六种模式都能选（`sys_tim.c:868`）。项目里更常用的是“冻结 + 比较中断”当软定时器，不占引脚；或者 Toggle 模式输出 50% 方波，频率是 cycle_hz/2。真要调占空比还是走 `PwmInit + PwmSetDuty`，别拿 OC 硬凑。

**加分/追问：** `SYS_TIM_OcSetCompare()` 会把超范围的 CCR 按 ARR 封顶，不会写飞（`sys_tim.c:920`）。

### Q2.39 串口驱动是怎么封装的？为什么不用一个 Init 打天下？
**面试官想听：** 有没有封装意识，知不知道三种收法的取舍。

**答：** `sys_usart.c` 里一张 6 路配置表，把 USART1/2/3、UART4/5、USART6 的引脚、时钟、中断号、DMA 数据流全列出来，换板只改头文件宏，逻辑不用动（`sys_usart.c:36`）。

收有三套：轮询 `ReadByte`、中断 + 256 字节环形缓冲 `InitRxIT/RxRead`、DMA + 空闲中断 `RecvDMA`（`sys_usart.h:66`、`sys_usart.c:406`）。发也有三套：阻塞 `SendBuf`、DMA 非阻塞 `SendDMA`、带 128 字节内部缓冲的 `Printf`（`sys_usart.c:483`）。项目里调试口用轮询，LoRa 和 ESP8266 用中断环形缓冲，DMA 那套封好了但没开。

为什么不合成一个 Init：三种收法对 RAM、实时性和用法的要求不一样。板1 调试口轮询就够；ESP8266 的 AT 应答必须中断收，不然会丢；DMA+IDLE 适合不定长整帧，但不能和中断环形缓冲同时开。硬塞进一个接口，参数会变成一堆 bool，更容易配错。

**加分/追问：** 环形缓冲 head 在中断里加、tail 在主循环里加，用 `next != tail` 判满，牺牲一个字节换无锁（`sys_usart.c:246`）。缓冲从 64 提到 256，就是两帧连发时会丢字节（`sys_usart.h:62`）。

### Q2.40 GPIO 输入输出模式怎么选？推挽和开漏差在哪？
**面试官想听：** 会不会按外设电气特性选模式，而不是全用推挽。

**答：** 输出常用三种：推挽 + 不上拉（LED、片选）、开漏 + 上拉（I2C、DHT11 这种单总线）、复用推挽（串口 TX、PWM 脚）。`gpio_core.c` 里封了 `GPIO_OutInit` 和 `GPIO_OutInitOD`，复用是在各外设驱动里直接填 AF + 推挽，比如串口 TX（`sys_usart.c:91`）。

输入用 `GPIO_InInit(port, pin, pull)`，pull 传 1 上拉、2 下拉、其它浮空（`gpio_core.c:322`）。按键一端接地就配上拉，按下读 0；悬空输入必须给固定电平，不然读出来是随机的。

推挽能主动拉高拉低；开漏只能拉低，高电平靠外部上拉。单总线必须开漏，因为总线上可能同时有器件拉低，推挽对推挽会顶牛。内部弱上拉只有 30~50k，替代不了 4.7k 外部上拉，只能防浮空（`gpio_core.c:277`）。

**加分/追问：** 引脚老被重复初始化，我给 Out/InInit 加了 `GPIO_Claim()` 登记调用点，`GPIO_ClaimConflictCount()` 不为 0 就说明有冲突（`gpio_core.c:125`）。查 LCD 和 I2C 抢脚时比翻代码快。

### Q2.41 SPI 和 I2C 有什么区别？W25Q128 你怎么读写？
**面试官想听：** 两种总线不是背参数，而是知道什么时候选哪个。

**答：** 最直接的区别是引脚和速率：SPI 四根线（SCK/MOSI/MISO/CS），全双工、推挽、没有地址和应答，跑几十 MHz 很轻松；I2C 两根线，开漏加上拉，半双工，靠地址选器件、每个字节要 ACK，速率通常 100k~400k。器件多、走线短、要省引脚选 I2C；要速度或单向流式数据选 SPI。

项目里 W25Q128 挂在 SPI1 上，10MHz，CS 用 PB14（`w25qxx.h:14-18`）。SPI1 上还并了 NRF24L01，所以两个从机靠各自 CS 分时，谁拉低谁说话（`w25qxx.c:38`）。

读写按命令走：CS 拉低 → 0x03 读数据 / 0x02 页编程 / 0x20 扇区擦除 → 3 字节地址（高位先发）→ 数据 → CS 拉高。写之前必须先发 0x06 写使能，再轮询状态寄存器 bit0 等 BUSY 清掉（`w25qxx.c:9-22`）。NOR Flash 只能把 1 写成 0，所以写目标必须先是 0xFF，页是 256 字节、扇区 4KB，跨页要拆（`w25qxx.h:22-24`）。

**加分/追问：** SPI 没有 ACK，调试时“发出去没反应”先查 CS、时钟极性/相位（mode 0~3）和从机供电，别先怀疑代码。

### Q2.42 协议为什么不直接把结构体 memcpy 发出去？对齐和端序怎么处理？
**面试官想听：** 知不知道结构体布局不是协议。

**答：** 因为结构体的内存布局不是协议。不同编译器、不同对齐设置会在字段之间塞 padding，PC 和单片机算出来的长度都可能不一样；再加上端序，直接 memcpy 发出去，对端按同样结构体收都可能错位。

我的做法是协议层只认字节。发送时 `SYS_FRAME_BuildEnv()` 按偏移逐字段写，16 位统一走 `frame_put_u16_be()` 大端（`sys_frame.c:426/435`）；接收和 Qt 侧都按固定偏移解析（`sys_frame.c:396`），谁都不依赖编译器怎么排。

真要用结构体，至少加 `#pragma pack(1)` 或 `__attribute__((packed))`，再用 `offsetof`/`sizeof` 做编译期断言，收发两端共用同一份头文件；就算这样，端序还是得单独转，不能省。

**加分/追问：** W25Q 日志槽 32 字节也有类似约束：槽首 4 字节对齐、能整除 256 页和 4KB 扇区，代码里用 `#error` 在编译期卡住（`w25qxx_log.c:26-39`），免得以后改槽长把擦写时序弄坏。

### Q2.43 函数指针和回调在项目里怎么用的？
**面试官想听：** 知不知道回调用在什么上下文、有什么坑。

**答：** 定时器驱动里用得最多。`sys_tim.c` 给每个定时器留了捕获和比较两张回调表（`sys_tim.c:47-51`），`SYS_TIM_CaptureInitIT()` 注册回调，中断里直接 `tim_cap_callback[id](ccr)`（`sys_tim.c:410`）。这样驱动不用知道业务是谁，业务也不用改中断向量。

低功耗那边也有一个：`SYS_PWR_SetWakeCallback()` 注册唤醒回调，Stop 醒来恢复时钟后调用（`sys_pwr.c:18/43`），用来重配串口和定时器。

坑主要在上下文：回调是在中断里跑的，只能做短事，不能 `printf`、不能等信号量；注册要在开中断之前，重新初始化时记得把旧回调清掉，不然会跳到已经释放的函数。

**加分/追问：** 函数指针表比 `switch(id)` 好维护，加一路定时器只加表项，不改 ISR。

### Q2.44 低功耗做过吗？Stop 和 Standby 怎么唤醒，醒来要重配什么？
**面试官想听：** 分得清三档低功耗，知道醒来不是“接着跑”。

**答：** 这个项目是 5V 适配器常供电，业务上没进低功耗，但驱动我写了：`sys_pwr.c` 里 Sleep/Stop/Standby 三档都有。

Sleep 只停 CPU，外设照跑，任何中断都能唤醒。Stop 把时钟关掉，醒来先回到 HSI 16MHz，PLL、SysTick、串口、定时器都得重新配；`SYS_PWR_STOP_RESTORE_CLK` 打开时库会先把 168MHz 的时钟恢复（`sys_pwr.h:12`、`sys_pwr.c:29`）。Standby 最省，只留 WKUP(PA0)、RTC、IWDG，SRAM 内容全丢，唤醒等同于一次复位，所以进之前要先清唤醒标志（`sys_pwr.c:49`）。

真要做产品，我会先算占空比：采集 2 秒一次、LoRa 发一帧几十毫秒，大部分时间可以 Stop；唤醒源用 RTC 闹钟或外部中断，传感器和 LoRa 的电源用 MOS 管切掉，醒来再上电。电流要实测，不能只看手册。

**加分/追问：** Stop 醒来串口会丢波特率，必须先重配 USART 再打印，不然第一句话就是乱码。

### Q2.45 事件组、任务通知、软件定时器你用过吗？和队列、信号量怎么选？
**面试官想听：** 知不知道每种 IPC 解决什么问题，而不是全用队列。

**答：** 这个项目里只用了队列和互斥量，事件组、任务通知、软件定时器没用上——数据流是单向的，队列够用。但这几个我了解，选型按“传什么”来分。

队列传数据，信号量/互斥量管同步和互斥，事件组解决“多个条件都满足才往下走”，任务通知是给某一个任务发一个轻量信号，比队列快、省 RAM，但只能一对一。软件定时器是回调跑在定时器服务任务里，不是中断，适合按键长按、超时重连这种不要求微秒级精度的活；要精确时序还是用硬件定时器。

举个例子：五路传感器都采完才组帧，可以用事件组五个 bit，处理任务等 `xEventGroupWaitBits(..., pdTRUE, pdTRUE, ...)`；如果只是“采到了”一个事件，任务通知就够了。用错的地方通常是拿全局变量 + 轮询代替队列，结果加锁加出一堆临界区。

**加分/追问：** 任务通知的值是 32 位，可以当简易计数或状态位用；但它不能广播，多个任务等同一个事件还是得用事件组或信号量。

## 3. 板2 数据通信端

> 依据：`EnvMonitor/Project_2_数据通信端/Project/main.c`（668 行）、`FWLIB/inc/sys_frame.h`、`FWLIB/inc/w25qxx_log.h`、`FWLIB/inc/lora_e22.h`、`FWLIB/inc/esp8266.h`、`FWLIB/inc/mqtt.h`、`FWLIB/inc/sys_ind.h`、`FreeRTOS/port/FreeRTOSConfig.h`、`EnvMonitor/Project_2_数据通信端/数据传输端设计.md`。
> 一句话结论：板2 是**边缘网关**——LoRa 收板1 的 20 字节环境帧，校验后一路原样转发给 Qt 上位机、一路走 MQTT 上巴法云、一路带时间戳写进 W25Q128 环形日志，断网时全靠这份日志补传；它同时接受上位机 `0x10~0x16` 的下行命令。

---

### 3.1 架构与数据流

### Q3.1 板2 在整条链路里到底承担哪几件事？一帧数据的完整路径是什么？
**面试官想听：** 能不能不看文档画出数据流（设计 §1、§4.5）。
**答：** 板2 既收 LoRa 帧，又负责转发、缓存和监控。收帧这块要做帧同步和 CRC16 校验；转发放双路，串口给 Qt、MQTT 给巴法云；断网就缓存到 W25Q128，恢复后补传；另外还有看门狗和心跳监控。

一帧进来是这么走的：`LORA_E22` 收字节，`SYS_FRAME_Poll/Get` 解出 `CMD=0x01` 的 12 字节载荷，`SYS_FRAME_UnpackEnv` 拆出 6 个值，打包成 `EnvMsg_t`，里面带重组的 `raw[20]`，然后 `xQueueSend(s_q_env)`（`main.c:229`）。`vTaskNet` 消费（`main.c:393`），发布成功就走 `MQTT_PublishStr`，不成功且缓存开着就 `W25QXX_LogWrite`（`main.c:399`）。显示是 `vTaskUi` 用 `xQueuePeek` 旁路取最新值（`main.c:483`）。
**加分/追问：** 指出"转发"和"上云"在代码里其实是**同一个任务 `vTaskNet`**，与设计文档里 ForwardTask + CloudTask 的拆分不同；USART2 从未初始化，Qt 那条链路实际并到 `USART1` 上了（见 Q3.4）。

### Q3.2 为什么拆成 6 个任务，而不是一个大循环？
**面试官想听：** 对"阻塞点隔离"的理解，而不是背任务名。
**答：** 因为这六个任务的阻塞特性完全不一样，揉进一个大循环就互相拖。LoRa 是 20 ms 轮询（`main.c:240`），命令是 10 ms 轮询（`main.c:356`），网络是 `xQueueReceive` 1 s 超时（`main.c:393`），补传 50 ms 一条（`main.c:442`），显示 500 ms 一刷（`main.c:512`），监控 100 ms 心跳（`main.c:531`）。最要命的是 ESP8266 的 AT 交互，等 `>`、等 `SEND OK`，一问一答全程阻塞，每步都有超时，塞进转发路径会把 Qt 转发一起拖死。这是设计 §4.2 专门写的一段。
**加分/追问：** 真正的判据不是"任务多"，而是"最坏阻塞时间不超过你能容忍的抖动"；这里最差的是网络任务的 5 秒重连等待（`main.c:387`），但它只影响自己。

### Q3.3 队列 `s_q_env` 为什么深度是 8？显示任务怎么拿数据，为什么不直接 Receive？
**面试官想听：** 队列深度是算出来的还是抄的；生产者/消费者语义。
<!--code: main.c:281-292 main.c:493-495 main.c:629-631 -->
**答：** 板1 大概 2 秒一帧，队列深度 8 能兜住十几秒——网络任务被一次重连卡住时不至于立刻丢帧（`main.c:807`）。

显示任务不碰 `s_q_env`。`vTaskLoraRx` 收完一帧，除了入队，还把最新值拷进 `s_ui_env`、置 `s_ui_dirty`（`main.c:291-292`）；UI 只读这份快照（`main.c:629-631`）。真正的消费者是 `vTaskNet`（`main.c:493`），显示要是也 `Receive`，就会和网络任务抢帧，把该上云的帧吃掉。

**加分/追问：** 这份快照天然只保留“最新一帧”，网络任务慢时显示不会卡，但可能比实际晚一帧——这是用“显示略旧”换“不抢数据”的取舍。

### Q3.4 上位机现在接在哪一路串口？和设计文档一致吗？
**面试官想听：** 是否真读过 main.c，而不是照文档背。
**答：** 代码里只有 `SYS_USART_InitRxIT(DBG, DBG_BAUD)`（`main.c:600`），`DBG = SYS_USART_1`，115200（`main.c:42-43`）；命令收发、应答、转发全走这一路，USART2 一次都没初始化。

设计 §3.2 方案 A 写的是 USART2 给 Qt、USART1 只做日志，实际退回方案 B 的形态了，日志和二进制帧混在同一路。
**加分/追问：** 后果是 Qt 侧解析器必须靠 `AA 55` 硬同步抗噪；要真正分离，得在 main.c 里补 `SYS_USART_Init(USART2, 115200)` 并把三处 `SYS_FRAME_Send(DBG,…)` 改成 USART2。这是文档与代码的**已知偏差**，不是谁记错了。

---

### 3.2 关键字段与数据段

### Q3.5 `EnvMsg_t` 里已经存了解码后的 6 个值，为什么还要再存一份 `raw[20]`？
**面试官想听：** 是否理解"协议原样"与"业务字段"的分离。
**答：** `raw` 是丢进队列前用 `SYS_FRAME_BuildEnv` 重新组好的整帧（`main.c:224`），落盘和 0x15 补传都靠它。补传必须把原始 20 字节原封不动送到上位机，让上位机用自己的解析器校验，而不是信板2 转述的数字；那 6 个解码字段只服务于 LCD 显示和拼 MQTT 文本（`main.c:176`）。
**加分/追问：** 代价是每个队列元素 36 字节（20+6+6+4）；好处是补传链路与实时链路共用同一份字节，不会出现"实时和补传格式不一致"。

### Q3.6 时间戳为什么编码成 `hh*10000+mm*100+ss`？有什么坑？
**面试官想听：** 知道这个设计的边界。
**答：** `now_ts()`（`main.c:98-105`）把开机秒数折成一种带 BCD 味道的十进制，`hh*10000`+mm*100+ss。这样 4 字节放得下，人也能直接读，同一天内单调递增，排序就是时间序。

坑有三个。跨天会翻转，23:59:59 到 00:00:00 反而变小，按 ts 排序就错了；它不是 RTC，重启从 0 开始，靠的是运行秒数；它占的是 hh*10000 位，最大 235959，刚好塞进 4 字节。
**加分/追问：** 设计 §5.3 里 MQTT 报文干脆不带时间戳，由 Qt 收到时刻打时间——因为 20 字节帧里根本没有时间字段。

### Q3.7 20 字节环境帧逐字节怎么排？CRC 覆盖哪一段？
**面试官想听：** 能不能背出帧结构（不该背错）。
**答：** 帧是 `AA 55 | CMD(0x01) | LEN(0x0C) | DATA[12] | CRC16 低字节 | CRC16 高字节 | 55 AA`，`SYS_FRAME_OVERHEAD=8`（`sys_frame.h:44`）。DATA 里温度在偏移 0、湿度 2、气压 4、光照 6、TVOC 8、MQ135 10（`sys_frame.h:83-88`），每项 2 字节，大端。

CRC 用 CRC16-MODBUS，初值 0xFFFF、反射多项式 0xA001、末尾不异或，范围是 `CMD + LEN + DATA` 共 14 字节，不含帧头、CRC 自身和帧尾（`sys_frame.c:17-18`）。
**加分/追问：** 帧内 CRC 是**低字节在前**，而 `0x12` 应答里的多字节字段是**大端**——同一个协议里两种端序，靠注释写死（`sys_frame.c:9`、设计 §5.4:267）。

### Q3.8 温湿度为什么 ×100、气压为什么只 ×10？显示时怎么还原？
**面试官想听：** 定点数的范围意识。
**答：** 这三个值都是 `int16_t`（`EnvMsg_t` 定义在 `main.c:64-73`）。温度 -40~125℃、湿度 0~100%、气压 300~1100 hPa。气压 ×100 后最大 110000，早就溢出 int16 的 32767 了，所以只能 ×10，11000，安全。

显示的时候用 `m.temp_x100/100` 和 `%100` 拼成 `25.31`（`main.c:176-181`，`%02d` 补零）。
**加分/追问：** 负数要小心——`-531/100 = -5`、`-531%100 = -31`，拼出来是 `-5.-31`，所以负温度必须单独处理符号（当前代码直接拼，是个隐患）。

---

### 3.3 协议与信道

### Q3.9 为什么帧头用 `0xAA 0x55`、帧尾用 `0x55 AA`，还要再带 LEN 和 CRC？三重判据是不是浪费？
**面试官想听：** 重同步（resync）机制。
**答：** 串口是字节流，丢一个字节后面就全错位。帧头负责找到起点，LEN 负责长度和整帧自洽，典型错误就是两帧粘在一起，CRC 负责内容没错；三个都成立才交给应用（`sys_frame.c:15`）。

收错时状态机不阻塞也不回退，直接继续找下一个 `0xAA 0x55`，所以坏帧之后不用复位板子。
**加分/追问：** 帧尾 `55 AA` 是帧头的镜像，顺便提供一个"回扫"的定位点。

### Q3.10 命令字怎么分区？为什么应答是 `请求 | 0x80`？
**面试官想听：** 协议分层是否清晰。
**答：** `0x00~0x7F` 是板2 上报，环境帧 `0x01`、历史帧 `0x15`；`0x80~0xFF` 是应答，`SYS_FRAME_ACK_FLAG = 0x80`（`sys_frame.h:99`）。请求是 `0x10/0x11/0x12/0x13/0x14/0x16`，应答就是 `0x90/0x91/0x92/0x93/0x94/0x96`。这样一条规则就能从上位机侧判断这帧是不是自己发的命令的回音，不用维护两张表。
**加分/追问：** `0x80 | 0x16 = 0x96` 就是补传进度帧，`send_ack()` 统一做 `cmd|0x80`（`main.c:124-127`），只有 `0x96` 是显式写的常量（`sys_frame.h:127`）。

### Q3.11 `0x15` 历史帧为什么是 24 字节？为什么不只发解析后的 6 个值？
**面试官想听：** 补传语义是"搬运存档"而不是"重算"。
**答：** 0x15 是搬运存档，不是重算。`[0..3]` 是原始时间戳，大端，就是缓存时写进去的 `ts`；`[4..23]` 是原始 20 字节环境帧（`sys_frame.h:108/114-116`）。这样上位机拿到的补传帧和实时帧逐字节同构，同一个解析器、同一条去重逻辑就能用。

如果只发 6 个值，上位机得另写一套解析，而且丢了 CRC 就没法自证没坏。
**加分/追问：** 代价是 24 字节里有 20 字节是"别人已经解析过的内容"，带宽翻倍——但补传是离线场景，50 ms 一条只有 4.8 kbps，不心疼。

### Q3.12 `QUERY(0x12)` 的 16 字节应答怎么排？为什么这块是大端而 CRC 是小端？
**面试官想听：** 是否能讲清端序选择而不是"照抄"。
**答：** 应答是 16 字节：`[0]` 状态、`[1]` 转发开关、`[2]` 缓存开关、`[3]` 保留、`[4:6]` 收好帧、`[6:8]` 收坏帧、`[8:10]` 缓存条数、`[10:12]` 溢出丢帧、`[12:16]` 运行秒数（`sys_frame.h:149-157`）。多字节一律大端，用 `put_u16/put_u32` 写（`main.c:108-121`）。

理由很实际：业务字段按网络字节序走是通行做法；CRC 是链路层校验，MODBUS 既定格式就是低字节在前，两边不冲突。
**加分/追问：** `[3]` 留白是为了让字段落在偶数偏移上，方便以后加 16 位项。

### Q3.13 上巴法云为什么用 `#` 分隔的文本，而不是 JSON？
**面试官想听：** 知道选择的业务理由。
**答：** 巴法云能把消息直接推到微信服务号和小程序，`#25.30#48.55#1013.2#500#50#1234#02` 这种在手机上直接可读（`main.c:176-181`、设计 §5.3:248）；换成 JSON 还得多一层解析才能显示，而本项目的消费端就是人看一眼。

格式是 `#温度#湿度#气压#光照#TVOC#MQ135#节点号`，`NODE_ID = 2`（`main.c:60`）。
**加分/追问：** 代价是解析端不能容忍字段缺失——多一个 `#` 就错位；所以 `snprintf` 的 128 字节缓冲和格式串必须严格配套。

---

### 3.4 时序与时基

### Q3.14 `configTICK_RATE_HZ = 1000` 意味着什么？`pdMS_TO_TICKS` 在这里还是不是"转换"？
**面试官想听：** 节拍与延时的关系。
**答：** 1 tick 就是 1 ms（`FreeRTOSConfig.h:23`），所以 `pdMS_TO_TICKS(20)` 算出来就是 20，编译期常量，运行时没有代价。所有任务延时我都写 `pdMS_TO_TICKS(...)`，不写裸数字，将来改节拍不用全部重算。
**加分/追问：** 节拍 1 kHz 的代价是每次 tick 中断的开销；`vApplicationTickHook` 里因此只能放极短的东西——本项目放的是 `SYS_IND_Tick()`（`freertos_hooks.c:52-54`），两灯状态机。

### Q3.15 从板1 发出到 LCD 上看到数字，最坏要多久？瓶颈在哪？
**面试官想听：** 能把各段延时加起来。
**答：** LoRa 侧 20 ms 轮询（`main.c:240`），加队列传递，再加显示 500 ms 周期（`main.c:512`），最坏大约 520 ms。

瓶颈是显示刷新周期，不是串口或链路。20 字节在 9600 bps 下空口约 21 ms，转发 115200 下约 2 ms，都可以忽略。
**加分/追问：** 所以"让曲线更顺"该改的是显示周期，而不是调 LoRa 波特率。

### Q3.16 补传为什么定 50 ms 一条？清缓存为什么要停一下？
**面试官想听：** 速率是按对端能力定的。
**答：** 50 ms 一条就是 20 帧/秒（`main.c:442`）。上位机要逐帧解析、打时间戳、去重、重绘曲线，再快就开始丢；这个速率也远低于 115200 的线路能力，还给别的任务留了发送窗口。

清缓存慢是因为 W25Q128 按扇区擦。255 个扇区 × 4KB ≈ 1MB，`W25QXX_LogClearStep()` 每次只擦一个扇区，板2 逐次调用到 `done`；按典型 45ms/扇区算，满库清一次要十几秒，期间 `LogWrite` 返回 `W25QXX_LOG_ERR_BUSY`（`w25qxx_log.h:41`、`w25qxx_log.c:426`）。
**加分/追问：** `0x13` 清缓存前先把 `s_replay = 0`（`main.c:313`），避免一边补传一边擦——那会读到正在被擦的扇区。

### Q3.17 为什么上了 FreeRTOS 就不能再调 `SYS_TICK_Init()`？
**面试官想听：** 这是本项目真实踩过的坑，答得出说明真调试过。
**答：** `FreeRTOS/port/port.c` 里 `xPortSysTickHandler` 被 `#define` 成了 `SysTick_Handler`，是强符号，会把 `sys_tick.c` 里的 `__weak void SysTick_Handler` 顶掉。调度器没启动时 `pxCurrentTCB` 还是空，第一个 tick 进来就解引用空指针，HardFault，卡在 `for(;;)`。现象就是串口打半句就停、灯不闪。

所以 `main()` 里我只调 `SYS_CLK_ToHighSpeed()`，不碰 `SYS_TICK_Init()`，`main.c:593-595` 那句注释就是给这件事写的。
**加分/追问：** `SYS_CLK_ToHighSpeed()` 内部其实会开 SysTick，所以正确做法是"把 `xPortSysTickHandler` 那行 `#define` 注释掉，等阶段3 真正上 RTOS 再恢复"。

---

### 3.5 资源与并发

### Q3.18 六个任务的栈加起来多少？30KB 堆还剩多少？怎么验证？
**面试官想听：** 会算，且知道去哪查。
**答：** `512+512+1024+512+512+512 = 3584` 字，也就是 14336 B，差不多 14 KB（`main.c:649-654`，单位是字不是字节）。堆是 30 KB（`FreeRTOSConfig.h:34`），空闲任务还占 `configMINIMAL_STACK_SIZE = 128` 字（`:25`），余量大概 15 KB。

验证靠 `uxTaskGetStackHighWaterMark()`，监控任务每 5 秒打一次六个任务的剩余栈（`main.c:545-549`）。
**加分/追问：** `vTaskNet` 给了 1024 字（4 KB），因为它里面有 128 字节 `snprintf` 缓冲、AT 应答缓冲和 MQTT 组包——栈最大的任务不是最"重"的任务，而是缓冲最多的任务。

### Q3.19 三个任务同时往 `USART1` 发数据，会不会把帧和日志拼在一起？现在的防护在哪？
**面试官想听：** 抢占发生在字节之间——这是本项目文档专门论证过的一点。
**答：** 会。`SYS_FRAME_Send()` 是阻塞逐字节发（`sys_frame.c`），抢占只可能发生在字节和字节之间：单字节不会错，整帧会交错。结果是帧头对、CRC 必错，偶发还极难查。

设计 §4.3 为此定义了 `s_qt_tx_mtx` 互斥量，但当前 main.c 里没有这个互斥量。`vTaskCmd` 的应答（`main.c:281`）、`vTaskReplay` 的历史帧（`main.c:438`）、`vTaskMonitor` 的 `[MON]` 打印（`main.c:538`），三处并发写同一路串口。
**加分/追问：** 这是"文档写了、代码没落地"的典型缺口；修法是给所有 `SYS_FRAME_Send(DBG,…)` 和 `SYS_USART_Printf(DBG,…)` 套同一把 `xSemaphoreTake(s_qt_tx_mtx)`，或把发送统一收进一个"串口守护任务"。

### Q3.20 优先级为什么是 `lora=4 / cmd=4 / net=3 / replay=2 / ui=2 / mon=1`？监控任务最低合理吗？
**面试官想听：** 优先级反映"谁不能被谁等"。
**答：** 数字越大越优先。LoRa 和命令必须及时，收帧窗口短，上位机 600 ms 超时就重发，所以给 4；网络中等；补传和显示可以慢；监控只是打印和心跳，放最低。

但有个反直觉的地方：`SYS_IND` 的 2 秒没心跳就进 FAULT（`sys_ind.h:31`），靠的是 `vTaskMonitor` 每 100 ms 被调度（`main.c:528`），而它优先级最低。某个任务长时间占 CPU，就会误报 FAULT。
**加分/追问：** 更稳的做法是把心跳喂给多个任务，或者把监控提到中间层；这也是设计 §4.4 里"心跳位图"想要解决、但当前代码没实现的部分。

### Q3.21 这些计数器为什么都加 `volatile`？16 位计数器会不会读到"半个值"？
**面试官想听：** 中断/多任务共享变量的基本意识。
**答：** `s_rx_ok/s_rx_bad/s_pub_ok` 这些（`main.c:77-88`）被多个任务读写，`volatile` 防的是编译器把它们缓存进寄存器，导致读到旧值。

Cortex-M4 上对齐的 16 位、32 位变量读写是单条指令，天然原子，所以不会读到半个值。但哪天改成 `uint64_t`，或者做读改写，`++` 本身就是读-改-写，就必须用临界区或者原子操作。
**加分/追问：** `++` 在多任务下可能丢计数——本项目接受"统计值偶尔少 1"，因为它只用于观察，不参与控制逻辑。

---

### 3.6 容错与掉电

### Q3.22 断网的时候数据去哪了？断网 10 分钟能存多少？
**面试官想听：** 缓存路径与容量账。
**答：** `vTaskNet` 里发布失败、并且 `s_cache_on != 0`，就调 `W25QXX_LogWrite(m.ts, m.raw, 20)`（`main.c:395-402`）。

容量是 255 个扇区 × 4 KB ≈ 1020 KB，每槽 32 字节，正好 32640 条（`w25qxx_log.h:41`）。板1 约 2 秒一帧，断网 10 分钟约 300 条，写满大概 18 小时。写满后覆盖最旧的，`W25QXX_LogLost()` 会增长。
**加分/追问：** 设计文档 §6.1 写的"30 s 一条可存 16 小时"是上云节流口径；按每帧都落盘算，实际是 32640 条 ≈ 18 小时。

### Q3.23 掉电再上电，缓存条数和时间戳的连续性靠什么保证？
**面试官想听：** Flash 环形日志的"找断点"逻辑。
**答：** `W25QXX_LogInit()` 会扫槽位，用 `W25QXX_LOG_EMPTY = 0xFFFFFFFF` 判空槽，找到写入断点并恢复计数（`w25qxx_log.h:53`）。所以计数不会清零，接着往后写。

时间戳靠 `now_ts()`，但它是开机秒数，不是 RTC。断电重启后 ts 从 0 重新走，补传出去的旧记录 ts 比新记录还新的情况确实存在。
**加分/追问：** 这正是进度文档阶段 6 判据里"断电 10 秒再上电，ts 继续往前走（不是从 0）"没有打勾的原因，要真做就得接 RTC。

### Q3.24 队列满、写盘失败、补传过程中清缓存——这三种失败分别怎么处理？
**面试官想听：** 能不能说出每条失败路径的后果。
**答：** 队列满的时候，`xQueueSend` 等 20 ms，失败就 `s_rx_bad++`（`main.c:229-231`），帧被丢掉、不落盘。所以深度 8 是留给网络任务偶发卡顿的余量。

`W25QXX_LogWrite != OK` 就只加 `s_pub_fail`（`main.c:399-402`），这条数据就丢了，没有重试，也没有降级。

补传过程中清缓存，是先 `s_replay = 0` 停补传，再擦（`main.c:313-319`）。擦除期间 `LogWrite` 返回 `ERR_BUSY`，新帧不进缓存，但转发照常。
**加分/追问：** 真正的缺口是第②条——`s_pub_fail` 把"上云失败"和"写盘失败"混成一个计数，现场根本分不清是网的问题还是 Flash 的问题。

### Q3.25 看门狗现在开了吗？`SYS_IND` 的 2 秒心跳和 IWDG 是一回事吗？
**面试官想听：** 能不能区分"软件状态指示"与"硬件复位保护"。
**答：** 没开。`main.c` 里没有 `SYS_WDG_Init()/SYS_WDG_Feed()`，虽然 `FWLIB` 里有 `sys_wdg.c`，设计 §7 也写着 4 秒超时启用。

`SYS_IND` 的 2 秒心跳超时只是让两颗灯进 FAULT 快闪（`sys_ind.h:31`），不会复位芯片。任务真死了，板子就静静躺着。
**加分/追问：** 正确姿势是监控任务里"所有任务都报到了 → 才喂狗"，即设计 §4.4 的心跳位图 `HB_ALL`；只喂不看，等于把看门狗变成定时器。

---

### 3.7 现场排查

### Q3.26 串口里 `rx` 在涨、`bad` 也在涨，先查什么？
**面试官想听：** 会用错误码定位，而不是瞎试。
**答：** 先看 `SYS_FRAME_Get` 的返回（`sys_frame.h:51-56`）。`ERR_HEAD` 说明根本没同步上，查波特率、接线、干扰；`ERR_LEN` 典型是粘帧，两帧挨太近被当成一帧，该调 `SYS_LORA_FRAME_GAP_MS`，而不是加大应用缓冲；`ERR_CRC` 是内容错，看距离、天线、空速。`bad` 里还混着命令字不是 `0x01` 的情况（`main.c:235-237`），所以先把具体错误打出来，再谈修。
**加分/追问：** `Poll()` 返回的是"当前可取出的完整帧数"（`sys_frame.h:181`），循环 `while(n--)` 才取干净；只取一次会积压。

### Q3.27 MQTT 连不上，串口打 `rc` 和 `connack`，怎么读？
**面试官想听：** 知道每个返回码指向哪个环节。
**答：** `net_connect()` 是逐段打印的（`main.c:137-160`）。`ESP8266_Init` 失败，是模块没应答，查供电、波特率、TX-RX 有没有反接；`SetMode/JoinAP` 失败，是 WiFi 密码或信号的问题；走到 `MQTT_Connect` 才失败，就看 `connack`，`MQTT_ERR_CONNACK = 4`（`mqtt.h:52`）一般是用户名密码错或者 client id 被拒，`MQTT_ErrStr()` 能翻成人话。

还要分清 `MQTT_IsConnected()` 只代表我方认为连上了，链路真活没活得看 `MQTT_IsAlive()`（`mqtt.h:15-17`）。
**加分/追问：** `vTaskNet` 里断链先打印再 5 秒重连（`main.c:376-389`），所以拔网线的现象是"[NET] 链路断开，准备重连"周期性重复，而不是一次就结束。

### Q3.28 LCD 上的数字不更新了，但串口 `[MON]` 还在打，可能是哪些原因？
**面试官想听：** 能不能按"数据源→任务→外设"的顺序排查。
**答：** 先看数据源和消费者。`vTaskUi` 用 `xQueuePeek` 只旁路看队头（`main.c:483`），网络任务不消费，队头就一直停在旧帧。现象就是数字卡住，但 `rx` 还在涨，这恰恰说明数据在路上、只是没被消费。

再看调度。UI 优先级 2，补传也是 2，补传跑起来时 UI 可能被长期挤到后面。

最后看外设。LCD 走 FSMC 逐字写，整屏重绘一次几十毫秒，500 ms 周期如果被别的事拖长，看起来就像卡了。
**加分/追问：** 区分方法——`bad`/`rx` 是否都在涨决定是"链路断了"还是"显示没刷"。

---

### 3.8 设计取舍

### Q3.29 为什么给 Qt 转发要"原样 20 字节"，而不是转成可读文本？
<!--code: main.c:281-300 -->
**面试官想听：** 链路两端谁该承担解析。
**答：** 设计 §5.2 定的是二进制透传。文本行一旦被数据里的换行、`#`、逗号污染，解析就会错乱；透传能让 Qt 和板1 用同一套帧格式、同一个 CRC 校验，板2 只是个搬运工，出错时责任边界也清楚，帧坏了是链路的问题，不是板2 转述的问题。
**加分/追问：** 代价是 Qt 侧必须有完整的帧解析器（`frameparser.cpp`），且调试时不能用串口助手肉眼看——所以才有"日志走 USART1"的需求。

### Q3.30 缓存为什么 32 字节一槽，而不是 20 字节紧排？
**面试官想听：** 存储结构与擦除粒度的匹配。
**答：** 4 KB 扇区除以 32 B，正好 128 条，整数、也不会跨扇区。结构是 `12 字节头（序号 + ts + CRC）+ 20 字节载荷`，载荷刚好装下整帧 20 字节（`w25qxx_log.h:44-50`）。要是紧排 20 字节，一条记录会跨页、跨扇区，写的时候得读-改-写，复杂还容易错。
**加分/追问：** 代价是 12/32 ≈ 37% 空间浪费，换来的是"写一条 = 写一页、擦一个扇区 = 清 128 条"的简单性。

### Q3.31 LoRa 为什么单独占 USART6，而不是复用 USART2/USART3？
**面试官想听：** 知道约束从哪来（本板串口不够）。
**答：** 网关要用 4 路：调试、Qt、ESP8266、LoRa。`sys_usart` 原来只封装了 3 路（`sys_usart.h:132-138` 现在是 6 路），所以先把库扩了，这是设计 §3.1-3.2 方案 A 的前提。

分工是 `USART1` 调试、`USART2` 给 Qt、`USART3` 给 ESP8266（`esp8266.h:29`）、`USART6` 给 LoRa（`lora_e22.h:102`，9600）。USART6 挂在 APB2，还得从 P1 排针飞 PC6/PC7，这是它的代价。
**加分/追问：** main.c:617 的注释还写着 `LoRa E22 (UART3)`，与实际 `SYS_USART_6` 不符——是改方案后没同步的注释，面试时主动指出来是加分项。

---

### 3.9 三个必须能张口就来的数字

| 项 | 值 | 出处 |
|---|---|---|
| 环境帧长 / 载荷 / 开销 | 20 B / 12 B / 8 B | `sys_frame.h:44/80` |
| 缓存容量 | 32640 条 × 32 B ≈ 1 MB | `w25qxx_log.h:41` |
| 堆 / 六任务栈合计 | 30 KB / 14 KB | `FreeRTOSConfig.h:34`、`main.c:649-654` |

---

### Q3.32 屏幕全黑、读 ID 得到乱码 —— 引脚复用冲突怎么查？

**面试官想听：** 会不会用"读器件 ID"这种最低成本的手段把问题切到硬件层。

**答：** 现象是板2 上电后 LCD 全黑，串口却一路正常。我在驱动里加了个 `LCD_ReadID()`：发 `0xD3` 命令再连读 3 字节，正常 ILI9481 应该回 `0x009481xx` 这类 ID，实测读回 `0x00032404`。ID 都不对，说明不是初始化序列的问题，是数据线传输出错了。

关键线索来自我自己写的引脚仲裁打印：

```
[GPIO_Claim] CONFLICT E7 : FWLIB\src\lcd.c:118  vs  FWLIB\src\lora_e22.c:179
```

`PE7` 被两个驱动同时申请了：LCD 侧是 FSMC 的 D4 数据线，LoRa 侧是 `SYS_LORA_AUX_PORT`，AUX 忙闲指示脚。`LORA_E22_Init()` 把 PE7 配成输入上拉，等于把 LCD 的第 5 根数据线抢走了，命令和数据整体错位一位，读 ID 就乱码、屏全黑。

修法是把 `SYS_LORA_AUX_PORT/PIN` 两个宏注释掉，板2 的 LoRa AUX 本来就没接、悬空，`lora_wait_idle()` 会自动走固定延时分支。重编后冲突消失、ID 正常、屏幕出画面。

追问过为什么不让两个驱动共用这个脚：不行。FSMC 的数据线在硬件上就是高速并口，AUX 是电平信号，同一个脚不可能同时满足两种电气角色。这类冲突只能靠引脚分配表在编译期或者上电早期做仲裁，不能靠运行时谁先初始化谁赢。

还有个真实经历。一开始看到屏黑，我怀疑初始化序列，电源、伽马、0x11 延时都试了，最小初始化表也还是黑。真正定位靠的是那行冲突打印加读 ID。教训是屏不亮先读 ID，ID 不对就是数据或命令通道坏了，跟初始化参数没关系。

### Q3.33 你的告警阈值是怎么定的？为什么不直接用国标？
<!--code: Project_1_检测端/Project/main.c:54-62 -->

**面试官想听：** 知道阈值要标定、跟部署环境相关，而不是拍脑袋或抄标准。

**答：** 我气压上限一开始设的是 1020 hPa，按标准大气压 1013 来的。但设备装在重庆，海拔约 250 m，当地常年只有 978~985 hPa，这条告警永远不会触发。

我先用公式算了一遍：`P = 1013 × (1 - 2.25577e-5 × h)^5.25588`，h = 250 m 时约 983 hPa，跟实测对得上。然后按本地基线重定：气压 970~995，也就是本地 983±12；湿度上限从 80% 放到 88%，因为重庆秋冬常年 70~85%，用 80% 会天天误报；温度 12~28℃，对应 10 月的日均 18~19℃ 和夜间 14~16℃。

另外加了回差，温度 1℃、湿度 5%、气压 1 hPa。不然在临界点上会红白红白地闪。

后来他追问，设备要拿到别的城市用怎么办。

**答：** 两种做法。简单的是把阈值做成参数，串口或云端可下发，我现在有 0x20 设采样周期，加一条 0x21 设阈值就行；进一步是按 GPS 或手工配的海拔自动算气压基线，把绝对阈值换成相对当地基线的偏离，比如 1 小时内气压变化 > 3 hPa 就提示天气突变，这比固定阈值更有意义。

他又问三端，采集端、网关、上位机的阈值怎么保证一致。

**答：** 这是个真问题。我改板1 的宏时，板2 的 LCD 和 Qt 的告警表还各自留着一份旧值，于是出现板1 认为正常、Qt 却弹告警的矛盾。

现在三处都按同一张表改：板1 的 `T_LIMIT_X100/H_LIMIT_X100/P_LIMIT_X10/L_LIMIT_LX`、板2 的 `UI_T_HI/UI_H_HI/UI_P_HI/UI_L_HI`、Qt 的 `AlarmManager::defaultThreshold`。

彻底的做法是把阈值做成单一来源，比如板2 存一份、通过 0x21 下发给板1、Qt 开串口时查询回读，避免三处手改。

还有个真实经历。我一开始就是照抄 1013，结果面板上气压一直是 980 左右，从来不报警，还以为传感器坏了。后来查了本地海拔才反应过来，传感器没错，是我的假设错了。

### Q3.34 环形日志是什么？怎么设计的？用在哪？

**面试官想听：** 能不能把"存不断电的数据"讲成有结构的设计，而不是"用 Flash 存了一下"。

**答：** 板2 断网时要把数据存下来，恢复后补传。我用的是外挂 SPI Flash（W25Q128，板上实际焊的是 GD25Q128）上的**环形日志**——顺序往后写，写满整片回绕覆盖最旧的，本质是一个只追加、不删改的日志式存储。

四个关键设计：

1. **一条记录 32 字节**：`seq(4) + ts(4) + len(2) + CRC16(2) + data(20)`。20 字节正好装下一整帧原始数据，补传时不用重新组帧；32 能整除 4KB 扇区（128 条）和 256B 页（8 条），永远不会跨页跨扇区。

2. **断电安全靠"最后写序号"**：先写数据和 CRC，最后才写 `seq`。上电扫描时 `seq == 0xFFFFFFFF` 就当空槽跳过，写到一半掉电的那条读不出来，也不会被当成有效数据。

3. **擦除单位是扇区**：4KB 只能整片擦，所以按扇区顺序写，满 128 条才擦一次，平均 128 次写换一次擦，顺带做了磨损均衡。`lost` 计数记录回绕时整扇区丢掉的条数——丢了多少要让外面看得见。

4. **并发用互斥量，不用 `vTaskSuspendAll`**：擦一个扇区 typ 45ms、最坏 400ms，关调度器会把 20ms 轮询的 LoRa 收帧和 50ms 一条的补传一起拖住；用互斥量只挡住同样用日志模块的任务，心跳、显示照跑。清缓存拆成 `LogClearStep()` 分步擦，擦的期间 `LogWrite` 返回 `ERR_BUSY`。

**容量**：`LOG` 区从 `0x001000` 到字库起点 `0x100000`，共 255 个扇区约 1020KB，× 128 条 = **32640 条，2 秒一帧约 18 小时**。

**用在哪**：①断网缓存；②联网后自动补传（50ms 一条）；③上位机历史查询 `0x15`（每次回一条 24 字节）；④清空缓存 `0x13`；⑤`LogStat` 给 LCD 和串口显示缓存水位。

**追问：为什么不用 FatFs？** 不需要文件名和目录，也不需要随机改写；日志式只要"顺序写 + 找空槽"，代码 500 多行（`w25qxx_log.c` 558 行），掉电还更安全。FatFs 光代码就 20KB 起，还要先格式化。

**追问：写满了会怎样？** 覆盖最旧的整扇区，`W25QXX_LogLost()` 累加；历史帧只带 ts + 20 字节原始帧、不带 seq，所以上位机要看丢失条数得查 `0x12` 应答里的 `QA_LOST`。

## 4. Qt 上位机（SerialMonitor）

> 本节按统一格式整理：考点 → 回答 → 追问 → 真实踩坑。
> 类名/函数名/行为均可在仓库对应到具体文件。
> 当前状态：`--selftest` 通过 12/18，未通过的 6 条全部落在 `statcalc.cpp` 的三个空函数上（有意留的练习点）。

---

### 4.1 Qt 工程结构与构建

### Q4.1. 你这个 Qt 工程是怎么组织和构建的？
**面试官想听：** qmake/`.pro` 的依赖关系与实际构建链路，而不是"用 Qt Creator 点一下"。

**答：** 单工程，就一个 `SerialMonitor.pro`。`QT += widgets serialport printsupport`，`CONFIG += c++17`，`SOURCES` 十个 cpp，里面有 vendored 的 `qcustomplot.cpp`，`HEADERS` 十个，`FORMS` 一个 `mainwindow.ui`。`printsupport` 不是为了打印，是 QCustomPlot 依赖它。

我没上 CMake，也没拆子项目。六个自研模块加一个第三方绘图库，`qmake` 够了，拆库反而多一层同步成本。

构建有两条路：Qt Creator 直接打开 `.pro`；命令行 `qmake` 加 `mingw32-make -j8`，前提是 `PATH` 里先有 `E:\QT\6.11.2\mingw_64\bin` 和 `E:\QT\Tools\mingw1310_64\bin`。

追问过为什么用 C++17：用了 `std::upper_bound`、`inline constexpr`、`constexpr` 常量集，Qt 6 自己也要求 C++17。还问过为什么把 `qcustomplot.cpp` 编进工程而不是链接预编译库：版本固定、不依赖外部安装，代价是编译变慢。

踩过的坑是命令行敲 qmake 直接 `command not found`。我去 `build/` 里看生成的 `Makefile.Debug`，里面写着绝对路径 `E:\QT\6.11.2\mingw_64\bin\qmake.exe`，按它补 `PATH` 就好了。

### Q4.2. 源码怎么分层？各模块职责是什么？
**面试官想听：** 职责边界与依赖方向，能不能说清"谁不依赖谁"。

**答：** 六个文件各管一段：`frameparser` 把字节流变成帧，管 CRC、粘包、重同步；`datamodel` 管环形缓冲、统计和 CSV 录制；`alarmmanager` 做阈值和回差判定；`devctl` 负责下发命令的排队、超时重发和应答匹配；`statcalc` 是窗口统计的纯函数；`mainwindow` 管界面和三个定时器，是唯一碰 widget 的地方。依赖是单向的：window 指向 parser、model、alarm、devctl，反过来没有。

追问过为什么 `FrameParser`/`DataModel` 不继承 `QObject`：自检程序能直接链接它们、不需要 moc，也避免高频解析被信号槽丢进事件循环。这样拆的收益是 `--selftest` 能不开窗口跑解析和统计，`--cmdselftest` 能不开窗口跑下发通道。

这个拆法不是一开始就有的。早期我把解析状态直接放在主窗口类里，`--selftest` 想复用就得把整个窗口类拖进来。拆出独立的 `FrameParser` 之后才做到不开窗也能测，也是后来能上 `--cmdselftest` 的前提。

### Q4.3. 界面用 `.ui`，为什么还有大量控件是代码里建的？
**面试官想听：** 静态布局与动态生成的取舍。

**答：** `mainwindow.ui` 只放固定的三栏骨架，串口区、曲线区、右侧统计。卡片、6 个图例勾选、阈值回显表、设备控制面板，都是运行时由 `buildCards()`、`buildCurveChecks()`、`buildThresholdPanel()`、`buildControlPanel()` 生成。条目数由 `Series::Count` 决定，写死在 `.ui` 里改一处要改十处。动态控件全部用成员数组持有，`m_graph[i]`、`m_cardValue[i]` 这样，不用 `findChild("名字")` 那种字符串查找。

追问过动态控件怎么连信号：用 `connect(btn, &QPushButton::clicked, this, [this, i]{ ... })`，捕获下标，省得在槽函数里再解析 sender。三栏宽度用 `QSplitter` 分，比例在 `showEvent()` 里设。

有个坑。`QSplitter::setSizes()` 在构造函数里调的时候，splitter 还没布局过，传进去的比例会先被按默认宽度缩放，真正显示后右栏可能被挤成 0 宽，看起来界面少一块。挪到 `showEvent()` 里、第一次真正显示后再分配就好了。

### Q4.4. 用了 QCustomPlot，许可证和发布怎么处理？
**面试官想听：** 对第三方许可证有意识，如实说明项目性质。

**答：** QCustomPlot 2.x 是 GPLv3，或者买商业授权。这个仓库里是 vendored 源码，`qcustomplot.cpp` 大概 3.5 万行。本项目是学习、毕设性质，不对外分发闭源产品，按 GPLv3 用没问题。这点得说实话，不能宣称可以随便闭源商用。真要做闭源商业发布，只有三条路：买 QCustomPlot 商业授权、换 Qt Charts（Qt 6 里同为 GPL/商业双许可）、或者自绘。发布时用 `windeployqt` 收集 `Qt6Core/Gui/Widgets/SerialPort/PrintSupport` 和 platforms 插件。

追问过 GPLv3 对静态链接的影响：静态链接同样触发传染性，闭源分发必须拿商业授权。也问过为什么不用 Qt Charts：项目里 QCustomPlot 的交互，点条、图例、轴矩形，都已经调好了，换库等于重写绘图层。

坑是 `qcustomplot.cpp` 自身带一批 `QImage::mirrored is deprecated` 警告。第三方代码我不改，改了不利于以后升级，只保证自研文件 0 warning；看构建日志时先把这类警告过滤掉，否则会淹掉自己的警告。

### 4.2 串口收发与线程模型

### Q4.5. 串口是怎么打开的？参数有什么讲究？
<!--code: mainwindow.cpp:1557-1590 -->
**面试官想听：** `QSerialPort` 的实际用法，尤其是打开模式。

**答：** 一个 `QSerialPort` 实例，端口列表用 `QSerialPortInfo::availablePorts()` 刷新，选中后依次 `setPortName`、`setBaudRate(115200)`、`setDataBits(Data8)`、`setParity(NoParity)`、`setStopBits(OneStop)`、`setFlowControl(NoFlowControl)`，最后 `open(QIODevice::ReadWrite)`。

必须是 `ReadWrite`。只写 `ReadOnly` 时界面一切正常，但 `write()` 静默返回 -1，表现就是上位机发不出命令，还没有任何报错。

追问过为什么用 CH340 要提示驱动：设备管理器里没有 `USB-SERIAL CH340` 就是驱动没装，端口列表会是空的。波特率写错的话，收到的是乱码，`FrameParser` 会一直累加 `errCrc`，日志里能看到 CRC 错计数在涨。

以前就踩过这个。用 `ReadOnly` 打开，查询按钮点了没反应、日志也没有错误，排查半天以为板2 没实现命令。最后是 `DevCtl` 里加了 `isWritable()` 判断并 emit 一条日志，才暴露出来。

### Q4.6. 数据到了之后，界面是怎么刷新的？
<!--code: mainwindow.cpp:1745-1760 -->
**面试官想听：** 是不是"来一帧刷一次"，有没有做批量。

**答：** 分三层。`readyRead` 只做 `readAll()`，喂给 `m_parser.feed(chunk)`，取出帧分发给 `handleFrame()`，完全不碰界面；50 ms 的 `m_plotTimer` 统一刷卡片、曲线、统计；1000 ms 的 `m_statsTimer` 刷统计表、告警表、补传进度和静默检测。刷新节奏跟数据到达解耦，串口突发时界面也不会卡。

追问过为什么统计也放 50 ms 定时器里：它只扫最近 50 个点，比重绘便宜；放 1 s 定时器会让窗口点数比曲线滞后一格，看起来像少一个点。定时器会不会堆积：`QTimer` 默认单次触发，槽里不阻塞，50 ms 周期远大于一次重绘耗时。

坑是早期来一帧调一次 `replot()`，用 `--feed 500` 灌数据时界面直接卡住几秒。改成 50 ms 批量加 `QCustomPlot::rpQueuedReplot` 之后才顺。

### Q4.7. 为什么没有用 QThread 做串口收数据？
**面试官想听：** 线程模型的判断依据，而不是"Qt 就该多线程"。

**答：** 数据率就 1 Hz、每帧 20 字节，解析一次是微秒级；`QSerialPort` 的 `readyRead` 本来就在事件循环里异步触发，不需要再开线程。全放 GUI 线程，代价只是每次解析占几十微秒，收益是零锁、零跨线程信号、调试栈也简单。真要考虑换线程模型，得等采样率上到几十 Hz 以上，或者要做大文件导出、长时间 CSV 写盘，那时候把 `DataModel` 或 CSV 写入挪到 worker 线程。

追问过将来上 100 Hz 怎么办：解析可以留主线程，还是轻，把曲线抽稀和落盘挪到线程，用无锁环形队列传。也问过为什么不用阻塞式串口读：`waitForReadyRead` 会把界面冻住，1 Hz 下感觉不出来，一断线就卡死。

坑是在 `onSerialReadyRead` 里直接调了写盘的 flush，拔线瞬间写入阻塞，界面假死。后来 CSV 只在 `append` 里写一行并 flush，停止条件走 `closeEvent` 统一收尾。

### Q4.8. 串口异常断开怎么处理？
**面试官想听：** 错误分类处理与界面状态回收。

**答：** 连 `QSerialPort::errorOccurred`，只对 `ResourceError` 和 `DeviceNotFoundError` 做关端口、放开界面：`close()`、`m_dev->detach()`、按钮文字改回打开串口、下拉框重新可用、状态栏提示可点刷新后重连。其它错误，比如 `NoError` 或者暂时性错误，只记日志，不动界面状态，否则一次偶发错误就把串口关了。

追问过拔线后再插上能不能自动恢复：不能，得用户点刷新再打开串口；自动重连要按 VID/PID 匹配，属于未实现项。断开时队列里在途的命令怎么办：`detach()` 会清空 `m_queue`，避免重连后把旧命令发出去。

不处理 `ResourceError` 的后果我见过。拔线后端口句柄已经失效，界面还显示已打开，再点任何按钮都是往一个死句柄写数据，Qt 只在内部记错误，界面毫无反馈。

### 4.3 帧解析

### Q4.9. 说一下这个 20 字节帧的格式，以及怎么判断一帧是有效的。
**面试官想听：** 协议细节 + 三重校验的顺序。

**答：** 帧是 `AA 55 | CMD | LEN | DATA(12B) | CRC16(低字节在前) | 55 AA`，整帧 20 字节。数据段 6 个大端字段：温度×100、湿度×100、气压×10、光照、TVOC、MQ-135。

判定顺序是帧头、长度、CRC、帧尾：`step()` 先找 `0xAA 0x55`，读 `LEN` 判有没有超过 `MAX_PAYLOAD`，按 `CMD+LEN+DATA` 算 CRC 比对，最后看帧尾 `55 AA`。四步全过才按 CMD 分类入队（`frameparser.cpp:258` 起）。

追问过 CRC 范围为什么不含帧头帧尾：跟固件 `SYS_FRAME_Verify` 保持一致，范围是 `[2..2+LEN)`，两端字节本来就不变，算进去只是浪费。为什么先判长度再算 CRC：长度非法时不必做无用计算，也避免按错误长度越界读。

坑是帧尾 `55 AA` 和下一帧帧头 `AA 55` 在接缝处会拼成 `55 AA AA 55`。如果只认 `AA 55` 而把整帧长度丢掉，接缝处会连续丢两帧。这个坑在 `--selftest` 第 5 条三帧粘包用例里固定住了。

### Q4.10. 粘包你怎么处理？校验失败为什么只丢 1 个字节？
**面试官想听：** 重同步策略，是否理解"丢整帧"的后果。

**答：** 校验失败时 `dropFront(1, true)`，只丢 1 个字节，然后重新找帧头（`frameparser.cpp:297`）。理由是数据段里什么字节都可能出现，包括 `AA 55`，一旦错位，丢整帧长度会连着吞掉后面的好帧；丢 1 字节重找虽然慢，但保证不会误吃。粘包本身不用特殊处理，`step()` 是个循环，缓冲区里能凑出几帧就消费几帧。

追问过会不会陷入每次都从同一位置失败的死循环：不会，每次失败至少丢 1 字节，缓冲区单调变短，必然收敛。重同步字节数在 `dropFront` 里累加 `resyncBytes`，自检用例会断言逐字节分包时它必须为 0。

坑是最初写成校验失败丢整个 `OVERHEAD+LEN`，接缝 `55 AA AA 55` 的场景下，解析出的帧数从 3 变成 2，`--selftest` 第 5 条直接把它抓出来了。

### Q4.11. 一帧分 20 次到达，你怎么保证能收全？
**面试官想听：** 缓冲区管理与半包判断。

**答：** `m_buf` 是累积缓冲区。`feed()` 追加字节后调 `step()`，`step()` 里每个分支都有不够就 return、等下一段的出口：不足 2 字节等帧头，不足 4 字节等 LEN，不足 `OVERHEAD+LEN` 等整帧。找不到帧头时只保留最后 1 字节，可能是 `AA`，其余按噪声丢掉并计 `resyncBytes`。整帧消费后 `dropFront(total, false)`，不算重同步。

追问过缓冲区会不会无限增长：不会，每次 `step()` 要么消费要么丢弃，半包最多留 `MAX_PAYLOAD+8` 字节。怎么验证：`--selftest` 第 6 条是逐字节分包、20 次 feed，第 7 条是半帧残段加噪声重同步。

早期 `feedByte` 里每次只处理一帧就返回，粘包时第二帧要等下一次 `readyRead` 才出来，表现为三帧粘包只解析出 2 帧。改成 `step()` 循环推进后就正常了。

### Q4.12. CRC16-MODBUS 的参数是什么？为什么要和固件手算一致？
**面试官想听：** 算法参数 + 跨端一致性的验证方法。

**答：** 初值 `0xFFFF`、多项式 `0xA001`、反射、无最终异或、结果低字节在前（`frameparser.cpp:9`）。三端必须是同一套：板1 的 `SYS_MODBUS_Crc16`、板2 的 `MODBUS_CRC16`、上位机的 `FrameProto::crc16Modbus`。

验证不是看着像，是拿固件打印的帧逐字节比对。板1 曾在日志里输出 `AA 55 01 0C ... 4B AE 55 AA`，我用 Python 独立复算也得到 `4B AE`，这才算把 CRC 钉死。

追问过为什么不用 Qt 自带的 `qChecksum`：那是 CRC-16/CCITT，参数不同，算出来对不上。位运算怎么写不容易错：按位异或后循环 8 次，每次判最低位决定是否异或多项式，别用查表版手抄表。

坑是刚开始把 CRC 范围算成 `[0..]`，含帧头，自检的组帧回环能过，因为自洽，但拿真板子数据一比对就全 `errCrc`。教训是自洽测试发现不了双方一起错，必须拿独立实现，比如 Python 一行脚本，交叉验证。

### Q4.13. 历史帧（0x15）和应答帧（0x8x）为什么要单独队列？
**面试官想听：** 数据与控制的隔离，以及"混在一起会怎样"。

**答：** `FrameParser` 里我放了三个队列：`m_ready` 放环境帧，`m_history` 放 0x15 历史帧，`m_ack` 放 CMD 带 0x80 的应答。

历史帧要是混进实时队列，`onSerialReadyRead` 里那个 `while (takeFrame())` 会把补传数据当实时帧处理，一路触发告警判定、刷新静默检测的收帧时刻、污染丢帧估算。应答帧是对下发命令的回话，属于控制面，交给 `DevCtl` 匹配在途命令。

追问过历史帧为什么不算进丢帧估算：补传是成批来的，间隔没有意义，算进去会把 `lossEstimated` 冲爆，`frameparser.cpp:338` 的注释写明了。0x15 里的时间戳是谁的时间：是板2 收到并缓存那帧时的原始时刻，`hh*10000+mm*100+ss`，不是到达上位机的时间。

混在一起的时候，补传 2000 条历史数据会让丢帧估算瞬间涨到几千，日志里全是链路告警，真正的问题反而被盖住。拆队列后这个指标才可用。

### 4.4 数据模型与环形缓冲

### Q4.14. 数据模型存什么？为什么是环形缓冲？
<!--code: datamodel.h:80-95 -->
**面试官想听：** 数据结构选择与容量计算。

**答：** `DataModel` 存三样：6 条 `QVector<QPointF>` 曲线、一个 `QVector<qint64>` 时间戳轴，还有每项一个 `Stat`，记点数、最大、最小、和。

容量默认 1800 点，1 s 一帧正好 30 分钟。超出时从最老的一端同时删掉时间戳、来源标记和 6 条曲线的首点，保证下标严格对齐。用定长加从头删，而不是无界增长，因为长时间挂机几天，内存会一直涨。

追问过为什么每条曲线都 append 一个点，即使值是无效的：保证 6 条曲线和时间戳逐项对齐，导出 CSV 时按同一个下标取 6 个值不会错位。1800 够不够：按 1 Hz 是 30 分钟，要更长就调大 `capacity`，或者用 `saveHistoryCsv` 分段落盘。

坑是最初只在量有效时才 append，结果湿度无效那几帧让 6 条曲线长度不一致，导出的 CSV 整行错位，湿度列跑到温度列去了。

### Q4.15. 曲线横轴为什么用"数据序号"而不是时间戳？
**面试官想听：** 坐标轴语义与补传数据的影响。

**答：** 横轴 x 是这帧在时间轴上的下标加 1，由 `renumber()` 在追加、插队、丢最老点之后统一重算（`datamodel.cpp:130`）。用序号的好处是第 N 个点跟界面上的点数、点条序号一一对应，用户点第 137 个点就是第 137 帧，不会因为时钟漂移对不上。

代价也很明确：补传数据插在中间时，序号整体后移，真实时间间隔被压平，同一段曲线上离线 30 秒和在线 30 秒看起来一样宽。

追问过丢帧怎么体现：看不出来，只能靠日志里的 `lossEstimated`，按到达间隔估算。为什么不在 x 上用时间戳：试过，补传的历史点会让曲线左侧出现回头甚至负值，QCustomPlot 会画成折返；当时选择先保证可点选与序号一致，时间语义放到工具提示里显示。

改成序号轴之后还踩过一个坑，`m_shownFrames` 的增量判断失效了。切换查看量时另一条曲线的点数可能是 0，算出 `add = 0`，曲线一直空着；后来改成用该曲线自身的点数判断重建，就在 `mainwindow.cpp` 的 `refreshPlot` 里那个 `rebuild` 条件。

### Q4.16. 补传数据怎么去重？时间戳只有时分秒，跨天怎么办？
**面试官想听：** 去重键设计 + 缺字段的工程处理。

**答：** 去重键是时间轴坐标加 20 字节原始帧内容：`wallMs` 相同、并且 `rawFrame` 逐字节相同，才判重复（`datamodel.cpp:260`）。只比时间戳不行，同一秒可能有两帧不同数据。

时间戳只有 `hh*10000+mm*100+ss`，没有年月日，`resolveStampMs()` 按本机当天解释；如果算出来的时刻比栈内最后一个时刻早 12 小时以上，就按次日算，跨零点那批补传也能排下去，栈内次序仍然单调。

追问过时间戳为 0 或非法怎么办：不入库，计 `m_histBad`，这是板2 没对时的兜底。去重表会不会无限长：跟时间轴同步裁剪，`trimKeyFront()` 丢掉早于首点的键。

坑是一开始只按时间戳去重，补传重发时同秒不同帧被误判成重复，丢掉了一帧；改成时间戳加原始帧内容双键后才对。

### Q4.17. 湿度读失败怎么显示？为什么不用 0 代替？
**面试官想听：** 无效值的表达方式与下游影响。

**答：** 固件约定湿度无效时送 `-1`，也就是 `humiX100 = -1`，`EnvFrame::humiValid()` 判 `>= 0`；`DataModel::value()` 对无效湿度返回 `NaN`，QCustomPlot 遇到 NaN 会自动断线。

我没有用 0 代替，因为 0 会画出湿度掉到 0% 的假象，告警还会误判成低于下限。CSV 里这一列直接写 `--`。

追问过 NaN 会不会影响统计：会，`StatCalc` 里 NaN 直接跳过，不计入窗口点数。其它量有没有无效值：目前只有湿度；气压、光照、TVOC、MQ-135 未接入时固件送 0，用物理合理范围另作处理，见 Q23。

没做 NaN 的时候，湿度断线那几帧被画成 0，曲线出现一根垂直下坠的假线，看起来像传感器坏了；用 NaN 断线后一眼能看出中间缺数据。

### 4.5 曲线绘制（QCustomPlot）

### Q4.18. 6 个物理量怎么画？为什么是一根 Y 轴？
**面试官想听：** 量纲差异的处理方式与取舍。

**答：** 现在是单 Y 轴，一次只显示一条曲线。6 条 `QCPGraph` 都建好，但只有当前查看量可见，Y 轴标签、刻度颜色、量程都跟着查看数据下拉框切换，由 `updateViewAxis()` 管。

设计文档里曾计划一个量一根轴、最多 6 根，实现时没采用。6 根轴挤在右侧，每根刻度都要占宽度，曲线区会被压得很窄；而且用户一次只看一个量，切换比同屏更清楚。代价是不能同屏对比两个量，这是已知取舍，不是遗漏。

追问过量纲差多大：温度 -40~80℃、气压 300~1100 hPa、光照 0~20000 lx、MQ-135 0~4095，共用一根轴会把小的压成直线，所以必须按量切换量程。自动量程怎么做：勾选后按当前曲线可见点的 min/max 自适应，下界固定 0，上界留 10% 余量；恒 0 时给一个可见轴高，避免轴被压成一条线。

坑是自动量程没排除 NaN/Inf，一次湿度无效就让 `hi` 变成 inf，Y 轴直接崩掉。加了 `std::isfinite` 过滤才稳。

### Q4.19. 曲线是每次整条重画还是增量追加？
**面试官想听：** 是否理解 `addData` 与 `setData` 的适用场景。

**答：** 两条路都实现了。正常情况下用 `addData`，只追加新点；一旦发现该曲线点数少于模型点数，或者模型点数反而变少，比如补传插队、环形缓冲丢最老点，就整条 `setData` 重建。判断用的是该曲线自身的点数，不是全局帧数；切到另一条曲线时它自己的点数是 0，必须走重建。

追问过为什么不永远重建：1800 点全量重建每次几十毫秒，1 Hz 下还行，但切量、缩放时会明显卡。`splitPoints()` 是干什么的：QCustomPlot 的 `setData` 没有 `QVector<QPointF>` 重载，得拆成 `keys`、`vals` 两条 `QVector<double>`，设计文档 11.4 记了这个编译错误。

早期用全局 `m_shownFrames` 判断增量，切换查看量后新曲线的 `dataCount()` 是 0，算出的 `add` 是 0，曲线一直空着。日志里收到帧数在涨，画面不动，最后定位到这里的基准用错了。

### Q4.20. 绘图性能做了哪些处理？
<!--code: mainwindow.cpp:753-775 -->
**面试官想听：** 具体的开关与量化理由，不是"优化过"。

**答：** 性能上我做了几处处理。`setNotAntialiasedElements(QCP::aeAll)` 关抗锯齿，点数多时明显省 CPU；`replot(QCustomPlot::rpQueuedReplot)`，把重绘排队合并，一次事件循环只画一帧；刷新走 50 ms 定时器批量做，不在 `readyRead` 里画。另外 6 条曲线只保留一条可见，隐藏的不参与绘制。

追问过为什么不开 OpenGL：1 Hz、1800 点完全不需要；而且远程桌面、麒麟这类环境没有稳定 OpenGL，开了反而崩。数据量再大怎么办：抽稀，LTTB 或者等间隔，或者降采样；当前环形缓冲上限就是 1800，暂时不需要。

一开始每次 `replot()` 都是默认立即重绘，`--feed 500` 灌数据时界面几秒无响应；改 `rpQueuedReplot` 加 50 ms 批量后恢复。

### Q4.21. 曲线下面那条"点条"是什么？怎么保证和主图对齐？
**面试官想听：** 自定义交互控件的实现细节。

**答：** 点条是第二个 `QCustomPlot`，叫 `m_xStrip`，只画一条水平轴和可点的样本圆点，跟主图共享 X 范围。

对齐的关键是 `syncXStripMargins()`。主图左侧有 Y 轴标签和刻度，点条没有，直接同范围会横向错开，所以要把点条轴矩形的左右边距设得跟主图轴矩形一致。点条上的绘制点还要抽稀：从最新样本往前遍历，按与已绘制点的像素间距 ≥ `kStripMinGapPx` 筛选，总数不超过 `kStripMaxDots`，不然 1800 个点会连成一条实线，根本点不中。

追问过命中判定用哪一组点：用未抽稀的 `stripHitNumbers()`，所以绘制点之间也能点中最近的样本。为什么不直接在主图上点：主图要支持拖动缩放，叠加可点标记会抢事件。

坑是一开始点条和主图各画各的，同一个序号在两处差十几个像素，看起来点歪了。用 `dumpStripAlign()` 把两处的像素坐标打出来对比，才定位到是左边距没同步。

### 4.6 报警与统计

### Q4.22. 告警为什么要回差？你的状态机怎么写的？
**面试官想听：** 迟滞（hysteresis）的实际作用与实现。

**答：** 单阈值会在临界点反复触发。温度在 35.0℃ 上下抖 0.1℃，就会每秒报警又恢复，告警表刷屏、蜂鸣器反复响。

我的做法是进阈值立即报警，恢复必须走出阈值减回差（`alarmmanager.cpp:124`）。上限 35.0℃、回差 1.0℃，那 35.01℃ 报警、降到 33.99℃ 才恢复；报警和恢复各产生一条记录，状态不变时不记录。

追问过回差设 0 会怎样：退化成单阈值，抖动照样刷屏；对话框里允许设，但默认给 1.0。下限侧呢：对称处理，低于下限进入，回升到下限加回差以上才恢复。

坑是一开始只判当前值是否超阈值，没记状态，同一秒内两帧数据一帧超一帧不超，就产生两条相反记录；改成保存 `m_state[i]` 后只在状态变化时记一条。

### Q4.23. "物理合理范围"和"告警阈值"有什么区别？为什么要分开？
**面试官想听：** 数据质量与业务判定的分层。

**答：** 合理范围管的是这个读数可不可信，`physrange.h` 里温度 -40~80℃、气压 300~1100 hPa 这些；阈值管的是业务上有没有越限，两码事。

板1 的气压、光照、TVOC、MQ-135 还没接入，固件里直接送 0，0.0 hPa 会命中低于下限 980，一插串口就刷两条假告警。我的做法是超出合理范围的值照常显示、照常记 CSV，标个 `+RANGE`，但跳过告警判定，也就是 `skipMask`，只在统计里计数、日志里进出各记一条。

追问过为什么不直接丢掉：丢掉就分不清传感器没接和真读数，也没法事后分析。跳过判定时已成立的告警怎么办：状态保持原样，不会因为读到 0 就被误报成恢复。

没做这层的时候，板1 气压恒 0，插上串口日志每小时刷几百条气压过低；加了 `skipMask` 后日志干净了，CSV 里仍留着 `+RANGE` 标记。

### Q4.24. 告警记录会无限增长吗？
**面试官想听：** 内存上限与淘汰策略。

**答：** 记录表上限 5000 条（`alarmmanager.h:74`），超了从最老的删。每行带时间、物理量、等级、当前值、触发阈值；恢复事件单独一条，`recovery = true`，文字由 `Record::text()` 生成。统计里另有一个进入告警次数，`enterCount()`，它只增不清，用来回答一共报过多少次，不受记录淘汰影响。

追问过为什么不做持久化：告警记录是运行期观测用的，长期留档靠 CSV，每帧都落盘，还带 CRC 状态列。去重逻辑在哪：在状态机里，同一状态不重复记，只有状态迁移才产生记录。

用 `--feed 6000` 压测时，表涨到 6000 行不回落。检查发现 `while (size > kMax)` 的裁剪写在了 `append` 之前而不是之后，补一行就多一条。

### Q4.25. 右侧统计区的"平均值"为什么是剔除过的？现在能算对吗？
**面试官想听：** 统计口径的取舍 + 当前实现状态（该项目里统计是留白的）。

**答：** 口径是最近 50 个点，`statcalc.h:34` 里的 `kWindow`。点数 ≥3 时，从平均值里各剔 1 个最大值和 1 个最小值；重复极值也只剔 1 个，最小值和最大值本身不剔除，NaN 直接跳过。这么做是因为传感器偶发一个尖峰会把均值带偏，而中位数又丢掉趋势。

当前状态得说实话：`statcalc.cpp` 的三个函数还是空桩，所以 `--selftest` 只过 12/18，没过的 6 条全在统计，包括 1 点/2 点不剔除、全相同、重复极值、超 50 取最近、NaN 跳过。

追问过窗口为什么是 50：界面需求就是最近 50 次数据的平均值，1 Hz 下约 50 秒。点不足 3 个为什么不剔：剔完只剩 1 个点，均值没有意义。

坑是一开始按最小值、最大值各剔一个，写成去掉所有等于极值的点，遇到 50 个点全是同一个值时把整组都剔光了，平均变成 NaN。自检第 13 条全部数值相同就是为这个场景写的。

### 4.7 命令行自检与可测性

### Q4.26. 你的自检是怎么设计的？为什么不开窗口就能跑？
<!--code: consistencytest.h:32-46 -->
**面试官想听：** 可测性设计，而不是"手动点一遍"。

**答：** 核心模块都不依赖 widget，`frameparser`、`datamodel`、`statcalc`、`devctl` 都是。`main.cpp` 在 `QApplication` 之后先解析命令行：`--selftest` 直接跑 18 个用例，1~11 是帧解析、12~18 是统计，结果写 `自检报告.txt`，用退出码表达成败，0 就是全过；`--rangecheck` 跑 5 条量程边界；`--cmdselftest` 跑下发命令的字节向量。GUI 子系统没有控制台，所以写报告加退出码是唯一可靠的机器接口。

追问过一条用例长什么样：喂入固定字节流，断言成帧数、字段值、错误计数，比如三帧粘包 60 字节，期望成帧 3 帧。失败时怎么定位：报告里每条打印期望 vs 实际，末尾一行是通过 N / 18。

坑是直接双击 exe 跑 `--selftest` 看不到任何输出，GUI 子系统没有 stdout，一度以为程序没跑。改成写文件加退出码后正常，用 `%ERRORLEVEL%` 判断。

### Q4.27. `--feed`、`--shot`、`--view` 这些开关是干什么的？
**面试官想听：** 无硬件时的可验证手段。

**答：** 都是给没板子的时候准备的可视化证据。`--feed N` 灌 N 帧演示数据，间隔 1 s，走跟真串口完全相同的 `handleFrame()` 路径；`--shot x.png` 让窗口自己 `grab()` 出 PNG，不受屏幕 DPI 缩放影响；`--view N` 切换查看量；`--selpoint N` 和 `--selsample N` 按倒数第 N 个点或者按序号选中，验证点选和竖线。合起来能做到没接板子也出整屏截图加选中态截图。

追问过为什么不直接屏幕截图：屏幕缩放不是 100% 时，外部抓屏只拿到左上角一块，看起来像界面被裁掉；`QWidget::grab()` 是本进程真实渲染。演示数据和真数据会不会走两条路：不会，`feedDemoFrames()` 内部就是调 `handleFrame()`。

坑是用 PowerShell `CopyFromScreen` 抓图时右栏消失了，排查半天以为是布局 bug，实际是 DPI 虚拟化。换 `--shot` 立刻正常。

### Q4.28. 这套自检怎么进 CI？现在能当门禁吗？
**面试官想听：** 对"当前状态"的诚实评估。

**答：** 现在是手动门禁：改完代码先跑 `--selftest`，退出码非 0 就不插串口。能进 CI 的条件是全部用例通过，目前 12/18，差的 6 条都在 `statcalc.cpp` 的空函数上，所以现在还当不了门禁，这一步是明确的待办，不是已完成。另外 `tests/parsertest/` 有一个不含界面的快速版工程，改完解析器只编它，几秒钟出结果。

追问过为什么统计用例和解析用例放同一个报告里：一条命令覆盖两端，报告末尾统一给通过 N/18，简单直接。会不会出现自检全过但实机不通：会，这时候问题一定不在解析代码，而在接线、波特率、板2 转发；日志里的静默检测和 `errCrc` 就是用来切分这两类问题的。

曾经把自检通过当成可以上板，结果板2 的上位机串口没初始化，一帧都没有；后来在 `onStatsTick` 里加了串口开着 3 s 没帧就提示查板2 转发、P6 跳线、波特率。

### 4.8 踩坑与调试方法

### Q4.29. 讲一个你印象最深的崩溃，怎么定位的？
**面试官想听：** 调试路径，而不是"改好了"。

**答：** 有一次双击就闪退，退出码 `0xC0000005`，连弹窗都没有。查下来是构造函数里 `setupSerialUi()` 末尾会扫串口并调 `logLine()`，而那时候 `m_hexLog` 还没创建，`buildHexLog()` 排在它后面。定位方法是 gdb 栈指向 `QPlainTextEdit::appendPlainText`。

修法两条：把 `buildHexLog()` 提到构造第一句，再给 `logLine()` 加空指针判断。

追问过为什么 Qt 不直接崩在空指针那行：成员函数调用空指针时行为未定义，栈恰好落在被调函数里，看起来像控件内部的问题。怎么避免同类问题：构造顺序写成先建控件、再连信号、最后填数据，并在所有可能早于控件创建的日志函数里判空。

还有一次更隐蔽。`emit` 被拿来当成员函数名，编译报 `comma operator has no effect`，因为 `emit` 是空宏，`obj.emit(...)` 展开后成了逗号表达式。改名 `emitText` 解决。

### Q4.30. 联调时"界面收不到数据"，你怎么一步步排除？
**面试官想听：** 分层排查的顺序，而不是乱试。

**答：** 按自检、串口、链路、板2 从下往上排。先跑 `--selftest`，解析器有问题会先暴露；然后看串口开没开、`errCrc` 涨不涨，涨就是波特率或接线问题，不涨又没帧就是对端没发；串口开着 3 s 没帧，日志会提示查板2 是不是在跑、P6 跳线是不是在 SP3232 侧、TX/RX 有没有交叉；最后才怀疑协议实现。这样每一步都能把范围砍掉一半。

追问过为什么强调 P6 跳线：板2 的 PA2/PA3 同时接到 RS485 和串口，跳线选错就到不了 CH340。CRC 错但能收到帧说明什么：波特率偏差、共地不良，或者两端 CRC 参数不一致，后者可以用自检向量排除。

有次日志里 `errCrc` 每秒涨一次、帧数一直是 0，先怀疑代码，最后是板2 的转发任务没开。自检全过这个事实反而快速排除了解析层，这就是把自检放第一步的价值。

### Q4.31. Qt 的信号槽底层是怎么实现的？连接方式有哪几种？
**面试官想听：** 知不知道 moc 和元对象，不是只会 connect。

**答：** 信号槽不是魔法，靠 moc 生成的元对象代码。`Q_OBJECT` 宏让 moc 给类生成 `metaObject()`、信号索引和 `qt_metacall`，`connect` 时把发送者的信号索引和接收者的槽/函数记到连接表里；`emit` 就是调 `QMetaObject::activate`，按连接表逐个回调。

连接方式有五种：`DirectConnection` 在发送者线程立刻调，`QueuedConnection` 把调用包成事件投到接收者线程的事件循环，`AutoConnection` 看两者线程亲和性自动选，`BlockingQueuedConnection` 跨线程阻塞等待（同一线程用会死锁），`UniqueConnection` 防重复连接。这个项目没开工作线程，定时器都在主线程，Auto 实际走 Direct；主线程里我直接用函数指针和 lambda 连（`mainwindow.cpp:565`）。

坑有两个：lambda 连接最好带 context 对象，不然接收者销毁后还会回调；Queued 连接传自定义类型要先 `qRegisterMetaType`。

**加分/追问：** 信号槽比回调慢一点，因为要查连接表、可能跨线程投事件；高频路径（比如每帧解析）我会直接调函数，不拿信号槽当数据通道。

### Q4.32. Qt 的对象树和内存管理是怎么回事？deleteLater 什么时候用？
**面试官想听：** 知不知道 parent 会替你 delete，以及什么时候不能直接 delete。

**答：** QObject 有父子关系：父对象销毁时会自动 delete 所有子对象，所以 Qt 里最省心的写法是 `new` 的时候把 parent 传进去，比如控件都挂在面板上（`mainwindow.cpp:507` 的 `new QCustomPlot(ui->centerPanel)`），窗口关了子树一起没。栈对象也可以，但别让栈对象的生命周期短于它被连接到的对象。

`deleteLater()` 是“等回到事件循环再删”。在槽函数、事件处理里直接 `delete this` 或删掉正在发信号的发送者，会让后面的代码访问已释放内存；deleteLater 把删除排到本轮事件处理完之后，安全。我一般在动态增删控件、临时对话框关闭时用它。

还要注意别重复删：有 parent 的对象不要再手动 delete；跨对象持有时用 `QPointer` 判空，或者用 `QSharedPointer`。

**加分/追问：** 判断有没有泄漏，我会看对象数（`findChildren` 计数）和长时间运行时内存曲线，光看任务管理器不准。

---

#### 4.9 如果面试官问"这个项目你最不满意的地方"
可以照实说三条：① `statcalc.cpp` 还没写完，自检 12/18；② 协议没有序号字段，丢帧只能按到达间隔估算，要精确必须三端同步改协议（`LEN 0x0C → 0x0E`）；③ 没有自动重连与安装包，`windeployqt` 只在文档里写了步骤，未实测。

---

### Q4.33 QThread 怎么用？moveToThread 和继承 QThread 有什么区别？

**面试官想听：** 知不知道 QThread 对象本身不是线程、线程亲和性是什么。

**答：** QThread 是线程的控制对象，真正跑代码的是它内部的 `run()`。两种用法：

1. 继承 QThread 重写 `run()`：`run()` 里是工作线程，但 QThread 对象本身还在创建它的线程，它的槽也会在原线程执行，容易踩“以为在工作线程”的坑。
2. worker + `moveToThread`：把干活的 QObject 移到 QThread 上，连它的槽，跨线程信号自动走队列连接，槽就在工作线程执行；推荐这种，能继续用事件循环和定时器。

线程亲和性：QObject 属于创建它的线程，跨线程直接调用不安全；`connect` 默认 `AutoConnection`，跨线程自动变 `QueuedConnection`，参数要能拷贝，自定义类型先 `qRegisterMetaType`。共享数据用 `QMutex` / `QReadWriteLock` 或原子变量；别在同一个线程里用 `BlockingQueuedConnection` 等自己，会死锁。

这个项目没用 QThread：串口是 `readyRead` 驱动、单帧就 20 字节，主线程解析加环形缓冲足够；真要做重计算（比如谱线拟合）再把 worker moveToThread。

**加分/追问：** 线程退出用 `quit()` + `wait()`，`finished` 连 `deleteLater`；别在 `run()` 里 new 一个没有事件循环的 QObject。

---

## 5. 通用技术问题（三端通用，面试必问）

### Q5.1 你在项目里怎么管理内存？有没有内存泄漏风险？
**答：** 嵌入式我分三块看。静态区是全局变量和 `static` 缓冲，编译期就定好，最安全；栈是启动文件里 `Stack_Size` 给主栈，FreeRTOS 任务栈从堆里分；堆就是 `heap_4.c`，30KB。

风险点在运行中动态申请。我的做法是启动阶段一次性把任务和队列建完，运行期不再 malloc/free，这样即使 `heap_4` 有碎片问题也碰不到。如果非要在运行期申请，就得保证申请和释放成对，并且用 `xPortGetFreeHeapSize()` 盯剩余量。

### Q5.2 volatile 什么时候必须加？
**答：** 中断和主循环共享的变量必须加，比如 `s_ms` 这种计数器。硬件寄存器也一样，`GPIO_TypeDef *` 指向的地址必须 `volatile`，不然编译器会把读一次优化成缓存值；多任务共享但没加锁的标志位，不过加 `volatile` 也只是防编译器优化，不防竞态。

竞态还得靠临界区或者原子操作。volatile 不保证原子性，`i++` 该加锁还得加锁。

### Q5.3 中断服务函数里为什么不能调用 printf？
**答：** `printf` 内部有锁和缓冲，重入会乱；它还很慢，格式化加串口阻塞发送要几毫秒，中断里待久了会影响其他中断和任务调度；要是里面用了 `HAL_Delay` 之类，还可能触发阻塞 API。

正确做法是中断里只置标志或者写环形缓冲，处理放到任务里做。

### Q5.4 临界区、关中断、调度器挂起，三者区别？
**答：**
`taskENTER_CRITICAL()` 是关中断，关到 `configMAX_SYSCALL_INTERRUPT_PRIORITY` 为止，用来保护临界区，范围最短；`vTaskSuspendAll()` 只挂起调度器，不关中断，适合不能被切换打断但允许中断的场景；直接 `__disable_irq()` 是全关，最简单也最粗暴，会影响实时性。

我项目里用临界区保护队列操作和计数器读写，范围都控制在几条指令内。

### Q5.5 大端小端？你的协议为什么用大端？
**答：** STM32 是小端，低字节在低地址；网络协议传统上用大端。我组帧时手动移位：

```c
out[i]   = (uint8_t)(v >> 8);
out[i+1] = (uint8_t)(v & 0xFF);
```

这样不依赖编译器或芯片的字节序，Qt 端是 x86 小端，Python 端解析也一致。图省事直接 `memcpy` 结构体的话，换个平台就废了，这是嵌入式协议最容易埋的坑之一。

### Q5.6 你用过哪些调试手段？按有效性排个序
**答：**
按有效性排，我一般这么排。

看寄存器现场，J-Link halt 加 `regs` 加 `CFSR`，能直接定位崩溃点；map 文件加反汇编，定位符号归属、看谁被链接器删了；串口日志，最便宜，但得设计好，分级、限流；GPIO 翻转加示波器或逻辑分析仪，看时序最准；CYCCNT 计时，测函数耗时，比 `SysTick` 精度高。

最没用的是改一行编译一次试试，那是没有假设的试错。

### Q5.7 为什么用 FreeRTOS，不用裸机状态机？
**答：** 这个项目里其实两种都考虑过。功能少、时序简单的时候，裸机状态机更省资源也更好调试；但这里要同时处理 2 秒采集、1 秒发送、随时收下行命令、100ms 心跳，裸机会写成一堆 `if (flag)` 和计时器，可读性太差。

FreeRTOS 的好处是能用优先级表达紧急程度，用队列解耦生产消费；代价是 RAM，30KB 堆，还有调试复杂度，栈溢出、优先级反转这些。

面试里我会补一句：如果这个项目只要采集加发送，我会选裸机；选 RTOS 是因为有并发和优先级需求。这样显得是权衡，不是随大流。

### Q5.8 你项目里做过哪些"防御性编程"？
**答：**
我做了这么几处。所有对外接口都返回错误码，不用 0/1 混着表示成功失败，比如 `SYS_SHT30_OK=0`、`ERR_PARAM=1` 这样；指针参数进函数先判空，长度参数判上限；协议解析三步校验，帧头、长度、CRC，任何一步不过就丢弃并计数；环形缓冲区分满和空，不靠 head==tail 判断；最后是看门狗、栈水位、HardFault 现场，三层兜底。

### Q5.9 如果让你重做这个项目，你会改什么？
**答：** 真让我重做，会改这几处。一开始就把协议写成一份 IDL 或者头文件生成器，而不是三端各抄一份常量；现在 `sys_frame.h` 和 Qt 的 `frameparser.h` 是手工同步，最容易漂移。

传感器驱动统一接口，`Init/Read/SelfTest` 三件套加统一错误码。现在每个驱动的返回码语义不完全一致。

上 CI，至少做到每次提交自动编译、跑 Python 协议校验、跑 Qt `--selftest`。现在是手工点 Keil。

### Q5.10 这个项目有什么不足？你打算怎么补？
**面试官想听：** 诚实 + 有具体计划，不是"没有不足"。

**答：** 说真的，不足挺明显。测试覆盖弱，固件没有单元测试框架，Unity、CMock 都没上，验证主要靠实机和日志。计划是把纯算法部分抽出来在 PC 上跑单元测试，CRC、滤波、阈值、帧解析，异常用例至少 30%。

协议没有版本字段，将来加字段只能靠长度猜。计划是预留一个 version 字节。

功耗没优化，现在是一直跑，没做 STOP 模式加 RTC 唤醒。如果要做电池版，这是第一步。

另外硬件上的妥协，MQ-135 没通道、DHT11 坏掉改 SHT30，我都在文档里留了原因，不算隐藏问题。

### Q5.11 你平时怎么保证代码质量？
**答：** 我的做法大概是这样。编译 0 Error 0 Warning，Keil 的 warning 也当 error 看；关键路径有验收判据写在进度文档里，比如 100 帧 0 CRC 错、30 分钟不复位；协议用独立实现交叉验证，固件算 CRC，Python 复算；每阶段结束做一次断电重启加拔插线的鲁棒性测试，而不是只测正常路径。

### Q5.12 串口 DMA + 空闲中断 和 中断逐字节收，你怎么选？
**答：** 数据量大、帧不定长的时候，我会用 DMA 加 IDLE 中断：DMA 把字节搬进缓冲，总线空闲触发 IDLE，一次性处理整帧，CPU 占用最低。

本项目 LoRa 只有 20 字节、1Hz，用接收中断加环形缓冲加主循环解析就够了，实现简单，也不容易出 DMA 配置错误。选型标准是数据率和帧长，不是哪个高级用哪个。

### Q5.13 为什么 LoRa 用透明传输而不是定点传输？
**答：** 点对点、只有两块板，透明传输最简单：串口进来什么就发什么，不用管地址和信道。定点传输适合一对多、要指定目标地址的场景。

代价是透明模式下所有模块必须同信道同地址，将来加第三个节点就得改定点模式。这也是我在文档里写的扩展方向。

### Q5.14 MQTT 为什么用 QoS0？丢了怎么办？
**答：** QoS0 是最多一次，不保证送达，但开销最小，没有 PUBACK 往返。1Hz 的环境数据丢一两帧不影响趋势，所以用 QoS0。

丢了靠本地缓存补传兜底：板2 每条数据先写 W25Q128，MQTT 发布成功才推进读指针；断网期间数据不丢，恢复后按 50ms 一条补发。

要是做告警上报，比如超标报警，就必须用 QoS1 加去重。

### Q5.15 你怎么理解"实时性"？你的系统是硬实时还是软实时？
**答：** 硬实时是超时就是失败，比如电机控制、安全气囊；软实时是偶尔超时可以接受。这个系统是软实时：采集晚 100ms 不影响结论，MQTT 晚 1 秒也无所谓。

但有两处接近硬实时：IWDG 必须在 4 秒内喂，不然复位；LoRa 发送必须等 AUX，不然丢包。所以任务优先级按错过的代价排，不是按功能重要性排。

### Q5.16 Linux 下进程和线程怎么选？各自怎么通信？
**面试官想听：** 有没有实际写过 Linux 多任务，而不是只背概念。

**答：** 进程有独立地址空间，一个崩了不拖累别人，但通信要过内核；线程共享堆、全局变量和文件描述符，切换便宜、传数据快，但一个线程踩内存全进程一起完。

我的选法：要隔离故障、跑不同权限或不同服务的，用多进程，比如采集服务、网络服务分开，systemd 各管各的；同一份数据要频繁共享、又都是同一业务的，用多线程，配好锁和无锁队列。

通信方式：进程间用 pipe、Unix domain socket、共享内存 + 信号量，跨机用 TCP；线程间用互斥量、条件变量、信号量、无锁队列。共享内存最快，但同步要自己做，最容易出 bug。

**加分/追问：** 多线程里 `fork()` 只复制调用线程，子进程里锁的状态可能不对，所以多线程程序一般不在运行中 fork，要启动子进程就早点做。

### Q5.17 select、poll、epoll 有什么区别？边缘触发和水平触发怎么选？
**面试官想听：** 知不知道 epoll 快在哪，ET 为什么必须非阻塞。

**答：** select 用位图，fd 有 1024 上限，每次调用都要把集合从用户态拷进内核、回来再遍历一遍，fd 多了就慢。poll 换成数组，没上限，但还是要 O(n) 遍历。epoll 把 fd 注册进内核，内核只把就绪的放进队列，`epoll_wait` 拿到的就是有事件的，fd 多时优势明显。

水平触发（LT）只要缓冲区还有数据就一直通知，写起来简单，漏读一次下次还会提醒；边缘触发（ET）只在状态变化时通知一次，必须把 socket 设成非阻塞，循环读到 `EAGAIN` 为止，漏读就会卡住。一般先用 LT，确认性能瓶颈再上 ET。

多线程处理同一个 epoll，要注意 `EPOLLONESHOT`，不然一个 fd 的事件可能被两个线程同时处理。

**加分/追问：** epoll 不是所有场景都快，连接少、事件频繁时和 poll 差不多；它快在“大量连接、少量活跃”。

### Q5.18 Linux 下交叉编译和部署你怎么做？
**面试官想听：** 有没有真的把程序放到板子上跑过。

**答：** 先选对工具链，比如 `arm-linux-gnueabihf-gcc`，编译时带 `--sysroot` 指向目标机的根文件系统，避免误用主机的头文件和库。构建用 CMake 或 Makefile 都行，关键是工具链文件里把 `CMAKE_SYSTEM_NAME`、编译器、sysroot 写死，别靠环境变量。

动态库要跟目标机对得上，部署前用 `ldd` 查依赖，缺库就把 `.so` 一起带过去，或者设 `rpath`；体积紧就 `strip`，要绝对稳就静态链接。传到板子上一般 scp 或 NFS，开机自启用 systemd 写一个 service，别用 rc.local 硬塞。

现场排查先看 `strace` 卡在哪个系统调用，再用 gdb（gdbserver）挂；程序自己至少要有日志和退出码，不然只能猜。

**加分/追问：** 交叉编译最容易踩的坑是头文件和库版本不一致，症状是编译过、运行报 `GLIBC_XXX not found`，所以 sysroot 一定要用目标机同源的。

---

### Q5.19 位域在内存里怎么排？为什么寄存器操作里很少用？

**面试官想听：** 知不知道位域布局是实现定义，不能拿来跨平台。

**答：** C 标准只规定了少量规则（比如位域不能跨存储单元），具体从低位还是高位开始分配、能不能跨字节、对齐到几个字节，由编译器和 ABI 决定。同一个结构体，Keil ARMCC 和 GCC 排出来可能不一样，所以协议帧、寄存器映射不能用位域。

项目里我是用宏做移位和掩码：`(1U << n)` 置位、`& ~mask` 清零，配合 `volatile uint32_t *` 读寄存器；读-改-写怕中断打断，就用 BSRR 这种硬件原子寄存器，或者进临界区。

位域可以用在纯内部的标志结构里，但要加 `static_assert` / `offsetof` 把布局钉死；跨平台通信、存 Flash 一律不用。

**加分/追问：** `volatile` 只保证每次都从内存读，不保证原子；结构体加 `#pragma pack(1)` 能省 padding，但可能带来非对齐访问，Cortex-M4 能扛，外设 DMA 不一定。

---

## 6. 反问环节 & 收尾

### Q6.1 面试官问"你还有什么问题问我？"
**答（挑 2~3 个，按岗位调整）：**
我会挑两三个，看岗位来。比如问这个岗位的嵌入式软件是偏底层驱动、BSP 和 RTOS 移植，还是偏应用协议和业务逻辑；问团队现在的代码评审和测试流程是怎样的，有没有 CI 或者硬件在环测试；问如果我入职，前三个月最希望我交付什么。

对着产品向的岗位，我会问这个产品的量级大概多少，是消费级还是工业级，因为这决定了可靠性设计要投多少。

### Q6.2 如果面试官说"你这个项目是跟着教程做的吧？"
**答（不慌，给证据）：**
教程部分有，比如外设初始化的框架。但有三块是我自己啃出来的。

SysTick 被 FreeRTOS 强符号顶掉导致 HardFault，我是从 map 文件的 `Removing sys_tick.o(i.SysTick_Handler)` 查出来的；I2C 死锁恢复，是自己写 9 个 SCL 脉冲加 STOP，还踩了 `delay_us` 依赖 DWT 的坑；板1 烧不进去，用 J-Link 命令行 `erase` 只花 0.019 秒发现是假擦除，最后 `unlock` 修好选项字节。

这些在教程里都没有。

### Q6.3 项目介绍时的"三句话结构"
**答：**
第一句说是什么：三端环境监测系统，板1 采集、板2 网关、Qt 显示。

第二句说我做了什么：固件这块是 FreeRTOS 五任务、传感器驱动、协议组帧、可靠性；网关是 MQTT 和断网补传；上位机是数据模型、曲线、统计。

第三句说亮点和难点：跨三端协议一致性、断网补传的掉电恢复，还有几个靠 map 和寄存器现场定位的疑难 bug。

---

## 附：常用数字速查（面试时可以准确报出来）

| 项 | 数值 |
|---|---|
| 主频 / 总线 | 168MHz / AHB 168、APB1 42、APB2 84 |
| Flash 等待周期 | 5WS |
| 板1 芯片 | STM32F407ZET6（512KB Flash / 192KB RAM） |
| 板2 芯片 | STM32F407ZGT6（1MB Flash / 192KB RAM） |
| FreeRTOS 堆 | `configTOTAL_HEAP_SIZE = 30KB`（heap_4） |
| 板1 任务栈 | 640 + 512×4 + 384 字 ≈ 12KB |
| 帧长 | 20 字节（含帧头帧尾 CRC） |
| CRC | CRC16-MODBUS，初值 0xFFFF，多项式 0xA001 |
| LoRa 空速 | 2.4kbps（03H=0x62），串口 9600 8N1 |
| LoRa 频率 | 410.125 + 23 = 433.125MHz（05H=0x17） |
| 单帧空中时间 | ≈107ms（32 字节） |
| 1Hz 占空比 | ≈11%（2 秒一帧 ≈5%） |
| IWDG | 4 秒超时，LSI 32kHz |
| I2C 速率 | 100kHz（原 400kHz 不稳定） |
| 采集周期 | 2 秒 |
| 补传节拍 | 50ms/条（20 帧/秒） |
| 板1 编译结果 | Code≈34KB，0 Error 0 Warning |
| 板2 编译结果 | Code≈29KB，0 Error 0 Warning |

---

## 7. 联调实录：现场排障（2026-10-23 补充）

### Q7.1 板子一连上串口助手就白屏/复位，为什么？

**面试官想听：** 你知道 MCU 开发板上常见的"一键下载电路"，并且知道串口库打开端口时会动 DTR/RTS。

**答：** 板上 CH340 的 `DTR#` 和 `RTS#` 经两颗 PNP 三极管接到 MCU 的 `BOOT0` 和 `NRST`，这是自动 ISP 电路：DTR 拉低就复位，RTS 拉低就进 Bootloader。`QSerialPort::open()` 默认把这两个信号置为有效，等于一直按住复位键，MCU 起不来，LCD 面板收不到初始化序列就停在白屏。

追问过怎么在不拆硬件的前提下解决：打开端口后立刻 `setDataTerminalReady(false)` 和 `setRequestToSend(false)`，把两个信号释放掉。串口助手不白屏，是因为它默认不动这两个信号。

坑是一开始怀疑供电，量了 3.3V 是稳的；后来翻原理图看到两颗 2TY 才反应过来。白屏不是 LCD 坏了，是 MCU 根本没跑。

### Q7.2 I2C 为什么会"死锁"，为什么只有断电能恢复？

**面试官想听：** 你理解开漏总线 + 从机可能不释放 SDA 这个协议层缺陷，而不是归咎于"代码写得不好"。

**答：** I2C 是开漏加外部上拉，读操作时 SDA 控制权临时交给从机。只要从机停在输出 0 的状态，SDA 就被永久拉低，主机发 START 只能看到 BUSY。主机超时能放弃，但发 STOP 从机也不听，因为它的状态机已经不在监听了。软件层面无解，只能断电让从机上电复位。

追问过那 9 个 SCL 脉冲的总线恢复有什么用：只对从机发到一半在等时钟的情况有效；对从机内部死机或者掉电复位无效。

坑是我的板子 4 个 I2C 器件共用一个 LDO，LoRa 发射瞬间 120mA 把 3.3V 拉跌，从机掉电复位而 MCU 不知道，之后总线就死在那个从机上。加了连续 3 轮全失败就重初始化 I2C、加单器件离线隔离之后，从 2 小时死一次变成死 3 秒自己活过来。

### Q7.3 屏幕全黑，读 ID 得到乱码，怎么定位？

**面试官想听：** 你用的是"读器件 ID"这种可量化的手段，而不是盲猜接线。

**答：** 先读 ID，正常应该是 `0x009481xx`，读到的是 `0x00032404`，说明命令和数据都错位了。这类现象的典型原因是数据线被别的外设抢走。查引脚分配表，发现 LoRa 驱动的 AUX 脚被配成 PE7 输入上拉，而 PE7 正是 LCD 的 FSMC_D4，一上电就把第 4 根数据线拉住了。

追问过为什么地址和命令还能部分工作：16 位并口按字节访问，D4 被抢后命令的高字节出错，但低字节侥幸对上，所以不是完全没反应，而是读到乱码。

后来我在 GPIO 初始化里加了冲突检测，两个模块抢同一个脚时上电就打印 `CONFLICT E7`，一眼就能定位。

### Q7.4 任务延时设了 2 秒，实测跑成 4 帧/秒，为什么？

**面试官想听：** 你知道 `vTaskDelayUntil` 的语义是"相对上次唤醒时刻"，任务被拖慢后它会不停追赶。

**答：** 采集一轮实际耗时可能超过周期，比如 I2C 失败超时。`vTaskDelayUntil(&last, period)` 发现已经晚了就立刻返回，于是变成能跑多快跑多快，节拍器失效，所以设了 2 秒实测跑成 4 帧/秒。

改成绝对节拍：记录本轮开始 `t0`，算 `used = now - t0`，再 `vTaskDelay(period - used)`，超时就延 1 tick，这样周期才可控。

追问过为什么不直接用 `vTaskDelay`：它从调用时刻起算，会叠加本轮耗时，周期会漂。绝对节拍才是准的。

### Q7.5 队列里有数据，UI 却一直不刷新，为什么？

**面试官想听：** 你能想到"消费者把数据取走了"，而不是怀疑 UI 任务没跑。

**答：** UI 用 `xQueuePeek` 看队列头，而网络任务用 `xQueueReceive` 把帧取走去写 Flash。生产 0.5 帧/秒，消费快得多，队列大部分时间是空的，peek 自然失败。改成生产端另存一份快照，`s_ui_env` 加 `s_ui_dirty`，UI 只读快照，跟队列解耦。

追问过为什么不用 `xQueuePeek` 加锁：peek 本身线程安全，问题是数据不在了，不是竞争。

### Q7.6 插着调试器一按复位就卡在启动第一行，拔掉就好，是固件 bug 吗？

**面试官想听：** 你知道调试器可以通过 `VC_CORERESET` 把内核停在复位向量。

**答：** 不是。J-Link、Keil 连接时设置了 `DEMCR.VC_CORERESET`，复位后内核被 halt 在复位向量，等调试器发 `g`，所以插着调试器按复位看起来像卡死。

判别方法是读 `RCC_CSR`，没有复位标志说明不是复位循环；隔 3 秒读两次 `xTickCount`，不涨说明内核没跑；发 `g` 后涨了就是被 halt 住。

坑是用 J-Link Commander 的脚本最后一定要有 `g`，否则板子停在 halt，串口什么都不打，很容易误判成烧坏了。

### Q7.7 4 个 I2C 器件并联，为什么反而更不稳定？

**面试官想听：** 你知道上拉电阻是并联的，也知道灌电流和总线电容。

**答：** 每个模块自带 4.7k 上拉，4 个并联就是 1.18k，3.3V 下灌电流 2.8mA。廉价模块的低电平驱动能力不足，拉不到 VOL(0.4V) 以下，主机就把它读成高电平，表现为地址能 ACK 但数据段 NACK。再叠加面包板和杜邦线的接触电阻、寄生电容，问题会更明显。

追问过怎么改：只保留一组上拉，新底板上拉默认不焊，按需选择；把速率降到 50kHz 换时序余量，缩短走线并做好地平面。

坑是我把 I2C 从 100kHz 降到 50kHz 后，同样四路传感器立刻从 100% 失败恢复到四路全有效。

---

## 8. 排障方法论（可复用的提问清单）

### Q8.1 设备"时好时坏"，你第一步做什么？

**面试官想听：** 你有"切分 + 对照"的习惯，而不是随机改代码。

**答：** 先做二分，把系统劈成两半，用一次实验判断故障在哪半边。比如串口收不到数据，我先读 `USART1->SR` 和 PA9 电平，如果 MCU 侧全对，就说明断点在线、CH340、电脑这一侧，不用再盯固件。再比如云端上不去，我把 TX/RX 短接做环路测试，能回读到发出的字节就证明 MCU 侧没问题，问题在模块。

追问过如果两边都看起来正常呢：那就找可观测的数字，计数器、寄存器、电压、tick。没有数字的判断都是猜。

坑是我一开始怀疑 ESP 模块的 AT 固件坏了，折腾两轮；做了环路回读、看到 `原始回复: AT` 之后才确认 MCU 侧完好，问题在模块供电。

### Q8.2 怎么区分"程序卡死"和"被调试器停住"？

**面试官想听：** 你知道调试器可以 halt 内核，也知道怎么用寄存器证据排除。

**答：** 三个证据。读 `RCC_CSR`，没有任何复位标志说明不是复位循环；隔 3 秒读两次 `xTickCount`，不涨说明内核没跑；给调试器发 `g` 之后 tick 开始涨，就证明之前是被 halt 按住。另外 `DHCSR` 的 `C_HALT` 位直接反映内核是否暂停。

追问过为什么按复位键救不回来：`VC_CORERESET` 会让内核在复位后立刻再被 halt 在复位向量，除非调试器主动 `g`。

### Q8.3 硬件问题怎么快速定性：代码、接线、还是供电？

**面试官想听：** 你有"先物理层后代码"的优先级判断。

**答：** 我的顺序是供电、接线、总线负载、代码。理由是面包板和杜邦线的接触电阻、寄生电容，还有共用 LDO 的瞬跌，比代码更容易出问题。

验证供电就量 3.3V，发射瞬间要 ≥3.2V；验证接线就单独插一个器件；验证总线负载就量 SDA 到 3V3 的上拉电阻，四个 4.7k 并联成 1.18k，灌电流 2.8mA 就可能让从机拉不到低电平。

追问过怎么证明是时序而不是逻辑：把速率从 100kHz 降到 50kHz，如果立刻恢复正常，就是时序余量问题。

### Q8.4 你怎么让一个"偶发"问题变成"可复现"的问题？

**面试官想听：** 你有概率思维，知道要加计数器和埋点。

**答：** 加计数器，把偶发变成有数：丢帧数、CRC 错数、重试次数、失败比例、缓存水位、栈水位。然后拿节拍器看变化率，比如 `SHT30_FAIL` 和 `TX_OK` 是不是 1:1，就能判断是每帧都失败还是偶发失败。

追问过如果几小时才出现一次：那就把统计打慢一点，5 秒一次，跑一整晚，第二天看斜率。我的 I2C 死锁就是这么定位的，`s_sht30_fail` 每 2 秒 +1，说明每一轮都在失败，不是偶发。

### Q8.5 别人（或者 AI）给你一份 bug 清单，你怎么核实？

**面试官想听：** 你不盲从报告，也不盲信自己；有"落到行号"的习惯。

**答：** 我不会直接照着报告改，先问自己几句。真的存在吗，打开文件指到行；影响谁，有没有被集成、是不是死代码；修它要动什么，改一行、改接口，还是改分区图，代价完全不同。

举个真事。一份外部 AI 的报告给了 13 条风险，其中串口救援态形同虚设和没有回滚标成 🔴 变砖。我去看代码：`boot_uart.c` 的初始化确实只有 `USART_CR1_UE | USART_CR1_TE`，PA10 根本没配复用功能，注释还写着只发，不需要 RXNE 中断，整个 Boot 工程没有任何接收函数。报告是对的，而且比它写的更严重。但第二条双份协议实现漂移，我核对后发现不成立：`protocol.cpp` 和 `frameparser.cpp` 是同协议的 C++ 与 Qt 两种语言实现，本来就不可能像复制粘贴那样一致，而且对照工具是真逐字节比对的。

追问过那变砖到底多严重：要分清影响面。`OTA/` 这套 Boot 加 App 和两块板的交付固件没有集成，所以它只影响 OTA 这个独立示例。同一份清单里资产不在 git、任务返回值全丢这些，才是每天都在影响我的。

### Q8.6 OTA 升级怎么才算"变不了砖"？

**面试官想听：** 你知道"CRC 通过"和"能跑起来"是两件事。

**答：** 我把不砖拆成四层。传输可靠，每包 CRC，错了重发，偏移也纳入校验；安装原子，先写下载区，整片复验通过才搬 App，搬完再复验，最后才作废下载区头，中途掉电头还在，下次上电重搬；可运行性有确认，App 起来后主动报平安，Boot 记录尝试次数，连续 N 次没确认就判定装了跑不起来，不再跳它；有后路，串口救援通道，插上 USB-TTL 就能重灌，不必 SWD。

我第一次做的时候只做了前两层，结果可运行性确认和后路都是空的：救援态只打印一句话，连串口接收都没开；App 有效性只查栈顶和复位向量，CRC 对但一初始化就挂的镜像会被每次上电都跳过去。这类问题不会在正常升级里暴露，只在你最需要它的时候暴露。

追问过为什么不直接双备份、A/B 分区：空间够的话最省心，回滚只是一次指针切换。但 48KB App 加 64KB 下载区加 16KB Boot 之后，剩余扇区都是 128KB 的大扇区，做 A/B 要么扩大芯片，要么接受备份区比 App 大两倍多的浪费。我选的是启动事件日志加连续失败进救援，用 4 字节一条的日志换掉一个 48KB 的备份区。

## 9. 项目讲解稿（三个压轴故事，各 3 分钟）

> 用法：技术面被问「介绍一个你解决过的最难的问题」时，不要讲系统，讲三个里的任意一个。
> 结构固定：**现象 → 怎么切分定位 → 根因（讲到机制层）→ 改了什么 → 怎么验证**。

### 9.1 故事一：I2C 跑几个小时就把总线锁死

**现象：** 板1 跑几个小时以后，四路传感器全部返回错误，`valid=0`，数据帧里全是 0。复位键没用，**只有拔电重新上电才能恢复**。

**定位过程：** 一开始我以为是代码 bug，先看驱动 —— 所有等待循环都有 200000 次的超时兜底，`i2c_start` 会超时返回，不可能死循环。于是我不猜了，直接用 J-Link 挂上去 halt，读 PC：停在 `i2c_start` 里面，说明它在等总线空闲。再看 `GPIOB->IDR`，PB8/PB9 在空闲时**都是低电平**——总线被人拉住了。

**根因（机制层）：** I2C 是开漏结构，导线只能被拉低、只能靠上拉拉高。读操作的时候 SDA 的控制权临时交给从机，从机在输出某一位 0 的时候如果没等到后续时钟，它会**一直保持输出 0**，不释放。这时候主机发 STOP 它也不听，因为它的状态机已经错位了。主机这边只能看到 BUSY，超时机制救不回来 —— 超时只是让主机放弃，不能让从机松手。**只有断电让从机真正上电复位，状态机归零，SDA 才释放。**

为什么"跑久了"才出现：这是概率累积。50 次事务/秒，跑 2 小时就是 36 万次，单次出问题的概率哪怕只有十万分之一，期望也会撞上三四次。

**改了什么：**
1. 失败即调 `SYS_I2C_BusReset()`，发 9 个 SCL 脉冲把从机的移位寄存器"推"完，再补一个 STOP；
2. 每路传感器加健康状态机：连续失败 8 次标记离线、跳过 30 轮再探，避免一颗坏的拖垮整条总线；
3. 连续 3 轮全失败就重新初始化 I2C 外设；
4. 总线从 400kHz 降到 50kHz，给时序留余量。

**怎么验证：** 加了总线空闲检测 —— 初始化时读 IDR，不是高电平就打警告；然后挂机跑，看 `SHT30_FAIL` 有没有从"每次都涨"变成"偶尔涨且能自愈"。

**追问预案：**
- *为什么不加硬件看门狗/为什么不用软件 I2C？* —— 软件 I2C 能把"卡死"变成一个可控的循环，但牺牲 CPU；我这个场景 1Hz 采集，其实可以接受。真按量产做，我会加 I2C 隔离器或把从机放到独立供电轨上。
- *怎么判断是从机拉死而不是上拉丢了？* —— 上拉丢了的话总线是浮空，读出来可能是高；拉到 0 且 release 后不回高，就是从机在拉。

---

### 9.2 故事二：屏幕全黑，读 ID 是乱码

**现象：** 板2 的 3.5 寸 TFT 全黑，什么也不显示。串口日志显示程序跑起来了、LCD 初始化函数返回成功，但就是黑屏。

**定位过程：** 我做了两件事把问题切开：
1. 加了一个**读芯片 ID** 的函数（发 `0xD3` 命令读 3 个字节），正常 ILI9481 应该是 `0x009481xx`，结果读出来是 `0x00032404` —— **ID 是乱码，说明数据线本身有问题**，不是初始化序列的问题。
2. 我把初始化拆成"最小序列"（只发 0x11 退睡眠、0x29 开显示等六条），排除电源/伽马参数不被这块屏接受的可能 —— 还是黑。

**根因：** 翻原理图逐条核对数据线，发现 `FSMC_D4` 是 **PE7**。而 LoRa 驱动的头文件里，AUX 引脚也被定义成 **PE7**（`SYS_LORA_AUX_PORT GPIOE / GPIO_Pin_7`）。`LORA_E22_Init()` 会把 AUX 配成**输入上拉**，等于把 D4 这条数据线从 FSMC 手里抢走了。数据总线少一位，命令和地址全错，自然全黑。

**改了什么：** 注释掉 AUX 的两个宏（板2 的 LoRa AUX 本来就悬空不接），重新编译 —— 屏幕立刻正常。

**怎么验证：** 读 ID 从 `0x00032404` 变成正常值；屏幕上开机菜单正常显示。

**追问预案：**
- *为什么读 ID 能定位到数据线？* —— ID 是芯片内部的固定常量，走的是同一条 16 位数据总线。如果 ID 是对的，说明总线和时序都没问题，问题在初始化序列或面板；ID 错就说明搬运数据的通道坏了。
- *怎么防止再犯？* —— 我把全项目的引脚分配做了一张表，初始化时用 `GPIO_Claim(pin, owner)` 登记，冲突就直接打印谁抢了谁。这个机制当场就抓到了问题。

---

### 9.3 故事三：「一按复位就卡死」

**现象：** 现象很邪门 —— 插着 J-Link 的时候，按复位键板子就停在开机第一行，灯也不动，看起来像死机；**把 J-Link 的 USB 拔掉再按复位，一切正常。**

**定位过程：** 我没有直接改代码，而是先收集三个证据：
1. 读 `RCC_CSR`（复位原因寄存器）= `0x02`，只有 LSI 使能位，**没有任何复位标志** —— 排除复位循环；
2. 隔 3 秒读两次 `xTickCount`（FreeRTOS 的滴答计数），两次值**完全一样** —— 说明 CPU 根本没在跑；
3. 发一条 `g`（Go）让内核继续，1.5 秒后再读，`xTickCount` 涨了 2000 多，`s_state` 从 0 变 1，`s_tx_ok` 开始涨 —— **一放就活**。

**根因：** 不是固件的问题。Keil 在下载/复位时默认会设置 `DEMCR.VC_CORERESET`，意思是"复位后立刻把内核 halt 住"，等调试器下命令。所以你插着 J-Link 按复位，**内核被按在复位向量那里根本没开始跑**。J-Link 的日志里那行 `Reset: Halt core after reset via DEMCR.VC_CORERESET` 就是证据。

**改了什么：** 三个办法，我给了用户三个选项：
1. Keil → Utilities → Settings → Flash Download → 勾 **Reset and Run**；
2. 烧完拔 USB 断电重上电（不要按复位键）；
3. 用自己的 J-Link Commander 脚本烧，脚本末尾 `r` + `g`，烧完自动放开。

**怎么验证：** 拔掉调试器按复位，或者烧完直接断电上电，都能正常跑完启动流程。

**追问预案：**
- *怎么区分"卡死"和"被 halt"？* —— 看 `DHCSR` 的 C_HALT 位，或者最简单：读两次 tick 计数，不涨就是没跑。
- *这是不是说明你的代码其实没问题？* —— 代码没问题，但**默认配置有问题**。用户按复位就"卡死"这个体验，说到底是我们把调试配置留成了开发态。所以我把它写进了文档，也改成用 Commander 脚本烧，避免依赖人的记忆。

---

### 9.4 三句话的收尾（每个故事讲完都可以加）

> "这类问题给我的最大收获不是这个 bug 本身，而是**一套切分问题的方法**：先用一次实验把系统切成两半，再固定其他变量，只改一个。我后来把这套东西整理成了一张按现象查的表，遇到新问题先查表，比凭感觉猜快得多。"

---

## 10. 项目故障假设题（如果……怎么办）

### Q10.1 板1 打印“发送成功”，板2 一直收不到，怎么查？
**面试官想听：** 会不会把链路切成“发端 / 空口 / 收端”三段，而不是乱改代码。

**答：** 先别动固件，按三段切。发端看模块状态：`LORA_E22_WaitReady()` 超时会打 `[发送] AUX 一直忙`（`main.c:642`），AUX 长期忙多半是供电不够或模块没就绪。空口看两边参数：信道、地址、空中速率、串口波特率必须完全一样，E22 是透明传输，参数不一致收端只会收到乱码。收端看板2 的 `rx`/`bad` 计数：`rx` 不涨就是没收到，`bad` 涨是收到了但 CRC 不对。

排查顺序：两块板放近、换好天线和独立电源；用 USB-TTL 直接接模块读配置；板1 发送成功但 AUX 超时，先换电源；板2 收到坏帧，先查波特率和共地。最后才怀疑协议代码。

**加分/追问：** 透明传输模块本身不保证送达，应用层没有 ACK，所以“发了”不等于“收到了”，只能靠板2 的回传或补传来确认。

### Q10.2 断网补传后数据重复或者少了几条，怎么定位？
**面试官想听：** 知不知道补传是“至少一次”，以及掉电时写指针/读指针会不同步。

**答：** 先看日志区结构：每槽 32 字节，`seq` 自增、`ts`、长度、CRC16、20 字节原始帧（`w25qxx_log.h:13-20`）。掉电保护是先把数据写完再写 seq，seq 还是 0xFFFFFFFF 就按空槽跳过（`w25qxx_log.h:19-20`）。所以“少条”先查读指针有没有回写：补传发完不等于对端收到，指针回写早了，掉电就丢；回写晚了，重启会重发。

“重复”多半是对端没去重：MQTT QoS0 没有 PUBACK，补传天然是“至少一次”。我会保留 `seq`，上位机按“启动批次 + seq”去重，或者补传前先问对端已收到的最大 seq。

如果连顺序都乱，先看是不是跨天：`ts` 是 `hh*10000+mm*100+ss`，23:59:59 之后会变小，不能拿来排序（Q3.6）。排序用 seq，ts 只做显示。

**加分/追问：** 清缓存和补传不能并发，清之前先把补传停掉，否则会读到正在擦的扇区。

### Q10.3 设备跑几个小时随机死机或重启，怎么查？
**面试官想听：** 有没有一套从现象到证据的顺序，而不是“加大看门狗”。

**答：** 先分清是“重启”还是“卡死”。重启读 `RCC_CSR`，`SYS_WDG_ResetCause()` 会把 IWDG、BOR、POR 分开（Q2.27）；卡死就读两次 `xTickCount`，不涨就是没跑。

然后看三类证据：`sys_fault.c` 的 HardFault 现场（PC/LR/CFSR）、`[MON]` 里的栈高水位和队列深度、I2C 死锁恢复计数。跑几小时才出，通常是堆碎片、栈慢慢涨、队列偶尔满，或者某个驱动死等。把 `uxTaskGetStackHighWaterMark()` 和队列计数每 5 秒打一次，抓现场比猜快。

复现手段：老化测试 + 定时注入故障（拔 I2C、断网、故意丢帧），看哪一类能复现；再用 map 文件把 HardFault 的 PC 翻成函数名。

**加分/追问：** 如果是 IWDG 复位，先看喂狗任务有没有被更高优先级任务长期饿死，别一上来就加大超时。

### Q10.4 曲线上偶发尖峰，怎么判断是传感器、通信还是显示的问题？
**面试官想听：** 三层证据会不会分开看。

**答：** 通信层看 `errCrc`/`bad` 有没有涨；涨了就是链路问题，先查波特率、共地、线长。通信没问题就看原始帧：把 20 字节打出来，CRC 对、数值确实跳，那就是传感器或滤波。

传感器层再分单点跳还是连续跳。单点跳多半是 I2C 读失败或寄存器没更新，看 `valid` 位和驱动返回码；连续跳可能是电源纹波或光照/气流突变。滤波层看 `filt_push()` 的 8 点窗口，滑动平均只能压白噪声，压不住脉冲，尖峰该用中值或限幅。

如果原始帧和数值都正常，只有曲线跳，那才怀疑 Qt：看 `replot` 时机、环形缓冲有没有越界、横轴序号是不是重复。

**加分/追问：** 板1 和 Qt 各存一份原始帧，出问题先对字节，字节一致再往上查，不然三层互相甩锅。

### Q10.5 串口偶发 CRC 错、丢帧，怎么查？
**面试官想听：** 知不知道 CRC 错不一定是算法错。

**答：** 先看计数器：`rx` 涨、`bad` 也涨，说明字节在收但帧校验不过；`rx` 不涨，是对端没发或线没接对。CRC 错常见四类：波特率偏差（两边时钟源不同、温度漂移）、共地不良（只接 TX/RX 没接地）、线太长或干扰、中断被更高优先级任务拖住导致环形缓冲溢出。

排查：用示波器看波形和波特率，先把波特率降一半试；把 `SYS_USART_Available()` 打出来，接近 256 就是快溢出；RS485 还要看方向脚翻转时机，`FlushTx()` 等 TC 再翻，翻早了会截断最后一个字节。

**加分/追问：** 偶发单字节错先换短线、加共地，别先改 CRC；CRC 参数三端一致是前提，不是怀疑对象。

### Q10.6 升级到一半断电，会不会变砖？你会怎么设计？
**面试官想听：** 项目没有 Bootloader，敢不敢承认，并且能给出完整方案。

**答：** 现在这个项目没有 Bootloader，APP 直接跑，升级中途断电确实可能起不来——这是我在“项目不足”里会主动说的点。

要做得不变砖，我会分三块：Flash 分成 Bootloader + APP A/B 两份；Bootloader 只做校验、跳转、回滚。上电先算 APP 的 CRC 和版本，A 坏了跳 B，B 也坏就停在 Bootloader 等串口/4G 重传。跳转前关中断、设 `SCB->VTOR` 到 APP 的向量表，再取 MSP 和 Reset_Handler。升级包带长度、CRC 和签名，写完先校验再切启动标志；切标志用“写两次 + 反码”防断电。

传输层用现有串口或 4G 都行，关键是断电检测：电压掉到阈值以下先禁止擦写，宁可这次不升，也别写一半。

**加分/追问：** 双区占两份 Flash，成本高；资源紧就单区 + 备份区，或者只做“传输完再擦写”，把风险窗口压到几秒。

### Q10.7 量产 10% 的板子 I2C 读不到传感器，怎么定位？
**面试官想听：** 会不会分“设计问题”和“批次/焊接问题”。

**答：** 先拿一块好板和一块坏板对比：量 SCL/SDA 的上拉电阻和空闲电平，算总线电容（400kHz 对上升沿敏感，线长、器件多会把边沿拉圆）；用 `I2C1 scan` 看地址能不能扫到（`main.c:489`），扫不到先查供电和焊接，扫到但读失败查时序和 clock stretching。

10% 的比例很像批次问题：换一批传感器、换一家上拉电阻、换线材，各测 10 块，看不良率跟哪个变量走。再用示波器看 START/ACK 和上升时间，比猜代码快。

软件上要有恢复：总线死锁时发 9 个时钟再 STOP（Q2.11），读失败重试并计数，别一次失败就判死。

**加分/追问：** 多器件并联先怀疑地址冲突和总线电容，不是每个器件都能在 400kHz 下稳定工作。

### Q10.8 现场时间戳跨天错乱、补传排序不对，怎么办？
**面试官想听：** 知不知道 `hh*10000+mm*100+ss` 的边界。

**答：** 根因是 `ts` 只有时分秒，23:59:59 之后回到 0，拿它排序必然错（Q3.6）。短期先把排序改成按 `seq`，`ts` 只用于显示；补传去重也用 seq，不用 ts。

长期要改协议：加 4 字节“启动批次 + 运行秒数”，或者接 RTC 存完整日期时间。协议一改，板1/板2/Qt 三端必须同时升，`LEN` 也要加，老设备兼容要提前想——可以加版本字段，老端按长度截断解析。

现场先看设备是不是每天固定时间出错，是的话基本就是跨天，不是通信丢帧。

**加分/追问：** 时间戳只负责显示，去重和排序靠 seq；这个分工定下来，跨天就不会影响补传正确性。

### Q10.9 MQTT 断线后疯狂重连、被平台限流，怎么处理？
**面试官想听：** 有没有退避和“只保留一个连接”的意识。

**答：** 先看重连策略：失败就立刻重试，网络没恢复时会形成风暴，平台直接封 IP。我会改成指数退避 + 随机抖动，比如 1s、2s、4s、8s，上限 60s，每次加 0~30% 抖动，避免一批设备同时重连。

连接成功前不发布，数据进 W25Q 缓存；连接成功后先补传再实时发。keepalive 要大于最长阻塞时间；QoS0 没有 PUBACK，别拿“发出去了”当“平台收到了”。

还要保证只有一个连接实例：重连前先断开旧 socket，ESP8266 的 AT 状态机清回初始态，不然会出现“假连接”。

**加分/追问：** 平台限流一般按连接数或消息速率，退避只能缓解，真要稳还得控制上行频率和补传节拍。

### Q10.10 产品要加第二路传感器或 4G 模块，架构怎么改？
**面试官想听：** 会不会先动协议和任务边界，而不是往原来的任务里硬塞。

**答：** 先看现在的边界：板1 是采集 + 组帧，板2 是网关。加传感器优先加在板1，新开一个采集任务 + 队列，别塞进 `vTaskSensor` 里阻塞；协议加字段要先改 `LEN` 和版本，三端一起升。

加 4G 优先换板2 的通信任务，不让它碰采集；4G 的 AT 状态机和 MQTT 分开，重连时只影响上传，缓存继续写。资源上先算 RAM（任务栈、环形缓冲）和功耗（4G 峰值电流），电源单独留余量。

**加分/追问：** 别在原来的帧上直接加字段还不改 LEN，老 Qt 会按旧长度解析，越界或 CRC 错，现场很难查。

### Q10.11 Qt 界面跑久了越来越卡、内存一直涨，怎么查？
**面试官想听：** 分得清 CPU 卡和内存涨。

**答：** 先分清是 CPU 还是内存。CPU 看 `replot` 频率和数据量：每来一帧就重画、环形缓冲无限增长，都会越来越慢；QCustomPlot 要限制点数，旧数据 `removeDataBefore` 或固定窗口。

内存涨看对象数：动态创建的图例、临时对话框有没有 parent、有没有重复 connect；用 `findChildren` 计数、看长时间曲线。信号槽如果每帧都排队，事件队列也会涨，能直接调函数就别绕信号槽。

**加分/追问：** 先把“每帧重画”改成定时批量重画（比如 50ms 一次），很多卡顿当场就没了。

---

## 11. 格外题清单（项目里没有，但面试可能问）

### Q11.1 启动、升级与安全
- Bootloader/IAP：分区、跳转前关中断、`SCB->VTOR`、CRC/签名、A/B 回滚。为什么问：量产升级必问。
- 固件签名与安全启动：密钥存哪、防篡改、防回滚。为什么问：物联网设备常见。
- OTA 差分升级：差分包怎么做、校验、失败回滚。为什么问：流量和升级时间。
- 启动时间优化：时钟、外设初始化顺序、延迟初始化。为什么问：车规/消费电子都在意。

### Q11.2 总线与外设
- CAN/CAN-FD：仲裁、位定时、错误帧、终端电阻。为什么问：汽车/工控高频。
- USB：枚举、描述符、CDC/HID、DMA。为什么问：设备互联。
- Ethernet/LwIP：ARP、TCP 状态机、零拷贝、PHY。为什么问：网关类岗位。
- SDIO/FatFS：卡初始化、扇区读写、文件系统掉电。为什么问：数据记录类产品。
- Modbus/RS485：半双工方向、3.5 字符间隔、CRC、从机地址。为什么问：工控现场总线。
- 外部 ADC/DAC：采样率、基准、滤波、校准。为什么问：模拟量采集。

### Q11.3 RTOS 与底层
- FreeRTOS 移植：PendSV/SVC/SysTick、临界区、栈对齐。为什么问：换芯片就要移植。
- tickless 低功耗：空闲钩子、唤醒补偿。为什么问：低功耗产品必问。
- 内存池/TLSF：碎片、分配时间、失败策略。为什么问：长期运行设备。
- CPU 占用率统计：空闲计数、高优先级任务。为什么问：性能评估。
- Trace/SystemView：任务切换、队列事件。为什么问：复杂时序问题。
- MPU/内存保护：栈溢出、越界。为什么问：高可靠产品。

### Q11.4 硬件与 EMC
- 电源树：LDO/DCDC、纹波、峰值电流、上下电时序。为什么问：4G/电机类负载。
- 去耦与地线：0.1uF/10uF 放哪、模拟地/数字地、单点接地。为什么问：ADC/通信不稳。
- 电平转换：3.3V/5V 双向、MOS/专用芯片。为什么问：外设混压。
- TVS/ESD/防反接：接口防护。为什么问：现场设备。
- EMC 测试：辐射/传导、屏蔽、磁环。为什么问：量产认证。

### Q11.5 测试与工程化
- 单元测试/HIL：桩、硬件在环、故障注入。为什么问：团队有没有测试。
- 静态分析/MISRA：规则、误报、落地方式。为什么问：汽车/医疗。
- CI：编译、静态检查、固件产物、版本号。为什么问：交付质量。
- 老化/长时间运行：内存泄漏、看门狗、日志。为什么问：稳定性。
- Git/评审：分支模型、提交粒度、code review。为什么问：协作。

### Q11.6 Linux 与 Qt 进阶
- 字符设备驱动：file_operations、ioctl、阻塞/非阻塞。为什么问：Linux 岗。
- 设备树：compatible、reg、中断、pinctrl。为什么问：ARM Linux 必问。
- Buildroot/Yocto：交叉编译、根文件系统、包管理。为什么问：产品化。
- QML/Quick：与 Widgets 取舍、性能。为什么问：现代 Qt 界面。
- Model/View：自定义 model、大数据量。为什么问：表格/日志界面。
- Qt 多线程：QThread、moveToThread、跨线程信号。为什么问：串口/网络并发。
- 打包发布：windeployqt、依赖、安装包。为什么问：交付。

### Q11.7 算法与控制
- PID：位置式/增量式、积分饱和、死区。为什么问：控制类岗位。
- 卡尔曼/互补滤波：建模、调参、何时值得。为什么问：传感器融合。
- FFT：采样定理、窗函数、频谱。为什么问：振动/音频。
- 边缘 AI：模型量化、推理框架、内存。为什么问：智能设备。

---

## 12. 光谱项目（简历补充，源码不在本仓库）

### Q12.1 光谱分析上位机的完整链路是怎样的？
**面试官想听：** 你能不能一句话讲清数据从仪器到谱线。

**答：** 微型光谱仪通过串口把原始采样送上来，上位机按协议找帧头、长度和校验，解析成一条按像素/波长排列的谱线；然后依次做暗噪声扣除、基线校正、平滑滤波，最后用 QCustomPlot 实时画出来。积分时间、触发采集这些参数也走同一条串口，命令和应答分开处理。

和嵌入式那个项目不同，这里的数据源是现成仪器，协议是仪器厂商定的，我主要做的是**解析、谱线处理和界面**，不是去写固件。

**加分/追问：** 谱线横轴是像素号还是波长，取决于仪器有没有给波长定标表；有定标表就换算成 nm，没有就按像素号显示，不能瞎标。

### Q12.2 串口一次收到的不是一整帧，你怎么保证解析正确？
**面试官想听：** 粘包/半包的处理，不是“readAll 直接解析”。

**答：** 串口是字节流，一次 `readyRead` 可能是半帧、一帧半或者两帧粘在一起。我用一个累积缓冲 + 状态机：先找帧头，再读长度，等缓冲够一整帧才取出来校验；校验通过就投递，失败只丢**一个字节**重新找帧头，不整段清空——整段清空的话，一次干扰会把后面粘着的好帧一起扔掉。

**加分/追问：** 缓冲要有上限，比如 4KB，超了就丢最旧的重新同步；否则对端一直发坏帧，内存会一直涨。

### Q12.3 暗噪声和基线校正具体怎么做？顺序能不能反？
**面试官想听：** 知不知道为什么先暗噪声再基线。

**答：** 暗噪声是关光或遮光时采的参考谱，测量前先存一份，之后每条测量谱逐点减掉它，去掉探测器暗电流和偏置。基线是谱线的缓慢背景漂移，用两端或若干背景点做多项式/分段线性拟合，再从谱线里减掉。

顺序不能反：**先减暗噪声，再拟合基线，最后平滑**。反过来的话，暗噪声的台阶会被基线拟合带进去，平滑又会把台阶抹成斜坡，峰位和峰高都会偏。

**加分/追问：** 暗噪声不能只采一次用到底，温度漂移大的仪器要定期重采；否则减完会出现负值或基线整体上漂。

### Q12.4 平滑滤波用的什么算法？窗口怎么选？
**面试官想听：** 有没有“窗口不能大于峰宽”的意识。

**答：** 最朴素的滑动平均，窗口按光谱仪的分辨率选：窗口必须小于特征峰的半高宽，不然峰会被削平、峰高被压低。如果既要平滑又不想压峰，可以用 Savitzky-Golay，它用多项式拟合代替简单平均，能保住峰形。

卡尔曼在这里不合适——光谱是一条静态谱线，不是随时间演化的状态，没有状态方程可建。评价滤波好坏也不能只看曲线光不光滑，要看信噪比和峰高保留。

**加分/追问：** 平滑窗口、暗噪声、基线这三个参数应该做成可配置的，不同仪器/不同积分时间下最优值不一样，写死一个数换个场景就废了。

---

## 13. 学生管理系统（简历补充）

### Q13.1 主存储为什么用顺序表，补考名单为什么用链表？
**面试官想听：** 容器选型是不是按操作特点来的。

<!--code: 简历/附属项目_学生管理系统/mylib.h:42-84 -->
**答：** 主存储要按学号二分查找，必须连续内存、能随机访问，所以用动态顺序表；补考名单只做插入、删除和遍历，不按下标访问，用链表可以免去整体搬移；撤销栈固定 20 深、只在一端进出，用数组栈最简单。

一句话：**要随机访问就用顺序表，要频繁中间增删就用链表，要后进先出就用栈**。

**加分/追问：** 顺序表插入删除是 O(n)，但学生规模就几十条，二分查找 O(log n) 的收益更实在；真到几万条再考虑跳表或哈希。

### Q13.2 顺序表满了怎么扩容？realloc 失败怎么办？
**面试官想听：** 会不会写出“先赋值再判断”的丢数据 bug。

<!--code: 简历/附属项目_学生管理系统/mylib.c:40-71 -->
**答：** 长度等于容量时，把容量乘 2 调 `realloc`；返回值先接到临时指针，成功才赋回 `list->data`，失败直接返回 `ENOMEM`，原数组、长度、容量都不动。

先赋值再判断是最容易犯的错：`realloc` 失败会返回 NULL，直接把返回值赋给原指针，原数组就丢了。2 倍扩容是为了摊还 O(1)，代价是可能浪费一倍内存；数据量大又在意内存可以用 1.5 倍。

**加分/追问：** `realloc` 可能原地扩，也可能搬到新地址，所以不能提前把 `data` 的地址存到别的长期指针里。

### Q13.3 二分查找的边界怎么写？有哪些坑？
**面试官想听：** 边界和返回值语义。

<!--code: 简历/附属项目_学生管理系统/mylib.c:109-130 -->
**答：** `left=0`、`right=length-1`，循环条件 `left<=right`；`mid = left + (right-left)/2`，不用 `(left+right)/2` 是为了防两数相加溢出。相等就返回下标，小于往右，大于往左；找不到返回负的错误码。

最大的坑是**把错误码当下标用**：`seq_find_by_id` 找不到返回 `SEQ_NOT_FOUND`（-3），调用方如果只判 `!= 0` 就去访问 `data[-3]`，直接越界。所以我统一约定：只有 `>=0` 才是下标。

**加分/追问：** 顺序表必须始终保持学号升序，二分才成立；插入时按序找位置、删除后不破坏顺序，这两点比二分本身更容易出错。

### Q13.4 撤销栈为什么存整条记录，而不是只存学号？
**面试官想听：** 撤销的恢复语义。

<!--code: 简历/附属项目_学生管理系统/mylib.h:68-84 简历/附属项目_学生管理系统/mylib.c:293-320 -->
**答：** 撤销栈里存的是「操作类型 + 整条 `student_t` 快照 + 下标」。只存学号不够：修改操作可能改了姓名和 5 门成绩，撤销时必须把旧值原样写回，只凭学号找不回被覆盖的字段。

撤销时按类型反向执行：`OP_ADD` 就按学号删掉、`OP_DEL` 就把整条插回、`OP_MOD` 就把旧记录写回原下标。栈满 20 就提示“本次操作不可撤销”，不覆盖最旧的一条——覆盖会让更早的操作永远撤不回来。

**加分/追问：** 撤销完还要同步补考名单，否则删了一个挂科生再撤销，主表回来了、链表里却没有他。

### Q13.5 你修的那几个缺陷里，最典型的是哪个？怎么定位的？
**面试官想听：** 有没有真实的调试过程，而不是“我写了就对了”。

<!--code: 简历/附属项目_学生管理系统/main.c:138-150 简历/附属项目_学生管理系统/main.c:196-212 -->
**答：** 最典型的是“只改姓名，整条成绩变成垃圾值”。根因有两个：`stu` 在 `main()` 里跨 `case` 复用、进修改分支时没初始化；改完又把整个结构体提交，没改的字段全是栈上的随机值。

修法是先 `new_stu = old_stu` 拿原记录当底稿，只覆盖用户真正改的字段；再加一个 `changed` 标记，用户直接选 0 退出就不提交。定位靠管道喂输入 + 回看输出，逐字段对比“改前/改后”，一眼就能看到成绩字段被写坏。

**加分/追问：** 同一个套路还修了“输入字母死循环”——`scanf` 返回值没判、非法字符留在缓冲区，后面一直读到同一个字符；判返回值并清空整行就好了。

### Q13.6 文件读写怎么做的？如果要求改完自动保存，你会怎么加？
**面试官想听：** 知不知道自己代码的边界，别把“只读”说成“读写”。

<!--code: 简历/附属项目_学生管理系统/mylib.c:342-383 -->
**答：** 启动时 `fgets` 逐行读，`sscanf` 按“学号,姓名,5 门成绩”7 个字段解析，算完平均分再插入；字段不够就跳过并打印这一行，不让一条坏数据把整个加载打断。

当前版本**只加载、退出不写回**，这是已知缺口。要补自动保存，我会加 `save_students_to_file()`：按同样格式 `fprintf` 到临时文件，写完 `fclose` 再 `rename` 覆盖原文件；直接覆盖原文件时如果写到一半断电，原数据就没了。保存时机放在每次增删改和撤销成功之后，或者退出时统一保存。

**加分/追问：** 写文件也要判 `fprintf`/`fclose` 的返回值，磁盘满或只读目录时不能假装成功。

---

## 14. 验货题速查（2026-10-29 补充，面试高频）

> 这类题不考深度，考的是「名字和数字能不能立刻报出来」。面试官用它判断项目是不是你亲手写的，所以答案必须是准确的名词 + 一个数字或细节，不是讲道理。
>
> 统一答法：**先报准确名词 → 一句「为什么这么选」→ 补一个只有写过才知道的细节**。不确定就说「这块我回去确认」，别编；编错一个型号，后面全盘都不可信。

### 14.1 Qt 上位机（面试官最常问的一组）

### Q14.1 你这个软件用的什么库？
**答：** 主体是 Qt Widgets，串口用 QtSerialPort 模块，曲线用第三方 QCustomPlot（要 `QT += printsupport` 才能编译），Qt 6.11.2 + MinGW 64 位。业务逻辑是纯 C++ 类，只有管串口的 `DevCtl` 继承 `QObject`。

**别再说「原生 Qt 库」：** QCustomPlot 不是 Qt 官方的东西，一句「原生」会被下一句「曲线怎么画的」当场戳破。（详见 Q4.1 / Q4.4）

### Q14.2 界面上的图标是怎么实现的？
**答：** 这个工程没有图片图标，没有 `.qrc` 资源文件，也没调 `setWindowIcon()`。按钮全是文字；状态颜色用 QSS（`QFrame` 左边框）；顶部五路汇总条是自己重写 `paintEvent`、用 `QPainter` 画的。代码里确实出现过 `QPixmap`，但只在 `--shot` 截图时用 `w.grab()` 渲染窗口，和图标无关。

**先澄清再答：** 如果对方说的「图标」其实是「曲线图」，那是另一回事，见 Q14.7。中文「图标 / 图表」差一个字，答错就是答非所问。

### Q14.3 如果要用图片图标，Qt 里怎么做？
**答：** 图片放进 `.qrc`（qmake 写 `RESOURCES += app.qrc`，CMake 用 `qt_add_resources`），用 `QIcon(":/icons/xx.png")` 再 `setIcon()`；系统图标用 `style()->standardIcon(QStyle::SP_...)`——`standardIcon` 是 `QStyle` 的成员函数，不是静态函数。也可以用图标字体：`QFontDatabase::addApplicationFont()` 加载后按码位取字符。qrc 由 rcc 在编译期转成 C++ 编进二进制，运行时不用带图片目录；SVG 图标还要加 Qt Svg 模块（`QT += svg`）。

### Q14.4 你用了哪些控件？类是什么？
**答：** 主窗口 `QMainWindow`，中央用 `QSplitter` 分三栏；左栏 `QGroupBox` 里放 `QComboBox`、`QPushButton`、`QCheckBox`、`QLabel`；中栏是 `QCustomPlot` 加自绘的 `SummaryStrip`（`QWidget`）；右栏 `QTableWidget` 显示报警，`QFrame` + `QLabel` 做统计卡片。阈值设置是 `QDialog` + `QDialogButtonBox` + `QDoubleSpinBox`。

### Q14.5 你自己写了哪些类？分别继承什么？
**答：** 界面层 `MainWindow : QMainWindow`、`ThresholdDialog : QDialog`、`SummaryStrip : QWidget`（自绘）；通信层 `DevCtl : QObject`（包 `QSerialPort`、发信号）；逻辑层 `FrameParser`、`DataModel`、`AlarmManager`、`CsvRecorder`、`StatCalc` 都是普通 C++ 类，不继承 `QObject`。

**这句是加分点：** 只有需要信号槽的才继承 `QObject`，说明是按职责拆的，不是把所有东西塞进 `MainWindow`。

### Q14.6 界面是拖的还是写的？
**答：** 主窗口骨架在 `.ui` 里拖，编译时 uic 生成 `ui_mainwindow.h`；动态卡片、图例、按钮在代码里 `new`；`QCustomPlot` 是在 Designer 里把 `QWidget` 提升（promote）过去的。

### Q14.7 曲线图是怎么画的？用的什么库？
**答：** QCustomPlot，第三方控件，不是 Qt 自带。它是 `QWidget` 子类，内部用 `QPainter` 自绘；我用 `QCPGraph` 存点、`addData` 追加，环形缓冲定长，`replot` 做了合并和降频，横轴是数据序号，刻度是自写的 `QCPAxisTicker` 子类。Qt 自带的 QtCharts 我没用。

### Q14.8 QCustomPlot 的许可证是什么？
**答：** GPLv3 和商业授权双许可。自己学习、开源发布走 GPL 没问题；公司产品要么买商业授权，要么换方案，不能默认「网上下的就能商用」。

### Q14.9 信号槽怎么连的？跨线程会怎样？
**答：** 新语法 `connect(sender, &Cls::sig, receiver, &Cls::slot)`，编译期就能查错。默认 `AutoConnection`：同线程直接调用，跨线程自动变成 `QueuedConnection`，参数要能拷贝。这个项目串口和界面都在主线程，没用 QThread（见 Q4.7 / Q4.33）。

### Q14.10 这个工程怎么构建？源码怎么分？
**答：** qmake 工程 `SerialMonitor.pro`，`QT += widgets serialport printsupport`，Qt 6.11.2 + MinGW 64 位。源码按职责分：`main.cpp`、`mainwindow.*`、`devctl.*`（串口）、`frameparser.*`、`datamodel.*`、`alarmmanager.*`、`statcalc.*`、`thresholddialog.*`，另有 `tests/parsertest` 做解析器的独立测试。

### Q14.11 不开窗口怎么自检？
**答：** `main()` 里解析参数：`--selftest` 跑帧解析和统计一致性自检、结果写文件；`--feed` / `--view` 灌数据并切到指定物理量；`--dumpmin` 打印控件最小尺寸，排查裁切。所以放 CI 里能直接跑，不依赖界面。

### 14.2 板1 / 板2 固件（报型号、报数字）

### Q14.12 用的什么芯片？主频多少？
**答：** 板1 `STM32F407ZET6`，板2 `STM32F407ZGT6`。HSE 8MHz 进 PLL，`PLLM=8 / PLLN=336 / PLLP=2`，SYSCLK 168MHz，AHB 168、APB1 42、APB2 84，Flash 5 等待周期。（详见 Q2.1）

### Q14.13 RTOS 用了吗？几个任务？
**答：** FreeRTOS。板1 六个任务：mon / comm / sensor / loraRx / process / ui，优先级 5/4/3/3/3/2，两个队列深度都是 4；板2 也是六个任务，lora=4、cmd=4、net=3、replay=2、ui=2、mon=1，`s_q_env` 深度 8。（Q2.4 / Q3.2）

### Q14.14 传感器型号和 I2C 地址？
**答：** SHT30 `0x44`、BMP280 `0x76`、BH1750 `0x23`、CCS811 `0x5A`，地址脚都接地；I2C1 用 PB8 / PB9，开漏加外部上拉，跑 100kHz——400kHz 时偶发 NACK 才降下来的。（Q2.10 / Q2.12）

### Q14.15 LoRa 什么型号？接哪路串口？发之前为什么要等 AUX？
**答：** E22-400T22D，透明传输。板1 挂 USART3（占原 ESP8266 座，PB10/PB11），板2 挂 USART6（PC6/PC7）。AUX 是忙指示，低电平表示模块还在发射或配置，接了 AUX 就得等它变高再发，否则内部缓冲被冲爆。

**但要说实话：** 这两块板的 AUX 都没接——板1 的 AUX 宏被注释掉，板2 的 PE7 被 LCD 的 FSMC_D4 占了，`aux_port == 0` 时驱动走固定 2ms 延时兜底，不是真的在等 AUX。（Q2.22 / Q2.23 / Q3.31）

### Q14.16 联网怎么做的？
**答：** 板2 用 ESP8266，AT 指令配 WiFi 和 MQTT，连巴法云；MQTT 3.1.1、QoS0，topic 用 `#` 分隔的文本，不是 JSON。（Q3.13 / Q5.14）

### Q14.17 一帧多长？字段怎么排？CRC 什么参数？
**答：** 20 字节：`AA 55` + 命令 + 长度 + 12 字节数据 + CRC16 + `55 AA`。CRC 是 CRC16-MODBUS（0x8005 反射、初值 0xFFFF），从帧头之后算到数据末尾，帧尾小端。固件算一遍，Python 再独立复算一遍。（Q2.20 / Q2.21 / Q3.7）

### Q14.18 Flash 缓存多大？能存多久？
**答：** W25Q128，255 个扇区 × 4KB ≈ 1020KB，每槽 32 字节，共 32640 条；2 秒一帧约 18 小时。清缓存要逐扇区擦，满库要十几秒，所以清的时候要停补传。（Q3.22 / Q3.16）

### Q14.19 看门狗怎么配的？
**答：** IWDG，4 秒超时，`vTaskMonitor` 每 100ms 喂一次；喂狗之外还看心跳计数有没有在涨，卡死但还在喂狗也能发现。复位原因靠 `RCC->CSR` 的 IWDG / WWDG / 软件复位标志区分。（Q2.26 / Q2.27）

### Q14.20 采样和补传的节奏？
**答：** 板1 每 2 秒采一帧发一帧；板2 断网时写 Flash，恢复后 50ms 一条按时间顺序补传，补完主动发一帧完成应答。（Q3.16）

### Q14.21 上电到 main 之间做了什么？启动文件的栈多大？
**答：** 复位向量 → `SystemInit()`（开 FPU、设向量表基址）→ `__main`（`.data` 从 Flash 搬 RAM、`.bss` 清零）→ `main()`。启动文件里 `Stack_Size = 0x400`（1KB 主栈）、`Heap_Size = 0x200`（512B）；这是裸机主栈，FreeRTOS 的任务栈从 30KB 的 `heap_4` 里另分。

### Q14.22 中断优先级怎么配的？为什么都设 5？
**答：** `NVIC_PriorityGroup_4`，4 位全给抢占（0~15），子优先级恒 0。USART / DMA / EXTI / RTC 默认抢占都设 5。原因是 `FreeRTOSConfig.h` 里 `configLIBRARY_MAX_SYSCALL_INTERRUPT_PRIORITY = 5`：数值 ≥5 的中断里才能调 `FromISR` API，数值更小（更急）的中断不能碰 RTOS，否则破坏内核临界区。

### Q14.23 串口接收是中断还是 DMA？缓冲多大？
**答：** 板1 用 RX 中断逐字节收（`SYS_USART_InitRxIT`），每路环形缓冲 256 字节（`SYS_USART_RX_BUF_SIZE`），中断抢占 5。没用 DMA——2 秒一帧的量太小，中断完全够，DMA 反而多一层配置。板2 只初始化 USART1（调试/上位机，115200）和 USART3（ESP8266），USART2 没初始化。

### Q14.24 HardFault 了你留了什么？
**答：** `SYS_FAULT_Record` 存 `type / from_psp / pc / lr / psr / r0-r3 / r12 / cfsr / hfsr / mmfar / bfar / count`，Keil 的 Watch 窗口直接看；`SYS_FAULT_Report()` 能打成一行文本。定位时先看 `pc` 回 map 找函数，再看 `CFSR` 区分是总线、用法还是内存管理故障。

### Q14.25 W25Q 一页多少字节？擦一个扇区多久？
**答：** 页 256 字节（一次最多写 256）、扇区 4KB（最小擦除单位）、块 64KB；扇区擦除典型 45ms，255 个扇区满库清一次十几秒，所以清缓存要分步，期间 `LogWrite` 返回 BUSY。

### Q14.26 简历写了 TIM，项目里到底用在哪？
**答：** 主程序没拿硬件 TIM 干业务，采样靠 FreeRTOS 节拍；`sys_tim.c` 里封了 TIM1~14 的 PWM、输入捕获、输出比较、ETR，属于外设练习和扩展储备。面试别硬说“项目里用 TIM 做了 PWM”，被问哪一路、哪个引脚就露馅。

### 14.3 光谱项目 / 学生管理

### Q14.27 光谱上位机用什么写的？做了什么？
**答：** C++11 + Qt，串口 QSerialPort，绘图 QCustomPlot。把微型光谱仪送来的原始采样解析成谱线，做暗噪声扣除、基线校正、平滑滤波后实时绘图，并能下发积分时间和触发采集。（Q12.1）

### Q14.28 光谱项目的成果怎么量化？
**答：** 支撑 SPR 系统 50–500 μg/L 碳酸根离子双模检测，和标准光源联调通过；成果是 SPIE 会议论文第 4 作者，DOI 在简历上，要能张口报出来。

### Q14.29 学生管理系统用了哪些数据结构？为什么？
**答：** 主表用顺序表（按学号升序，查找走二分），补考名单用单向链表（频繁插删），撤销用栈（存整条记录快照），启动时从文本文件载入。顺序表满了按 2 倍 `realloc`，失败就退回原表。（Q13.1 / Q13.2）

### Q14.30 撤销为什么存整条记录？
**答：** 修改可能动了姓名和多门成绩，只存学号找不回被覆盖的旧值；所以栈里存「操作类型 + 整条 `student_t` + 下标」，撤销时按类型反着做。（Q13.4）

### Q14.31 光谱项目里你具体做了哪部分？
**答：** 仪器和串口协议都是现成的（厂商定的），我做三块：协议解析（粘包/半包、校验）、谱线处理（暗噪声、基线、平滑）、界面（QCustomPlot 实时绘图和参数下发）。固件不是我写的，这个项目里我是上位机开发。

**加分点：** 主动划边界，别把厂商仪器算成自己做的。

### Q14.32 光谱串口一次不是一整帧，怎么解析？
**答：** 累积缓冲 + 状态机：先找帧头，再按长度字段等够一整帧，校验通过才取；失败只丢 1 个字节重新同步，不整段清空。缓冲设上限（4KB），超了丢最旧的，防止对端一直发坏帧把内存撑爆。

### Q14.33 谱线处理顺序是什么？横轴怎么定？
**答：** 顺序固定：减暗噪声 → 拟合基线 → 平滑，不能反；反了暗噪声的台阶会被基线拟合带进去。横轴有波长定标表就换算成 nm，没有就按像素号显示，不能瞎标；平滑窗口要小于特征峰半高宽，不然峰会被削平。

### Q14.34 学生管理里 student_t 多大？字段怎么排？
**答：** 48 字节：`int id` 4，`char name[20]` 20，`float scores[5]` 20，`float avg` 4，都是 4 字节对齐，正好填满、没有空洞。撤销项 `undo_item_t` 是 56 字节（枚举 4 + 整条 48 + 下标 4），20 深的栈约 1124 字节。

### Q14.35 主表初始容量多少？满了怎么扩？
**答：** `seq_init()` 起始容量 10，插入时 `length >= capacity` 就按 `capacity * 2` 调 `realloc`；失败返回 `ENOMEM`，原指针不动、数据不丢。2 倍是为了均摊 O(1)，1.5 倍省内存但搬移更频繁。

### Q14.36 二分怎么写的？边界怎么定？
**答：** `left = 0, right = length - 1`，`while (left <= right)`，`mid = left + (right - left) / 2`（防溢出）；小于目标 `left = mid + 1`，大于 `right = mid - 1`，相等返回下标，没找到返回 -1。主表按学号升序插入，所以能二分。

### Q14.37 撤销栈多深？文件一行几个字段？
**答：** 撤销栈 20 深（`MAX_UNDO_SIZE`），存「操作类型 + 整条 `student_t` 快照 + 下标」，满了就提示本次不可撤销，不覆盖最旧的。文件一行 7 个字段：`id,name,score1..score5`，用 `sscanf("%d,%19[^,],%f,%f,%f,%f,%f")` 解析，返回值不是 7 就跳过并打印该行；算完平均分再按学号插入。

### 14.4 基本功与板级细节（2026-10-29 补，10 条）

### Q14.38 你项目里的结构体多大？有没有对齐填充？
**答：** 板1 的 `SensorMsg_t` 是 20 字节：前 7 个字段都是 2 字节、占 14 字节，`uint32_t tick` 要 4 字节对齐，14~15 补 2 字节；`ProcResult_t` 正好 20 字节、没有填充。Qt 侧 `EnvFrame` 是 16 字节，末尾补 1 字节（最大对齐是 2）。

**追问位域：** 协议里不用位域，布局是实现定义的；状态位用 `uint16_t` + 宏移位拼，`valid` 是 bitmap 不是 bool 数组。（Q2.19 / Q5.19）

### Q14.39 volatile 具体加在哪些变量上？
**答：** 三处典型：`key_exti_flag[]`（EXTI 中断置位、主循环清零，`key.c:157`）；`led_bl_period/on/cnt/en`（任务写、tick hook 读，`led.c:228-231`）；`beep_as_times/on/off/cnt/phase`（任务写、定时器中断读，`beep.c:111-116`）。另外 `delay_loop(volatile uint32_t n)`，不加编译器会把空循环优化掉（`delay.c:14`）。

**边界：** volatile 只保证每次都从内存读，不保证原子；16 位计数器跨中断读要临界区（Q3.21）。

### Q14.40 窗口布局怎么搭的？拉伸时会不会乱？
**答：** 中央 `QHBoxLayout` → `QSplitter` 三栏，每栏内再套 `QVBoxLayout`；中栏自上而下是卡片 `QGridLayout`、勾选行 `QHBoxLayout`、`QCustomPlot` 伸展。拉伸因子 0/1/0，窗口变大只有中栏吃增量；初始 330/660/330 是在 `showEvent` 里按真实宽度算的（构造时尺寸还没定），左栏最小宽 300。

### Q14.41 曲线谁驱动刷新？周期多少？
**答：** `QTimer` 驱动，不是来一帧画一次：`m_plotTimer` 50ms（20Hz）调 `onPlotTick`，`m_statsTimer` 1s 刷统计；数据本身 2 秒一帧，界面刷新远快于数据变化。`replot` 用 `rpQueuedReplot`，同一轮的多余重绘会合并。

### Q14.42 串口怎么打开的？参数是什么？
**答：** `QSerialPort`：端口取下拉框，默认 115200 / 8 数据位 / 无校验 / 1 停止位 / `NoFlowControl`，用 `ReadWrite` 打开（控制命令要往同一个口写，只读打开发不出去）。数据走 `readyRead`，一次 `readAll()` 喂给解析器的累积缓冲，不假设一次就是一帧。

### Q14.43 exe 怎么打包给别人跑？
**答：** 我平时在 Qt Creator 里直接跑，没做过正式发布包。要发版就用 `windeployqt --release SerialMonitor.exe`：它会拷 `Qt6Core/Gui/Widgets/SerialPort/PrintSupport`、`platforms/qwindows.dll` 和样式插件；MinGW 构建还要 `libstdc++-6.dll`、`libgcc_s_seh-1.dll`、`libwinpthread-1.dll`（`--compiler-runtime` 会带上）。少 `platforms` 目录，双击就报找不到平台插件。

**别编：** 没打过发布包就直说，编了会被「装完打不开是什么原因」问穿。

### Q14.44 new 出来的控件谁删？
**答：** 全挂到父对象上，父析构自动删：`new QTimer(this)`、`new SummaryStrip(ui->centerPanel)`、卡片 `new QFrame(ui->cardsHolder)`、按钮 `new QPushButton(..., ui->thresholdBox)`。`MainWindow` 本身是 `main()` 里的栈对象（`MainWindow w; w.show();`）。跨事件删控件用 `deleteLater()`，不能 delete 正在处理自己事件的控件。

### Q14.45 引脚怎么分配的？
**答：** 板1：USART1 PA9/PA10 接 CH340G 调试；USART2 PA2/PA3 是 RS485（与 ETH_MDIO 复用，二选一）；USART3 PB10/PB11 给 LoRa（占原 ESP8266 座）；I2C1 PB8/PB9 挂 4 个传感器；LCD 走 FSMC Bank1 NE4：CS PG12、RS PF12(A6)、WR PD5、RD PD4、背光 PB15。

板2：只初始化了两路串口——USART1（PA9/PA10，接 CH340，115200，调试、上位机、命令转发都在这路）和 USART3（PB10/PB11，ESP8266）；USART2 在代码里从没初始化，设计文档写的 USART2 与实际不符（见 Q3.4）；LoRa 走 USART6（PC6/PC7）。SPI1 PB3/PB4/PB5 挂 GD25Q128，片选 PB14。PB3/PB4 上电默认是 JTAG 的 JTDO/NJTRST，用 SPI1 前必须先关 JTAG。

**顺带一句：** 板1 的 I2C2 也在 PB10/PB11，和 LoRa 串口冲突，所以那一路没用。

### Q14.46 任务栈怎么定的？怎么验证？
**答：** 板1 六个任务按字算：sensor 640，process / comm / loraRx / ui 各 512，monitor 384，合计 3072 字 = 12KB；堆 30KB。大小按最坏路径估，monitor 要调 `printf`，就把打印频率降到 5 秒一次。

验证两层：`uxTaskGetStackHighWaterMark()` 每 5 秒打一次剩余最小栈（单位字，低于 30 就加）；`configCHECK_FOR_STACK_OVERFLOW=2` 在栈尾放魔数，切换时校验，踩了进钩子。设计文档的验收线是余量 >30%；具体实测数值我没归档，被问就如实说「按水位调的」。

### Q14.47 W25Q128 走哪路 SPI？JEDEC ID 是多少？
**答：** 板2 的 SPI1，10MHz，SCK PB3 / MISO PB4 / MOSI PB5，片选 PB14。板上实际焊的是 GD25Q128，JEDEC ID 是 **0xC84018**，不是 Winbond 的 0xEF4018；所以初始化只校验容量字节 0x18（128Mbit），写死 0xEF4018 会误判失败。

**加分：** SPI1 上还有 NRF24L01 插座 CN4，两个从机靠各自片选分时复用，驱动里有总线锁。

### 14.5 收尾

### Q14.48 如果只能记三个数字，记哪三个？
**答：** 20 字节帧、4 秒看门狗、32640 条 / 约 18 小时缓存。

### Q14.49 被问「这是跟教程做的吧」怎么答？
**答：** 不辩解，直接给只有做过才知道的细节：map 文件里弱符号被链接器删掉、I2C 死锁用 9 个时钟脉冲救回来、`setStyleSheet` 反复调用导致重绘变慢。三个细节讲完，真假自然清楚。（Q6.2）
