lmh666-yes/Second_Project_Demo/04_文档/架构与设计/README.md

# 精密仪器实验室环境监护系统

基于两块 STM32F407 开发板的分布式环境监测系统（综合设计项目）。

采集节点负责环境数据采集（温湿度、气压、光照、空气质量），经 LoRa 无线发送；边缘网关汇聚数据后转发至 Qt 上位机，并通过 ESP8266 + MQTT 上报巴法云。下位机基于 ST 标准外设库与 FreeRTOS（任务、队列、信号量）开发。

> 仓库根目录下只有 `EnvMonitor/` 一个目录（外加 `.gitignore`），本文件位于其中的 `EnvMonitor/项目架构思路设计参考/`。下面提到的路径都从仓库根目录写起；`项目进度.md`、`上板验证步骤.md`、`代码审查报告.md` 与本文件同目录。

> 进度跟踪与当前现状见 `项目进度.md`；逐条验收步骤见 `上板验证步骤.md`；历史代码审查结论见 `代码审查报告.md`。

## 系统构成

| 角色 | 硬件 | 软件 | 工程入口 |
|---|---|---|---|
| 采集节点（板1） | STM32F407ZE（GEC-M4） | 标准外设库 + FreeRTOS，4 个任务 | `EnvMonitor/Project_1_检测端/Project/标准模板.uvprojx` |
| 边缘网关（板2） | STM32F407ZG（普中-天马 F407） | 标准外设库 + FreeRTOS，5 个任务 | `EnvMonitor/Project_2_数据通信端/Project/000标准模板库.uvprojx` |
| 上位机 | PC | Qt 5（qmake + MinGW） | `EnvMonitor/QT_project/SerialMonitor/SerialMonitor.pro` |
| 云端 | 巴法云 | ESP8266 AT + MQTT | 板2 经 USART3 上行 |

数据链路：板1 采集 → 20 字节定长帧 → LoRa E22（433 MHz，9600）→ 板2 校验入库 → USART2（经 P6 跳线选 SP3232）→ USB-TTL → Qt 上位机；板2 另经 ESP8266 向巴法云上报。

## 通信协议要点

| 项 | 约定 |
|---|---|
| 帧格式 | `AA 55` + 命令 + 长度 + 数据 + CRC16-MODBUS + `55 AA`，共 20 字节（环境帧） |
| 命令分区 | `0x01` 环境帧上行；`0x10`~`0x16` 下行请求；`0x80`~`0xFF` 应答（应答 = 请求 \| 0x80） |
| 补传通路 | `0x16` 触发补传，`0x15` 回传历史帧（4 字节原始时间戳 + 20 字节原帧），`0x96` 回报进度 |
| 断网缓存 | W25Q128 专用 64 KB：16 扇区 × 128 槽 × 32 字节，共 2048 条；槽 = 序号 4 + 时间戳 4 + 长度 2 + CRC16 2 + 数据 20 |
| 三端一致 | 同一套帧格式在板1 组帧、板2 解帧、Qt 再解一遍，两端都有自检用例钉住 |

## 目录结构

| 目录 / 文件 | 内容 |
|---|---|
| `EnvMonitor/项目架构思路设计参考` | 设计文档、评审建议、采购清单、架构图，以及本文件、进度与验收文档 |
| `EnvMonitor/Project_1_检测端` | 采集节点 Keil 工程与设计文档 |
| `EnvMonitor/Project_2_数据通信端` | 边缘网关 Keil 工程与设计文档 |
| `EnvMonitor/QT_project` | Qt 上位机工程（串口通信 + 曲线显示 + CSV + 补传控制） |
| `EnvMonitor/项目架构思路设计参考/双版资源` | 两块板卡的外设与引脚资料（板1 实拍标注图、板2 原理图 PDF） |
| `EnvMonitor/项目架构思路设计参考/上板验证步骤.md` | 上板联调的分项步骤与判据 |
| `EnvMonitor/项目架构思路设计参考/代码审查报告.md` | 三轮代码审查的问题清单与修复记录 |
| `EnvMonitor/项目架构思路设计参考/项目进度.md` | 已完成 / 未完成 / 验证证据 / 下一步 |
| `本地工具/`（本机保留，不入库） | 巡检、验证、出图等工具脚本；`.gitignore` 已把根目录下 `EnvMonitor` 之外的内容全部忽略 |

## 关键文档

| 文档 | 内容 |
|---|---|
| `EnvMonitor/Project_1_检测端/检测数据端设计.md` | 采集端：传感器、引脚表、时间预算、协议、验收清单 |
| `EnvMonitor/Project_2_数据通信端/数据传输端设计.md` | 网关端：串口资源、任务划分、MQTT、W25Q128 缓存 |
| `EnvMonitor/QT_project/Qt上位机设计.md` | 上位机：帧解析、界面、CSV、阈值告警、一致性自检 |
| `EnvMonitor/项目架构思路设计参考/设计思路报告.md` | 面向组装与实机测试的总体设计说明 |
| `EnvMonitor/项目架构思路设计参考/断网缓存补传设计.md` | 补传方案与实现记录（含与方案不同的地方） |
| `EnvMonitor/项目架构思路设计参考/程序模块与改动清单.md` | 本稿改动落在哪些文件、模板 `main.c` 怎么复用 |
| `EnvMonitor/项目架构思路设计参考/外设采购清单.md` | 采购分阶段、驱动就绪状态表 |
| `EnvMonitor/项目架构思路设计参考/架构图修订说明.md` | 两张图与代码实测的差异对照、出图命令 |

## 编译与验证

```powershell
# 两板 Keil 复编 + Qt 构建与三项自检 + 文风检查
powershell -ExecutionPolicy Bypass -File 本地工具\仓库巡检\最终验证.ps1

# 只跑 Qt 侧（-SkipKeil 跳过 Keil，-SkipStyle 跳过文风检查）
powershell -ExecutionPolicy Bypass -File 本地工具\仓库巡检\最终验证.ps1 -SkipKeil -SkipStyle
```

两个 Keil 工程需在 `Options for Target -> C/C++ -> Define` 里带 `SYS_TEST_BOARD=1`（板1）或 `=2`（板2），漏填会编译报错提示。

巡检与辅助脚本（均在 `本地工具/仓库巡检/`）：`project_check.ps1` 生成内容检查报告，`pin_audit.py` 扫描引脚冲突，`改动分类.py` 区分代码改动与注释改动，`文风检查.ps1` 统计说明文字的 AI 腔特征。

> 这些脚本放在开发机的 `本地工具/` 下，不随仓库上传（仓库里只有 `EnvMonitor/` 的源码与文档）；换一台机器要跑验证，得把 `本地工具/` 一起拷过去。

## 当前状态（2026-10-10）

- 两板固件、Qt 上位机、设计文档与验证脚本均已就绪；两板 Keil 编译 0 Error 0 Warning，Qt 三项自检全通过。
- 硬件尚未组装：板上目前只有 DHT11 提供实测值，气压、光照、TVOC、MQ-135 四项在帧里恒填 0，待传感器到货后接入。
- 详细进度、验证证据与待办清单见 `项目进度.md`。
