lmh666-yes/Second_Project_Demo/05_硬件资料/说明.md

# 项目外设资料（索引）

本目录是**工程用到的外设原始资料**，从厂商资料包里整理而来。
整理原则：**留数据手册 / 应用笔记 / 用户手册 / 原理图 / 尺寸图**，
**删掉与本工程无关的内容**（其他 MCU 平台的例程、商城链接、商品图、重复文件）。

> 整理前的完整原始包备份在 `%TEMP%\项目外设资料_备份_20261015\`（348 个文件 / 53.1 MB），
> 确认无误后可自行删除。

## 目录与对应关系

| 资料目录 | 器件 | 速查里的手册卡 | 工程里的驱动 / 引用 |
|---|---|---|---|
| `LoRa-E22/` | E22-400T22D 无线模块（工程采购型号 E22-400T22S，AT 固件） | 板1 阶段 7「LoRa 发送」/ 板2 阶段 4「LoRa 接收」 | `lora_e22.c/h`（两板都有） |
| `SHT30/` | Sensirion 温湿度 | 「SHT30 温湿度传感器」 | `sys_i2c.h` 地址 `0x44`（**外接，非本工程主用**） |
| `BMP280-BME280/` | 博世气压 | 「BMP280 气压传感器」 | `sys_bmp280.c/h`（两板都有） |
| `BH1750/` | 罗姆数字光照 | 「BH1750 光照传感器」 | `sys_bh1750.c/h`（两板都有） |
| `CCS811/` | AMS 空气质量（TVOC/eCO₂） | 「CCS811 空气质量传感器」 | `sys_ccs811.c/h`（两板都有） |
| `MQ-135/` | 半导体空气质量（模拟量） | 「MQ-135 空气质量传感器」 | 帧协议 `sys_frame.h` 内 `[10] MQ135 原始 ADC`，经 `sys_adc` 采集（板1 PF7 = ADC3_IN5，宏 `SYS_ADC_MQ135_*`） |

## 各目录里有什么

```
项目外设资料/
├── LoRa-E22/
│   └── E22-400T22D 规格书.PDF            ← 寄存器指令（C0/C1/C2）、频段、功率、分包；无 AT 指令章节
├── SHT30/                                 ← Sensirion 官方整套
│   ├── 产品手册/                           SHT3x 数据手册（数字型）
│   ├── 主要文档/                           Alert Mode 应用笔记
│   ├── 科学支持/                           湿度设计指南、测试指南、焊接与封装处理等 9 份
│   ├── 参考代码/                           官方示例代码 + Arduino / 树莓派 库
│   ├── 3系保护壳/                          Datasheet 保护盖图纸
│   └── CAD模型/                            SHT3x 的 STEP 模型
├── BMP280-BME280/
│   ├── BST-BME280_DS001-10 数据手册.pdf    ← 含校准系数与补偿公式（必读）
│   ├── gy-bmp280 模块说明.pdf
│   ├── BME280 原理图.jpg
│   ├── 尺寸图.png
│   └── ARDUINO示例代码/                     Adafruit 库（补偿算法参考）
├── BH1750/
│   ├── BH1750FVI 数据手册.pdf              ← 量程、分辨率、测量时间
│   ├── GY-302 原理图.jpg
│   └── GY-302 尺寸.JPG
├── CCS811/                                ← AMS 官方 8 份
│   ├── CC-000619-DS-7-CCS811 数据手册.pdf   ← 寄存器与 ALG_RESULT_DATA 格式
│   ├── CC-000803-AN-5-编程与接口指南.pdf    ← 上电时序、模式切换（必读）
│   ├── CC-000921-AN-2-洁净空气基线保存与恢复.pdf
│   ├── CC-000922-AN-2-应用代码二进制文件下载.pdf
│   ├── CC-000751-UG-2-CCS_EVK04 评估板用户指南.pdf
│   ├── CC-000774-AN-2-焊接装配指南.pdf
│   ├── CC-000783-AN-1-机械设计注意事项.pdf
│   └── CC-000840-AN-1-手工焊接方法.pdf
└── MQ-135/
    ├── MQ135 数据手册.doc                  ← 灵敏度曲线、R0 标定（扫描图无文本层；图3 与图4 的 R0 定义不一致）
    ├── MQ-2 数据手册.pdf
    ├── MQ-2 产品使用手册.doc
    ├── MQ 转直插圆板焊接说明.pdf
    └── 其他型号（工程未用）/                 MQ-2~MQ-9 的资料，留作同系列参考
```

## 整理时删掉了什么

| 删除内容 | 说明 |
|---|---|
| 其他 MCU 平台的例程 | 8051（Keil C51，`.A51/.Uv2/.OBJ/.HEX`）、AVR（AVRMEGA16）、STC51、C8051F340、Proteus 仿真（`.DSN/.PWI/.DBK`）、STM32F103 测试工程（`CJMCU_811-测试代码`，21 MB） |
| 商城链接 | `欣薇商城.url` 之类 |
| 商品图 | `封面图.jpg`、`实物图.png` |
| 重复文件 | `xxx(1).pdf`、`xxx[6].pdf` 这类浏览器下载副产物；以及 BME280 那个自己套自己的同名目录 |

> 判断依据是**工程实际用什么**：本工程是 STM32F407 + 标准外设库，
> 上面那些例程要么是别的芯片架构，要么是别的开发环境，照抄不了，留着只会干扰查找。
> 数据手册 / 应用笔记一律保留——那些是跨平台通用的。
