lmh666-yes/Second_Project_Demo/04_文档/问题与分析/视频拍摄脚本.md

# 项目演示视频 · 拍摄脚本与整理清单

> 用途：简历附链接 / 面试发送 / 作品集
> 目标时长：**4~5 分钟**（超过 6 分钟面试官不会看完）

---

## 一、拍摄前：先把“乱”分成三类

| 类别 | 具体问题 | 处理方式 |
|---|---|---|
| **台面乱** | 杜邦线像蜘蛛网、模块东倒西歪 | 见第二节，30~60 分钟能搞定 |
| **界面乱** | 串口助手刷屏、桌面图标多 | 只留必要窗口，全屏，深色主题 |
| **节奏乱** | 现场临时找代码、找按钮 | 提前彩排 2 遍，写好操作顺序 |

---

## 二、物理整理（优先级从高到低）

### 1. 供电先理清（最重要）
- 板2 用 **DC 5V 独立供电**，板1 可用 USB
- **大电流器件单独走线**：LoRa、ESP8266 的电源线不要和传感器共用一根细线
- 每个模块电源脚就近并 **0.1µF**，总线加 **100µF**

### 2. 线束收拢
- 用**扎带**把同方向的线捆成一束，不要交叉
- 线长宁短勿长，多余的线盘起来扎住
- **颜色规范**：红 = 电源，黑 = 地，黄/绿 = 信号
- 没有彩色线就用**标签纸**写：`3V3`、`GND`、`TX`、`RX`

### 3. 模块固定
- 双面胶 / 电工胶带 / 亚克力板 / 洞洞板，**别让模块悬空**
- 屏幕、板子、模块按“检测端在左、网关在右”摆
- **LoRa 天线朝上**，远离金属和人体

### 4. 布景
- 桌面铺深色布或一张白纸当背景
- 光源在**侧前方**（台灯），别用顶灯直射（会反光）
- 手机/相机用三脚架或支架固定，**俯拍 45°**

---

## 三、分镜脚本（4~5 分钟）

| 时间 | 画面 | 内容要点 | 注意事项 |
|---|---|---|---|
| 0:00–0:15 | 全景：两块板 + 屏 + 电脑同框 | 一句话介绍：“这是一个双板环境监测系统，检测端采集，网关端上云” | 屏幕要先点亮 |
| 0:15–0:50 | 系统框图（画中画或截图） | 讲清四段链路：传感器 → 板1 → LoRa → 板2 → WiFi → 云 → Qt | 提前做好框图图片 |
| 0:50–1:40 | 板1 特写 | 手点传感器，讲“SHT30 温湿度、BMP280 气压、BH1750 光照、CCS811 空气质量”；屏幕/串口显示数值变化 | 数值要**在动** |
| 1:40–2:30 | 板2 屏幕特写 | 讲网关做什么：接收、显示、缓存、上云；指屏幕上的 ONLINE 和数值 | 数据要能刷新 |
| 2:30–3:20 | 电脑：Qt 上位机 | 实时曲线、告警、统计；点“查询板2状态”演示下行命令 | 先关串口助手，避免占用 |
| 3:20–4:10 | **亮点：断网补传** | 拔掉热点 → 说“现在数据落到 Flash” → 恢复 → “自动补传” | 这是最加分的一段 |
| 4:10–4:40 | 串口日志 / 代码片段 | 展示 `[MON]` 统计、帧结构 `AA 55 01 0C ...` | 字号放大到能看清 |
| 4:40–5:00 | 收尾 | 一句话总结技术点 + “完整代码和文档在 GitHub” | 别拖 |

---

## 四、物料清单

**硬件**
- 板1、板2、传感器模块、LoRa × 2、ESP8266、TFT 屏、DC 电源
- 扎带、双面胶、标签纸、彩色杜邦线

**软件/素材**
- 系统框图（PNG）
- 协议帧结构图
- 串口日志截图（已缩放到可读）
- Qt 界面截图
- 屏幕录制工具（OBS / Windows 自带 Xbox Game Bar）

---

## 五、拍摄前检查表

- [ ] 两块板都上电，屏幕正常显示
- [ ] Qt 能连上 COM 口，曲线在动
- [ ] 手机热点已开，板2 显示 `Net: ONLINE`
- [ ] 串口助手已关闭（避免占用 COM）
- [ ] 桌面清空，只留设备
- [ ] 手机支架/三脚架就位
- [ ] **先彩排一遍**，记住操作顺序

---

## 六、常见翻车点

| 风险 | 预防 |
|---|---|
| 拍到一半屏幕黑了 | 提前确认 LCD 上电复位（断电重上再开拍） |
| 数据不动 | 板1 的 I2C 若卡死，先断电重启再拍 |
| Qt 打不开串口 | 关掉串口助手 |
| 断网演示失败 | 先手动试一次，确认 `cache` 会涨 |
| 视频太长 | 每段拍完立刻停，后期剪，不要一镜到底 |
| 声音听不清 | 用手机外接麦，或在安静房间录旁白后期配 |

---

## 七、后期

- 剪掉等待和找东西的片段，**节奏要快**
- 关键画面加**字幕**（面试官可能静音看）
- 开头 5 秒放最有画面感的一帧（屏亮 + 曲线在动）
- 导出 1080p，控制在 200MB 以内，方便发送
