lmh666-yes/Second_Project_Demo/05_硬件资料/MQ-135/其他型号（工程未用）/MQ-2更新.docx

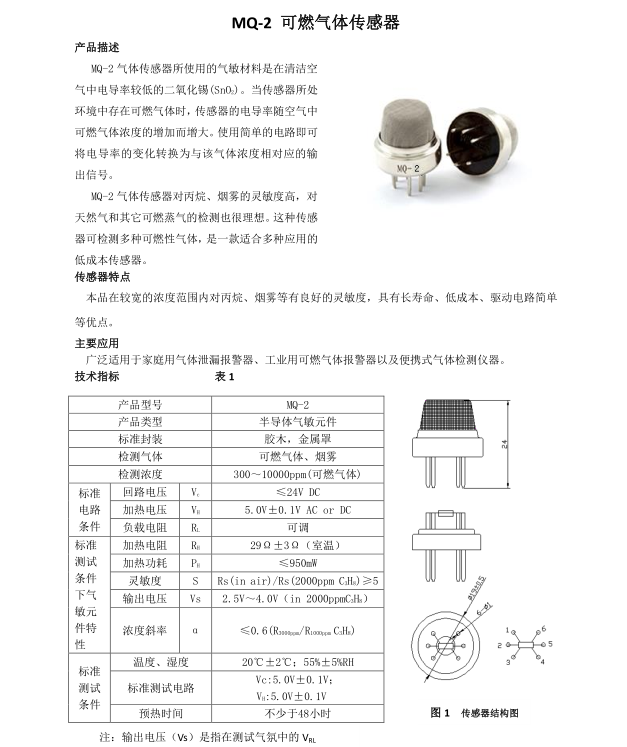
[picture p2: figure]
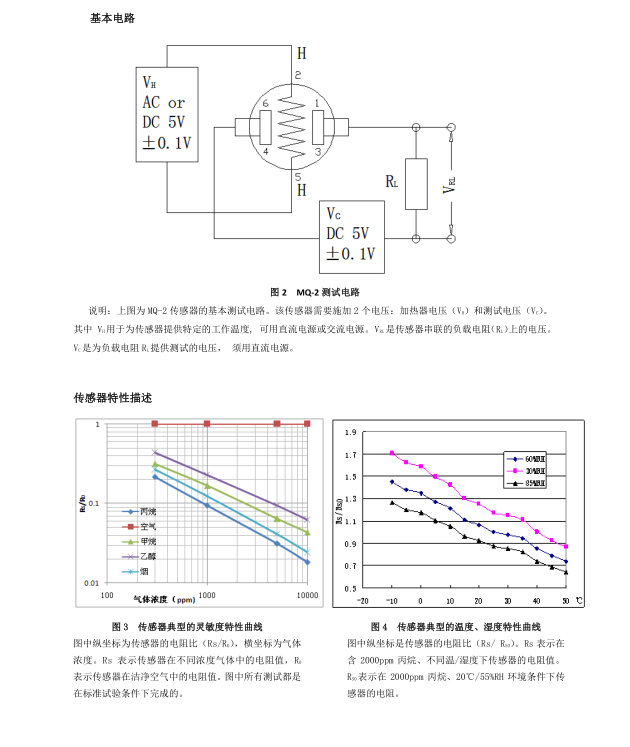
[picture p3: figure]
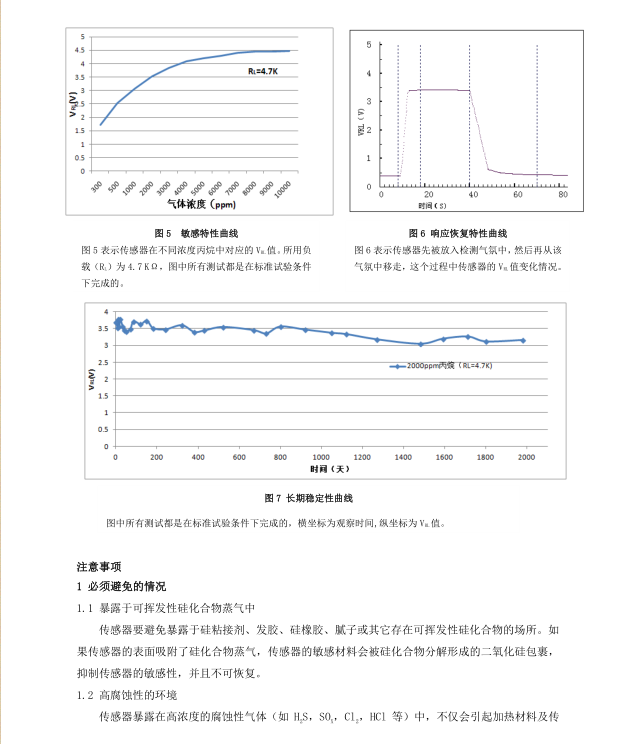
[picture p4: figure]
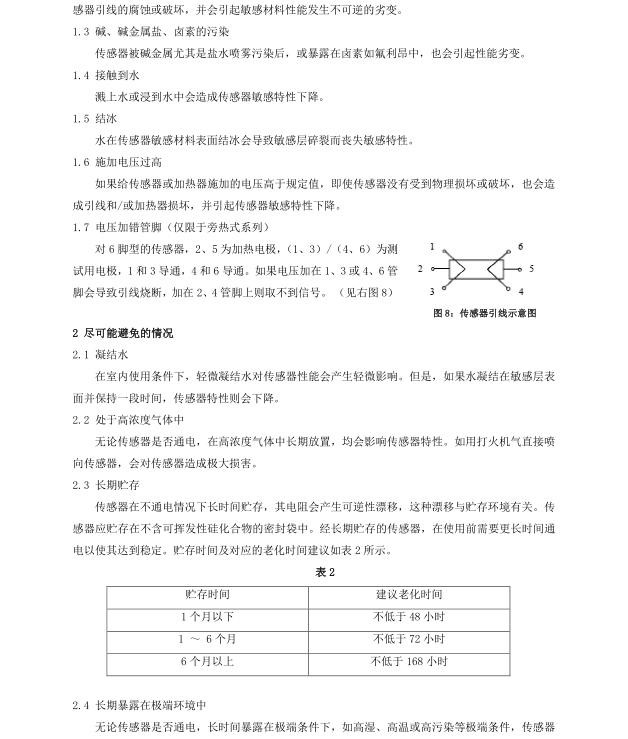
[picture p5: figure]
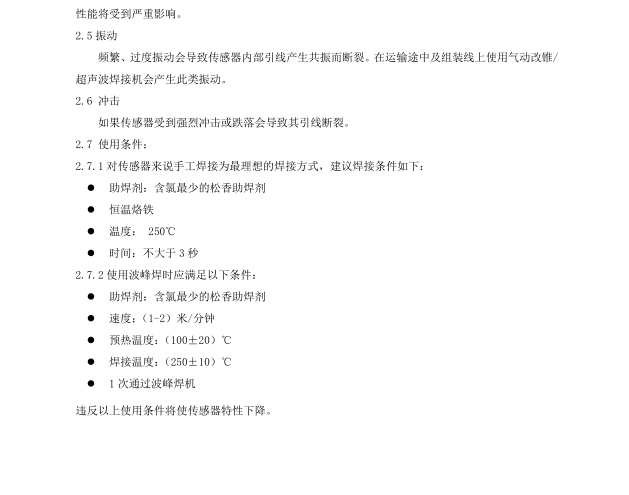
[picture p6: figure]
