lmh666-yes/Second_Project_Demo/04_文档/问题与分析/Qt界面_五路汇总.png

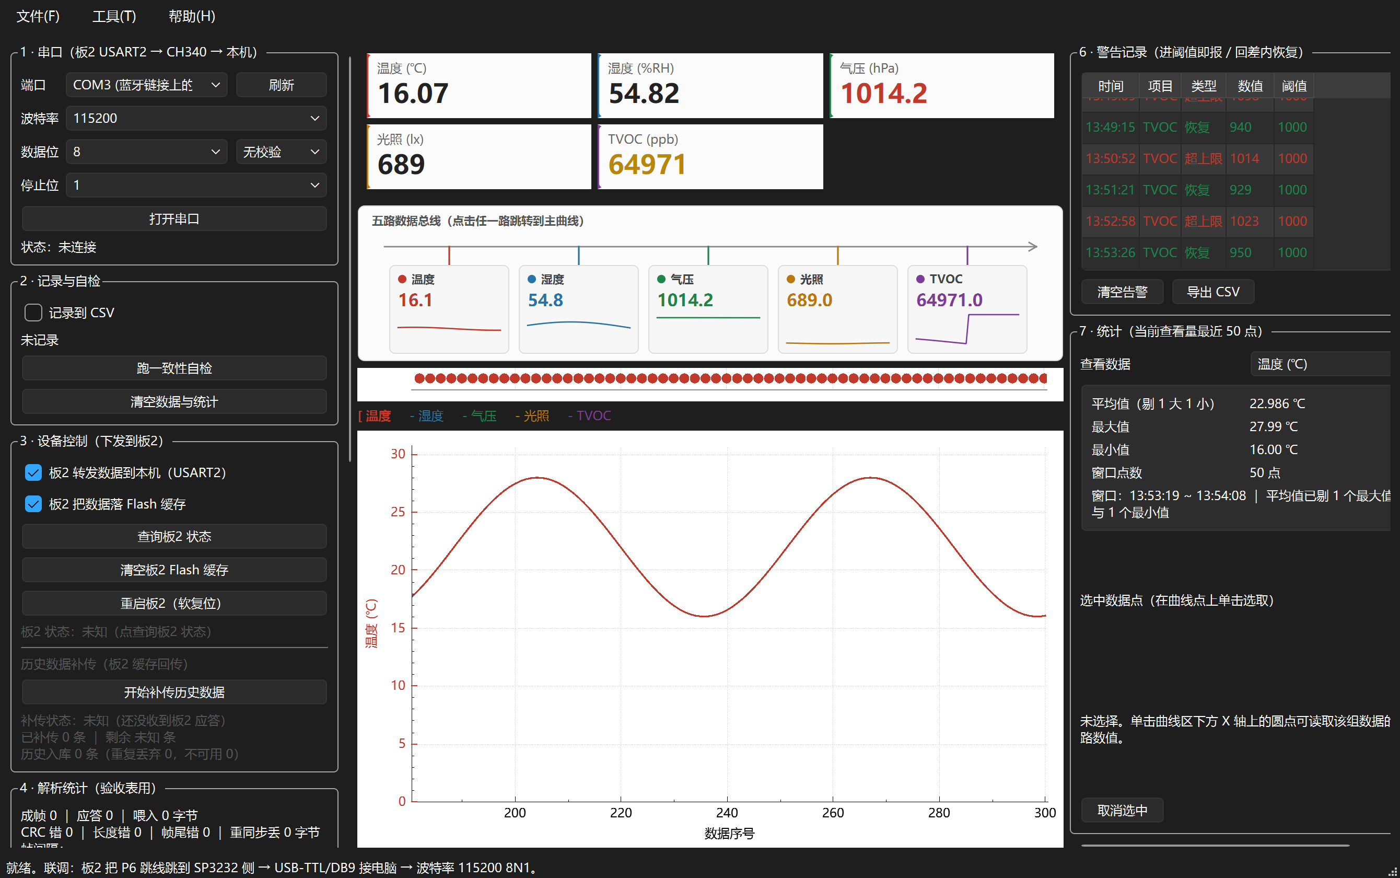
04_文档/问题与分析/Qt界面_五路汇总.png
