lmh666-yes/Second_Project_Demo/04_文档/问题与分析/系统框图.png

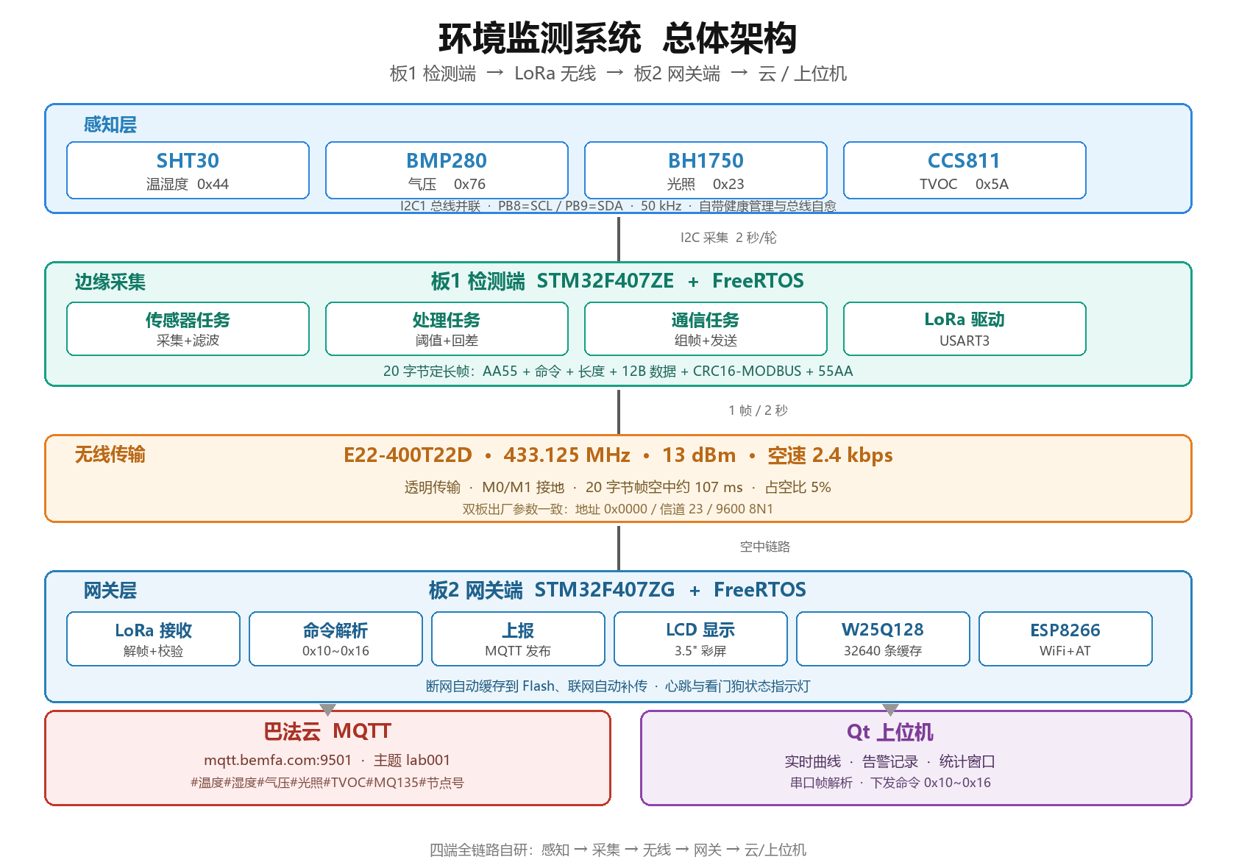
04_文档/问题与分析/系统框图.png
