lmh666-yes/Second_Project_Demo/05_硬件资料/BMP280-BME280/尺寸图.png

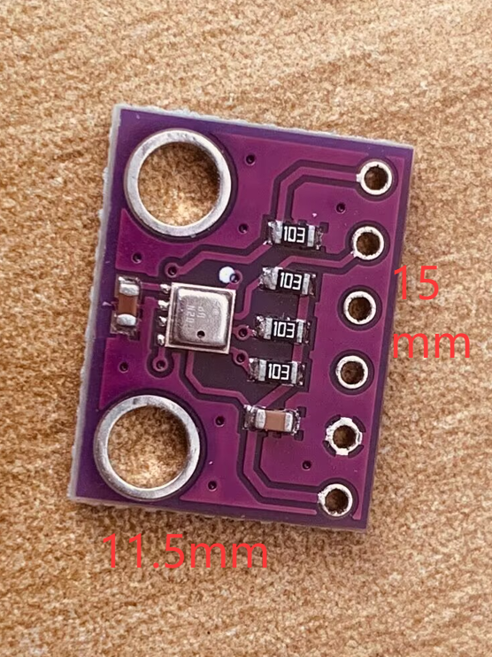
05_硬件资料/BMP280-BME280/尺寸图.png
