lmh666-yes/Second_Project_Demo/01_检测端_STM32F407/Project/改动清单.md

# 改动清单 —— 库内"模式/选项一律用标准库宏名"清扫

> 日期 : 2026-09-22
> 工程 : `0001_标准模板库`（只改本工程）
> 范围 : 整个模板库的注释/文档/示例，另有 1 处等值调用；共约 85 处、28 个文件
> 结果 : 编译 0 Error / 0 Warning（build_keil.bat 验证）

规则（改写依据）：
凡"模式 / 选项 / 状态位 / 触发沿 / 上下拉 / 方向"这类可选择的值，文字中必须写标准库宏名（与 `stm32f4xx_xxx.h` 中的名字一致），寄存器位编码只能跟在宏名后作对照。

例外（保留数字/编码，不改）：
- LED / KEY 的数字 id（用户明确豁免）
- 设备固有值：LCD 命令码、器件寄存器码、滤波强度 0x0~0xF、波特率、周期数
- 返回码 0 / -1 / -2；极性开关 ACTIVE_LOW 0/1（无对应库宏）

---

## 一、通用对照表（移植时按"原写法 → 新写法"查找替换）

| # | 原写法（数字/位编码描述） | 新写法（标准库宏名） | 出现位置 |
|---|---|---|---|
| 1 | `00 输入 / 01 输出 / 10 复用 / 11 模拟` | `GPIO_Mode_IN / GPIO_Mode_OUT / GPIO_Mode_AF / GPIO_Mode_AN` | gpio_core.h 附录 |
| 2 | `0 推挽 / 1 开漏` | `GPIO_OType_PP / GPIO_OType_OD` | gpio_core.h 附录 |
| 3 | `00/01/10/11 = 2/25/50/100MHz` | `GPIO_Speed_2MHz / _25MHz / _50MHz / _100MHz` | gpio_core.h 附录 |
| 4 | `00 无 / 01 上拉 / 10 下拉` | `GPIO_PuPd_NOPULL / GPIO_PuPd_UP / GPIO_PuPd_DOWN` | gpio_core.h 附录 |
| 5 | `pull : 0=无上下拉 1=上拉 2=下拉` | `GPIO_PuPd_NOPULL = 0 / GPIO_PuPd_UP = 1 / GPIO_PuPd_DOWN = 2` | gpio_core.h、key.h、ext_io.h、README |
| 6 | `推挽输出 / 开漏输出 / 复用推挽 / 复用输入+上拉` | 后面补 `(GPIO_OType_PP)` / `(GPIO_OType_OD)` / `(GPIO_Mode_AF + GPIO_OType_PP)` / `(GPIO_Mode_AF + GPIO_PuPd_UP)` | 全库多文件 |
| 7 | ETR `模式2（库默认）/ 模式1`（含笔误 `TS=ERF`） | `TIM_ETRClockMode2Config（默认）/ TIM_ETRClockMode1Config`;`TS=ETRF` | sys_tim.h/.c、README |
| 8 | `PWM1 模式`、`冻结/强置高/强置低/翻转/PWM1/PWM2` | `TIM_OCMode_PWM1`;`TIM_OCMode_Timing / _Active / _Inactive / _Toggle / _PWM1 / _PWM2` | sys_tim.h/.c、README |
| 9 | 捕获 `直连 / 不分频`、`DirectTI / IndirectTI / TRC` | `TIM_ICSelection_DirectTI / TIM_ICPSC_DIV1`;`TIM_ICSelection_DirectTI / _IndirectTI / _TRC` | sys_tim.h |
| 10 | USART `8 位字长 / 无校验 / 停止位`、`TXE/RXNE/TC/IDLE`、`UE/收发开关/RXNE 中断`、`DMA 收发请求` | `USART_WordLength_8b / USART_Parity_No / USART_StopBits_1`;`USART_FLAG_TXE/_RXNE/_TC/_IDLE`;`USART_CR1_UE / _RE、_TE / _RXNEIE`;`USART_DMAReq_Tx / _Rx` | sys_usart.h、README |
| 11 | I2C `PE 使能/START/ACK/软复位`、`SB/ADDR/AF/BTF`、`BUSY/MSL` | `I2C_CR1_PE / _START / _ACK / _SWRST`;`I2C_SR1_SB / _ADDR / _AF / _BTF`;`I2C_SR2_BUSY / _MSL` | sys_i2c.h |
| 12 | SPI `CPOL=0,CPHA=0`…、`主机模式/速率分频`、`TXE/RXNE/BSY` | `SPI_CPOL_Low/_High + SPI_CPHA_1Edge/_2Edge`;`SPI_Mode_Master / SPI_BaudRatePrescaler_2~256`;`SPI_I2S_FLAG_TXE / _RXNE / _BSY` | sys_spi.h/.c |
| 13 | ADC `位 1 EOC`、`ADON/SWSTART/CONTINUOUS/CAL/DMA`、`84MHz÷4`、`单次/连续转换` | `ADC_FLAG_EOC`;`ADC_CR2_ADON / _SWSTART / _CONT / _CAL / _DMA`;`ADC_Prescaler_Div4`;`ADC_ContinuousConvMode = DISABLE / ENABLE` | sys_adc.h、README |
| 14 | DMA `1=字节/2=半字`、`0=单次/1=循环`、`方向` | `DMA_PeripheralDataSize_Byte / _HalfWord`（内存侧同理）;`DMA_Mode_Normal / _Circular`;`DMA_DIR_PeripheralToMemory / _MemoryToPeripheral` | sys_dma.h、sys_adc.h、README |
| 15 | `分组 2 / 分组 4` | `NVIC_PriorityGroup_2 / NVIC_PriorityGroup_4` | sys_nvic / sys_usart / sys_tim / sys_exti / sys_dma 五个 .h |
| 16 | EXTI `上升沿/下降沿/双边沿` | `EXTI_Trigger_Rising / _Falling / _Rising_Falling` | sys_exti.h |
| 17 | `RCC_SYSCLK_Div1/2/4/…/512`、`RCC_HCLK_Div1/2/4/8/16`（缩写） | 全名逐个写:`RCC_SYSCLK_Div1 / _Div2 / … / _Div512`、`RCC_HCLK_Div1 / … / _Div16` | sys_clock.h |
| 18 | `PWR_WakeUpPinCmd` | `PWR_WakeUpPinCmd(ENABLE / DISABLE)`（本 DFP 单参数版，PA0 固定为 WKUP;完整版写法含 `PWR_WakeUpPin_1`） | sys_pwr.h |
| 19 | 时钟/ADC 等 `84MHz÷4 = 21MHz` 纯数字注法 | 宏名在前、数字在后作说明（如 `ADC_Prescaler_Div4 → 84MHz÷4 = 21MHz`） | sys_adc.h 等 |

---

## 二、逐文件改动明细（移植前逐项核对）

| 文件 | 改动点 |
|---|---|
| `FWLIB/inc/gpio_core.h` | 1) 文件头 `推挽/开漏输出` 补 `GPIO_OType_PP / _OD`;2) `OutInit / OutInitOD` 头注释改 `GPIO_OType_PP(_OD) / GPIO_Speed_100MHz / GPIO_PuPd_NOPULL`;3) `GPIO_InInit` 参数表 + 2 个示例改 `GPIO_PuPd_NOPULL / _UP / _DOWN`;4) `需要开漏输出` 处补 `GPIO_OType_OD`、"线与"句补 `GPIO_OType_OD + GPIO_PuPd_UP`;5) 附录 MODER/OTYPER/OSPEEDR/PUPDR 四行全宏名化（对照表 1~4，寄存器编码保留作对照） |
| `FWLIB/inc/gpio_core.h`（位带节，同日追加） | 参考教程 `sys.h` 升级：`GPIO_BASE_NUM` 端口链扩到 A ~ I（全程 `GPIOx_BASE` 标准库宏运算）;51 风格宏补齐 PHout/PHin/PIout/PIin（共 18 个，与教程覆盖一致）;新增"与教程 sys.h 对照"说明块（`PAout(n) = BIT_ADDR(GPIOA_ODR_Addr, n)` ↔ `GPIO_BB_OUT(GPIOA, n)`，公式完全一致） |
| `FWLIB/src/gpio_core.c` | 两段函数头注释：`推挽输出初始化(GPIO_OType_PP)` / `开漏输出初始化(GPIO_OType_OD)` |
| `FWLIB/inc/led.h`、`led.c` | 未动（用户豁免） |
| `FWLIB/inc/key.h` | `KEY_PULL` 注释：`0 = GPIO_PuPd_NOPULL, 1 = GPIO_PuPd_UP, 2 = GPIO_PuPd_DOWN`（数字 id 保留） |
| `FWLIB/inc/ext_io.h` | `EXT_BASE_PULL` 注释同上标注 |
| `FWLIB/inc/beep.h`、`src/beep.c` | 推挽描述补 `(GPIO_OType_PP)` |
| `FWLIB/inc/sys_tim.h` | 1) PwmInit 调用链④ → `PWM1 模式(TIM_OCMode_PWM1)`;2) CaptureInit 调用链④ → `TIM_ICSelection_DirectTI / TIM_ICPSC_DIV1`;3) 各调用链引脚描述补 `GPIO_Mode_AF + GPIO_OType_PP / GPIO_PuPd_UP`;4) ETR 区块 1 注释：模式1/2 → `TIM_ETRClockMode2Config（默认）/ TIM_ETRClockMode1Config`（并修正笔误 `TS=ERF`→`TS=ETRF`）;5) OC 原理句/总结句 → `TIM_OCMode_*` 六模式;6) ICInit 附录 → `TIM_ICSelection_DirectTI / _IndirectTI / _TRC`;7) 4 处"分组" → `NVIC_PriorityGroup_2 / _4` |
| `FWLIB/src/sys_tim.c` | 注释 4 处：PWM1→`(宏 TIM_OCMode_PWM1)`、ETR→Mode1/2Config 名、复用推挽→`(GPIO_OType_PP)` ×2 |
| `FWLIB/inc/sys_usart.h` | 1) 调用链③ → `8 位字长(USART_WordLength_8b) / 无校验(USART_Parity_No)`;2) 附录 SR → `USART_FLAG_*`、CR1 → `USART_CR1_UE/_RE、_TE/_RXNEIE + WordLength_8b`、CR2 → `USART_StopBits_1`、CR3 → `USART_DMAReq_Tx / _Rx`;3) 文件头引脚行补 `GPIO_Mode_AF / GPIO_OType_PP / GPIO_PuPd_UP`;4) 2 处"分组" → `NVIC_PriorityGroup_2 / _4` |
| `FWLIB/src/sys_usart.c` | 引脚复用注释：`TX=复用推挽(GPIO_Mode_AF+GPIO_OType_PP) / RX=复用输入+上拉(GPIO_PuPd_UP)` |
| `FWLIB/inc/sys_i2c.h` | 1) Init 注释：`引脚(复用开漏 GPIO_OType_OD)`;2) 附录 CR1/SR1/SR2 全套 `I2C_CR1_* / I2C_SR1_* / I2C_SR2_*`（对照表 11） |
| `FWLIB/src/sys_i2c.c` | 初始化注释、电气说明段、BusReset 注释补 `GPIO_Mode_AF / GPIO_OType_OD / GPIO_PuPd_UP` |
| `FWLIB/inc/sys_spi.h` | 1) 时钟模式枚举 4 行 → `SPI_CPOL_Low/_High + SPI_CPHA_1Edge/_2Edge`;2) 调用链④ → `全双工主机(SPI_Direction_2Lines_FullDuplex)`;3) 附录 CR1 → `SPI_Mode_Master / SPI_BaudRatePrescaler_2~256`、SR → `SPI_I2S_FLAG_TXE/_RXNE/_BSY` |
| `FWLIB/src/sys_spi.c` | 引脚复用注释：`SCK/MOSI (GPIO_OType_PP) / MISO (GPIO_PuPd_UP)` |
| `FWLIB/inc/sys_adc.h` | 1) 附录 SR→`ADC_FLAG_EOC`、CR2→`ADC_CR2_ADON/_SWSTART/_CONT/_DMA`（`ADC_CR2_CAL` 本 DFP 未定义，库内 .c 已补）、CCR→`ADC_Prescaler_Div4`;2) DmaInit/DmaScanInit 注释 → `DMA_Mode_Circular`;3) Init/ContInit 头注释 → `ADC_ContinuousConvMode = DISABLE / ENABLE` |
| `FWLIB/inc/sys_dma.h` | 1) 参数表：`item_size` → `DMA_*DataSize_Byte/_HalfWord`、`circular` → `DMA_Mode_Normal/_Circular`;2) 调用链③ → `方向(DMA_DIR_PeripheralToMemory / _MemoryToPeripheral)`;3) 附录 CR → `DMA_DIR_* / DMA_Mode_*`;4) 2 处"分组" → `NVIC_PriorityGroup_2 / _4` |
| `FWLIB/inc/sys_exti.h` | 1) 文件头触发方式行 + 枚举 3 条 → `EXTI_Trigger_Rising / _Falling / _Rising_Falling`;2) 2 处"分组" → `NVIC_PriorityGroup_2 / _4` |
| `FWLIB/inc/sys_nvic.h` | 3 处"分组 2/分组 4"表述 → `NVIC_PriorityGroup_2 / _4`（表内原为宏名） |
| `FWLIB/inc/sys_clock.h` | SetBusDiv 参数表：分频常量全名化（`RCC_SYSCLK_Div1 ~ _Div512`、`RCC_HCLK_Div1 ~ _Div16`） |
| `FWLIB/inc/sys_pwr.h` | `SetWakeupPin` 注释 → `PWR_WakeUpPinCmd(ENABLE/DISABLE)`（本 DFP 裁剪版为单参数、PA0 固定为 WKUP;完整版写法含 `PWR_WakeUpPin_1`） |
| `FWLIB/src/sys_dht11.c` | 本批唯一的代码改动（等值）：3 处 `GPIO_InInit(…, 1)` → `GPIO_InInit(…, GPIO_PuPd_UP)`（`1 == GPIO_PuPd_UP`，行为不变）;2 处注释补 `(GPIO_OType_OD)` |
| `FWLIB/inc/sys_rs485.h`、`src/sys_rs485.c` | 方向脚描述补 `(GPIO_OType_PP)` |
| `FWLIB/src/sys_eth.c` | 引脚描述补 `(GPIO_OType_PP)` |
| `FWLIB/src/lcd.c` | 背光注释补 `(GPIO_OType_PP)` |
| 其余模块（sys_wdg / sys_flash / sys_tick / sys_fault / sys_frame / sys_str / sys_oled / sys_mpu6050 / sys_modbus / sys_eth.h / sys_dht11.h …） | 检查结论：无需改。已是宏名，或属设备固有值（寄存器码/协议码/滤波强度/返回码），按例外保留 |

---

## 三、附加文件改动

| 文件 | 改动 |
|---|---|
| `README.md`（工程根，13 处） | GPIO Out/In 行、USART `8N1` 行、OC 六模式行、PWM 预设句、ETR "填 1/2" 句、DMA `item/circular` 行、ADC `DmaInit` 行、ADC 单次/连续两行、I2C 行、KEY 行 → 全部补宏名（对照表 5~14、17） |
| `FreeRTOS/port/FreeRTOSConfig.h` | `configPRIO_BITS 4` 补注释"即 CMSIS 宏 `__NVIC_PRIO_BITS`";中断优先级段落原已使用 `NVIC_PriorityGroup_4` |
| `FreeRTOS/` 其余 | 内核源码（`src/` `inc/` `port.c` `portmacro.h`）保持官方原样（本工程约定：升级直接替换）;钩子/README 已规范 |
| `ETH/inc/stm32f4x7_eth.h` | 顶部"阅读导语"块：`ETH_InitTypeDef` 字段补 `ETH_Mode_FullDuplex / _HalfDuplex`、`ETH_Speed_10M / _100M`、`ETH_AutoNegotiation_Enable`、`ETH_ChecksumOffload_Enable` |
| `ETH/port/stm32f4x7_eth_conf.h`、`ETH/README.md` | 无需改（LAN8720 寄存器位值 0x1F/0x04/0x10 属设备固有值） |
| `RTE/**` | 无改动。全部为 ST/Keil 官方自动生成文件（`stm32f4xx_conf.h`、`RTE_Device.h`、`RTE_Components.h`、startup、system），无中文模式描述、无 SPL 宏可映射项;且由 Keil 工具管理，不建议手改 |

> 核验记录（同日追加）：库内引用的 110 个标准库宏名已逐一在 DFP/CMSIS 头文件里核实（脚本遍历全包）。
> 4 个首轮未通过，已按实际 DFP 修正：
> 1) `DMA_DIR_PeripheralSRC/DST` 是 F1 的名字 → F4 真名 `DMA_DIR_PeripheralToMemory / _MemoryToPeripheral`；
> 2) `PWR_WakeUpPin_1` 在本 DFP 裁剪版不存在（函数为单参数 `PWR_WakeUpPinCmd(ENABLE/DISABLE)`）→ 文档已改成实际写法并注明完整版差异；
> 3) `ADC_CR2_CAL` 本 DFP 未定义（`ADC_CR2_*` 都在 CMSIS `stm32f4xx.h` 里定义，仅缺 CAL）→ `sys_adc.h` 已注明"库内 .c 已 `#ifndef` 补定义"。

---

## 四、移植到其他工程的方法

1. 本批改动里只有 1 处是代码，且数值等值：`sys_dht11.c` 的 3 处 `GPIO_InInit(…, 1)` → `GPIO_InInit(…, GPIO_PuPd_UP)`。其余全部是注释/文档，照抄不会改变编译行为。
2. 做法（不改引脚配置）：在目标工程里按第一节对照表逐项查找替换 → 再按第二节明细表逐文件核对 → 编译验证。
   （直接把本工程 `FWLIB` 整个覆盖过去也可行，但目标工程"区块 1"的引脚/数量宏可能不同，覆盖前先核对。）
3. 目标工程如果也有 `README.md` / `FreeRTOS` / `ETH` 目录，按第三节同步。
4. 编译验证标准：build_keil.bat → `0 Error(s), 0 Warning(s)`。

---

## 附录：看门狗模块升级（2026-09-27，联动配置）

> 按"看门狗练习"的思路升级，移植时连带 `sys_wdg.h / sys_wdg.c`（+ 根 README 5.20 段落）。

| 新增 | 说明 |
|---|---|
| 区块 1 `SYS_WDG_HEARTBEAT_COUNT` | 参与心跳喂狗的任务数（0 = 关，1~32） |
| `SYS_WDG_Heartbeat(id)` | 任务报到（SRAM 位带原子写，任何上下文可调，无需关中断） |
| `SYS_WDG_HeartbeatAll / Pending / Clear()` | 全员到齐查询 / 缺位掩码（谁没报到，用于定位卡死任务）/ 清零 |
| `SYS_WDG_HeartbeatPoll()` | 全员到齐才喂狗;缺位则不喂，等看门狗复位。多任务场景用此法 |
| 文档 | 文件头新增"使用方式（两种）""喂狗周期对照表""sys_usart 复位原因上报示例" |
| 依赖 | 复用 `gpio_core.h` 的 `BITBAND_SRAM`（sys_wdg.c 新增一行 include）;无新 ISR、无需新 RTE 组件 |

---

## 附录二：RTC / 联动升级（2026-09-29）

> 按《26_RTC时钟源配置》练习改写;移植时连带：`sys_rtc.h/.c`、`sys_softimer.h/.c`、`sys_clock` 扩展、`led/beep/sys_tim/sys_i2c` 新函数，以及 uvprojx 的 RTC 组件登记。

| 项目 | 内容 |
|---|---|
| uvprojx（必须登记） | `<components>` 增加 `StdPeriph Drivers:RTC`（condition="STM32F4 STDPERIPH"），否则 `stm32f4xx_rtc.c` 不参与编译会链接报错;Src/Inc 组登记 4 个新文件 |
| sys_rtc（新） | Init(LSE/LSI 带超时) / Set·GetTime(十进制↔BCD) / Set·GetDate(星期用蔡勒公式自动计算) / 闹钟 A 三种模式 / 秒中断 1s / 备份寄存器×20 / 回调机制(ISR __weak) |
| sys_softimer（新） | 软定时器引擎：Add(cb,period_ms)/Poll()/Remove/Count，是"节拍驱动多条任务"的基础 |
| sys_clock（扩展） | LseOn / LseReady / LsiReady / LsiOn / RtcClkSelect（sys_rtc 的时钟来源;全部带超时） |
| led（扩展） | `LED_OnTo(n)`(点亮 0~n 号) / `LED_BlinkStart(周期ms, 占空比‰)` + `LED_BlinkStop/Update`(每 1ms 驱动，频率与占空比统一设置) |
| beep（扩展） | `BEEP_AsyncStart(times,on,off)` + `BEEP_AsyncStop/Update`(非阻塞节拍，报警不占用主循环) |
| sys_tim（扩展） | `SYS_TIM_TonePlayDuty(freq, duty‰)`(无源蜂鸣器频率与占空比统一设置) |
| sys_i2c（扩展+审查） | 新增 `SYS_I2C_Scan` / `WriteReg16` / `ReadReg16`;文件头"工业级通信要点"清单（PEC 等未内建项已列明） |
| 联动用法 | README 5.31 给出"1ms→LED/BEEP Update;10ms→KEY;100ms→采样;1s→刷屏"的软定时器编排样例 |

---

## 附录三：数据帧增强（2026-09-29，粘包处理）

| 新增 | 说明 |
|---|---|
| `SYS_FRAME_Build(cmd, payload, len, out, cap)` | 组帧到缓冲区（不发送），返回帧长，是定义数据帧的统一入口 |
| `SYS_FRAME_Verify(buf, len)` | 整帧检查：0=合法;1 头 / 2 尾 / 3 长度不符（用于识别两帧粘接）/ 4 校验错 / 5 参数 |
| 文档 | README 5.28 增"防粘包/半包"说明;5.22 向量表更新（RTC_WKUP=3、RTC_Alarm=41 纳入已实现） |

---

## 附录四：位带操作拆分（2026-10-08，结构整理）

> 目的：位带从 GPIO 里拆成独立文件，宏集中一处;其他文件不再自带位带实现。

| 项目 | 内容 |
|---|---|
| 新文件 `sys_bitband.h`（纯宏，无 .c） | 原 gpio_core "区块 3"整体迁入：BITBAND_PERIPH / _SRAM（+_ADDR）、GPIO_BB_OUT/_IN（+_ADDR）、GPIO_BASE_NUM、GPIO_PIN_NUM、PAout~PIin（A~I 全套）;文件头带原理/限制/与教程 sys.h 对照 |
| `gpio_core.h` | 删除位带整节，留"已拆分 → sys_bitband.h"指引;头部结构说明与附录行同步 |
| `led.h/.c` | 撤除 `LED_BB_On/Off/Toggle` + `led_bb[]` 位带表 + 相关 VALUE 宏 |
| `key.h/.c` | 撤除 `KEY_BB_Read` + `key_bb[]` 位带表 |
| `sys_wdg.c` | 心跳掩码位带写 → 短临界区（`__get/__set_PRIMASK` + 置位，嵌套安全）;不再依赖 gpio_core 位带 |
| `uvprojx` | Inc 组登记 `sys_bitband.h` |
| README | 5.1/5.2/5.3 表、附录 A、已知限制同步;新增 5.32 sys_bitband 节 |
| 移植提醒 | 旧代码引用 `LED_BB_*`/`KEY_BB_Read` 的，改用宏：`PFout(9) = 0;` / `PAin(0)`;源文件 `#include "sys_bitband.h"` 即可 |

---

## 附录五：延时函数拆分（2026-10-08，结构整理）

> 目的：延时从 gpio_core 拆成独立 `delay.c/.h`，便于查找与移植;函数名同批改为小写开头（与附录四同一批改动）。

| 项目 | 内容 |
|---|---|
| 新文件 `delay.h / delay.c` | 粗延时 `delay_ms / delay_loop` + DWT 精准延时 `delay_cycles / delay_us / delay_ns / delay_ms_dwt`（含内部 `delay_dwt_enable` 与 DWT_Type 附录） |
| 函数改名 | `Delay_*` → 小写开头 `delay_*`（调用处/文档全同步;老工程升级注意：`SYS_TICK_Delay_ms/us` 属 sys_tick 模块，不随之替换） |
| `gpio_core.h/.c` | 删除延时节，留指引;头部/实现头同步;`#include "delay.h"` 兼容转含（include 路径不变，函数名变化见上行） |
| 用延时的模块 | `beep/key/lcd/led/sys_dht11/sys_eth/sys_usart` 显式补 `#include "delay.h"`;`sys_modbus` 直接改用 `delay.h` |
| `uvprojx` | Src 组登记 `delay.c`、Inc 组登记 `delay.h`（均排在 gpio_core 条目之后） |
| README | 3.3 速查表/依赖图/5.1 表/5.7 取舍表/FAQ/已知限制/文件树同步;新增 5.33 delay 节;FreeRTOS/README 指路改 5.33 |
| 兼容性 | 函数行为不变，名字统一小写;旧工程升级：1) 拷 `delay.c/.h` + 工程登记;2) 全局替换 `Delay_` → `delay_`（避开 `SYS_TICK_Delay_*`） |

---

## 附录六：帧协议定稿（2026-10-10，`sys_frame` 改造）

> 背景：附录三那次只加了 `Build`/`Verify` 两个助手，帧格式本身仍是单字节 `AA`…`55` 加逐字节异或，并靠 `SYS_FRAME_WITH_LEN` 在"带长度/简化帧"两种格式间切换;而项目定稿的是双字节帧头 + CRC16-MODBUS 的 20 字节环境帧，两者不匹配，需要改造帧格式而不是改一个宏。
> 本次把 `sys_frame` 从上层 API 到底层帧格式一次改到位，并删除格式切换开关（只留一种格式，减少一种出错可能）。两板 `sys_frame.c/.h` 由构造保证同源（逐字节相同）。

| 项目 | 内容 |
|---|---|
| 线上格式 | `AA 55 \| CMD \| LEN \| DATA \| CRC16低 CRC16高 \| 55 AA`;总长 `8 + LEN`;`LEN` 上限 `SYS_FRAME_MAX_PAYLOAD` = 64（最大帧 72 字节） |
| 校验 | CRC16-MODBUS（初值 `0xFFFF`、多项式 `0x8005` 反射为 `0xA001`、末不异或）;范围 = 帧内 `[2 .. 4+LEN)`，即 CMD + LEN + DATA，不含帧头、不含帧尾、不含 CRC 自身。附带性质：把 CRC 两字节也算进去结果为 0 |
| 新增宏 | `SYS_FRAME_HEAD_HI/LO` = `0xAAU`/`0x55U`;`SYS_FRAME_TAIL_HI/LO` = `0x55U`/`0xAAU`（帧尾与帧头相反）;`SYS_FRAME_OVERHEAD` = `8U` |
| 删除宏 | `SYS_FRAME_HEAD`、`SYS_FRAME_TAIL`、`SYS_FRAME_WITH_LEN`，连同全部"简化帧"代码路径;`SYS_FRAME_SendShort` 现语义 = CMD + 空数据段（8 字节整帧），不再是原来的 4 字节简化帧 |
| 错误码改名 | `SYS_FRAME_ERR_CHECK(4U)` → `SYS_FRAME_ERR_CRC(4U)`（数值不变）;旧名保留为别名 `#define SYS_FRAME_ERR_CHECK SYS_FRAME_ERR_CRC`，老代码不用改 |
| 新增助手 | `SYS_FRAME_BuildEnv(out, cap, temp_x100, humi_x100, press_x10, light, tvoc, mq135)` 返回 20 / 0;`SYS_FRAME_UnpackEnv(payload, len, …)` 拆数据段（不是整帧），返回 `SYS_FRAME_OK` / `SYS_FRAME_ERR_PARAM` |
| 环境帧字段 | `CMD = SYS_FRAME_CMD_ENV 0x01U`、`LEN = SYS_FRAME_ENV_LEN 0x0CU`;数据段偏移 `TEMP` 0 / `HUMI` 2 / `PRESS` 4 / `LIGHT` 6 / `TVOC` 8 / `MQ135` 10（对应整帧内 4/6/8/10/12/14，CRC 在 16/17，帧尾 18/19，整帧 20）;全部大端;`PRESS` 是 hPa × 10 而非 ×100（×100 时 1013.25 hPa → 101325 会溢出 uint16） |
| 数据段自由度 | 数据段可以出现 `0xAA` / `0x55`。本格式靠"长度 + CRC16"定界，不要求数据避开帧头帧尾 |
| 解析要求 | 帧尾 `0x55AA` 与下一帧帧头 `0xAA55` 相邻会拼出 `… 55 AA AA 55 …`，因此不能见到 `0xAA55` 就当帧头;必须 1) 连续两字节帧头 + 2) 长度自洽（`LEN + 8 == 实际帧长`）+ 3) 从 CMD 起重算 CRC16 相等，三重确认（`SYS_FRAME_Verify()` 一次查全） |
| 未变项 | 公共 API 签名全部不变（`Send/SendShort/Poll/Available/Get/Feed/Reset/ErrCount` + 5 个 `*Legacy` + `Build`/`Verify`）;按 uart 实例化状态机（`fx[SYS_USART_COUNT]`）、只保留最新一帧、`Get` 的 `cap` 越界检查（不足返回 2 且不清 ready）均保留 |
| 两板差异 | `sys_frame.c` 524 行、`sys_frame.h` 277 行，两板逐字节相同（MD5 `1B92F37DBF598A9B191CDB2E198FC43F` / `4BB8CE17075DDD92BD6547B75ECA29CC`）。不再依赖任一板的 modbus 模块：文件内自带 `static uint16_t frame_crc16()` / `frame_crc16_update()`（注释说明"故意与 modbus 模块重复，以保持本文件两板同源"），已比对与 `SYS_MODBUS_Crc16` / `MODBUS_CRC16` 完全等价 |
| 调用者 | 全仓库 `.c/.h` 中除自身外无人使用 `SYS_FRAME_*`，因此删宏 / 改名 / 换格式未破坏任何调用者。两个 `main.c` 用的是自己那套 `FRAME_*` 宏 + 各自的 modbus CRC，与本模块无耦合 |
| 编译验证 | 两板均 `0 Error(s), 0 Warning(s)`、UV4 退出码 0;板1 `Code=27004 RO-data=1496 RW-data=296 ZI-data=32928`、板2 `Code=33288 RO-data=2236 RW-data=356 ZI-data=33572` |
| 文档同步 | 板1 README 5.28、板2 README 5.50 已完成;本附录为补充记录 |
