lmh666-yes/Second_Project_Demo/05_硬件资料/硬件/板1_传感器底板/BOM.csv

位号 | 名称 | 规格 | 封装 | 数量 | 备注
J1 | DC 电源座 | DC-005 5.5x2.1 | THT | 1 | 5V 输入
F1 | 自恢复保险丝 | 1A/6V | PTC 1812 | 1 | 可省
D2 | TVS | SMAJ5.0A | SMA | 1 | 可省
U2 | LDO | AMS1117-3.3 | SOT-223 | 1 | 1A 输出 发热留铜
C1 | 电解电容 | 100uF/16V | 直插 D6.3 | 1
C2 | 电解电容 | 100uF/10V | 直插 D6.3 | 1
C3 | 陶瓷电容 | 0.1uF/50V | 0603 或直插 | 1
C4~C8 | 陶瓷电容 | 0.1uF/50V | 0603 或直插 | 5 | 每个座旁一颗
R1 | 电阻 | 1k | 0603 | 1 | 电源灯限流
R2/R3 | 电阻 | 4.7k | 0603 | 2 | 默认 DNP 不上件
D3 | LED | 绿色 3mm/0805 | THT/0805 | 1 | 电源指示
TP1~TP4 | 测试点 | 1.0mm 焊盘 | 焊盘 | 4 | 3V3/SCL/SDA/GND
J2 | 排针/座 | XH2.54 5P 或 2.54 排针 | THT | 1 | 飞线到天马板
J3~J5 | 排母 | 1x4 2.54 母座 | THT | 3 | BH1750/SHT30/BMP280
J6 | 排母 | 1x8 2.54 母座 | THT | 1 | CCS811
J7 | XH2.54 座 | 5P 带卡扣 | THT | 1 | OLED 专用；与 J3~J6 排母不同型，插不反
H1~H4 | 安装孔 | M3 | 焊盘 | 4 | 可选
