lmh666-yes/Second_Project_Demo/05_硬件资料/硬件/板1_传感器底板/网表.csv

元件 | 引脚 | 网络 | 说明
J1 | 1 | +5V | DC 5.5x2.1 座 中心针
J1 | 2 | GND | DC 座 外壳
F1 | 1 | +5V_IN | 自恢复保险丝 1A 进
F1 | 2 | +5V | 自恢复保险丝 1A 出
D2 | 1 | +5V | TVS SMAJ5.0A 阳极接 GND
D2 | 2 | GND | TVS 阴极
U2 | 3 | +5V | AMS1117-3.3 IN
U2 | 1 | GND | AMS1117-3.3 GND/ADJ
U2 | 2 | +3V3 | AMS1117-3.3 OUT
C1 | 1 | +5V | 100uF/16V 电解 正
C1 | 2 | GND | 100uF/16V 电解 负
C2 | 1 | +3V3 | 100uF/10V 电解 正
C2 | 2 | GND | 100uF/10V 电解 负
C3 | 1 | +3V3 | 0.1uF 陶瓷
C3 | 2 | GND | 0.1uF 陶瓷
R1 | 1 | +3V3 | 1k 限流 电源灯
R1 | 2 | LED_A | 接 D3 阳极
D3 | 1 | LED_A | 绿色 LED 阳极
D3 | 2 | GND | 绿色 LED 阴极
R2 | 1 | +3V3 | 4.7k SCL 上拉（默认不焊）
R2 | 2 | SCL | 4.7k SCL 上拉
R3 | 1 | +3V3 | 4.7k SDA 上拉（默认不焊）
R3 | 2 | SDA | 4.7k SDA 上拉
TP1 | 1 | +3V3 | 测试点
TP2 | 1 | SCL | 测试点
TP3 | 1 | SDA | 测试点
TP4 | 1 | GND | 测试点
J2 | 1 | +3V3 | 飞线到天马板 3.3V
J2 | 2 | SCL | 飞线到天马板 PB8
J2 | 3 | SDA | 飞线到天马板 PB9
J2 | 4 | GND | 飞线到天马板 GND
J2 | 5 | NC | 防呆空脚
J3 | 1 | +3V3 | BH1750 VCC
J3 | 2 | GND | BH1750 GND
J3 | 3 | SCL | BH1750 SCL
J3 | 4 | SDA | BH1750 SDA
C4 | 1 | +3V3 | J3 旁去耦 0.1uF
C4 | 2 | GND | J3 旁去耦
J4 | 1 | +3V3 | SHT30 VCC
J4 | 2 | GND | SHT30 GND
J4 | 3 | SDA | SHT30 SDA
J4 | 4 | SCL | SHT30 SCL
C5 | 1 | +3V3 | J4 旁去耦 0.1uF
C5 | 2 | GND | J4 旁去耦
J5 | 1 | +3V3 | BMP280 VCC
J5 | 2 | GND | BMP280 GND
J5 | 3 | SCL | BMP280 SCL
J5 | 4 | SDA | BMP280 SDA
C6 | 1 | +3V3 | J5 旁去耦 0.1uF
C6 | 2 | GND | J5 旁去耦
J6 | 1 | +3V3 | CCS811 VCC
J6 | 2 | GND | CCS811 GND
J6 | 3 | SCL | CCS811 SCL
J6 | 4 | SDA | CCS811 SDA
J6 | 5 | GND | CCS811 nWAKE 必须接地
J6 | 6 | NC | CCS811 nINT 悬空
J6 | 7 | +3V3 | CCS811 nRESET 必须接高
J6 | 8 | GND | CCS811 ADDR 接地=0x5A
C7 | 1 | +3V3 | J6 旁去耦 0.1uF
C7 | 2 | GND | J6 旁去耦
J7 | 1 | NC | OLED 座 5 芯 XH2.54 第1脚留空(防呆：传感器排母插不进来)
J7 | 2 | GND | OLED GND
J7 | 3 | +3V3 | OLED VCC
J7 | 4 | SCL | OLED SCK
J7 | 5 | SDA | OLED SDA
C8 | 1 | +3V3 | J7 旁去耦 0.1uF
C8 | 2 | GND | J7 旁去耦
