lmh666-yes/Second_Project_Demo/02_通信端_STM32F407/Project/改动清单.md

# 改动清单

> 日期 : 2026-10-15
> 工程 : `000标准模板库`（板2 数据通信端，`EnvMonitor\Project_2_数据通信端\Project`）
> 范围 : 只改本工程 `FWLIB` 的 4 个模块（7 个文件）；不动 `main.c`、不动 Qt、不动板1
> 依据 : 本工程 `FWLIB改动清单_待审.md`（A1 / A2 / B1 / B2），已获批准"可以就按照这个改"
> 结果 : Keil UV4 编译 **0 Error(s), 0 Warning(s)**

## 一、改了什么

| 编号 | 文件 | 改动内容 |
|---|---|---|
| A1 | `FWLIB\inc\sys_usart.h`、`FWLIB\src\sys_usart.c` | ① 接收缓冲由"6 路各 64B 的定长数组"改成**一整块分段池** `rx_pool[]` + `rx_off[]` + `rx_size[]`（偏移由 `SYS_USART_RX_OFF_1..6` 累加得出），每路大小改用独立宏 `SYS_USART1..6_RX_BUF_SIZE`（默认 `SYS_USART_RX_BUF_SIZE` = 64）；② 新增编译期护栏 `usart_rxbuf_size_check_1..6`（任一路 < 32 直接编译报错）；③ 中断里缓冲满时丢的是"新来的"字节，**并计数**（`rx_drop_full[]`），硬件 ORE 另计（`rx_drop_ore[]`），都不再静默；④ 新增查询接口 `SYS_USART_RxDropCount`（满 + ORE 总数）/ `SYS_USART_RxFullCount`（其中满）/ `SYS_USART_RxOverrunCount`（其中 ORE）/ `SYS_USART_RxDropReset`（清零） |
| A2 | `FWLIB\inc\w25qxx_log.h`、`FWLIB\src\w25qxx_log.c` | ① 并发保护由 `vTaskSuspendAll()/xTaskResumeAll()` 换成**递归互斥量**（惰性创建、失败退化为无锁、中断/调度器未启动时不加锁）；② 新增 `W25QXX_LogClearStep(uint8_t *done)`：一次擦一个扇区、扇区之间放锁，`W25QXX_LogClear()` 改为循环调用它；③ 清日志期间写接口返回新增的 `W25QXX_LOG_ERR_BUSY(7U)`、读接口返回 `ERR_EMPTY`；④ 新增 `s_clearing/s_clear_sec` 状态，`W25QXX_LogInit()` 收尾清零（否则清日志被中途打断后再 init，写接口会永远 BUSY）；⑤ `W25QXX_LogErrStr()` 补 BUSY 文案 |
| B1 | `FWLIB\inc\esp8266.h`、`FWLIB\src\esp8266.c` | 模块内新增一把**递归互斥量**（写法同 A2），`ESP8266_SendCmd/Flush/GetRawRx/HasAsyncData/ServerHasClient` 进函数加锁、返回前解锁；`SendCmd` 本体拆成内部 `esp_send_cmd_locked()` + 公共包装；头文件新增"并发"段（谁锁谁、返回的指针何时失效） |
| B2 | `FWLIB\src\mqtt.c` | `MQTT_Poll()` 取数据顺序调换：**先**调 `mqtt_alive_check_rx()`（内部会 `esp_pump()` 搬字节、必要时前移接收缓冲）**再**调 `ESP8266_GetRawRx(&rx)` 取长度和指针，消除"长度是搬之前、内容是搬之后"的错配 |

## 二、与原计划的两处偏差（原因已写进代码注释）

1. **擦除/页编程仍留在锁内**（原计划写的是"移出临界区"）。理由：写路径要跨扇区时必须先擦该扇区，读者也要拿同一把锁 —— 擦除留在锁内，读者就看不到"擦了一半"的槽；移出锁反而要再引一套"擦除中"状态。持锁时间 typ 45ms / max 400ms，且**只挡住同样用本模块的任务**（不再挂调度器），心跳 / 采集 / 界面都不受影响。
2. **`W25QXX_LogClearStep()` 一次只擦一个扇区**（原计划只说"让出 CPU"）。这样上位机"清缓存"命令可以在两次调用之间刷界面、喂心跳，不必一次占锁 0.8 秒。

## 三、验收

| 项 | 方式 | 结果 |
|---|---|---|
| 编译 | `build_keil.bat`（`E:\k5_v5\UV4\UV4.exe -r 000标准模板库.uvprojx -j0 -o build_verify.log`） | **0 Error(s), 0 Warning(s)**；`Code=11284 RO-data=3188 RW-data=236 ZI-data=4180` |
| 目标文件 | `Objects\sys_usart.o`、`w25qxx_log.o`、`esp8266.o`、`mqtt.o` 是否本次重生成、新符号在不在 | 均在本次编译重生成；`w25qxx_log.o` 可查到 `W25QXX_LogClearStep`，`esp8266.o` 可查到 `esp_send_cmd_locked`、`esp_lock` |
| 上板 A1 | 115200 下连续灌 1KB 不读 → `SYS_USART_RxDropCount` 能读出丢的字节；把该路宏改 256 后同条件不再丢 | 待上板 |
| 上板 A2 | 写入任务与补传任务并发跑 30 分钟 → 100ms 心跳不跳拍、`LogStat` 的 count 单调、`LogLost` 只增、每条 CRC 都对 | 待上板 |
| 上板 B1 | 两个任务各并发调 `ESP8266_TestAT()` 100 次 → 全部返回 0 | 待上板 |
| 上板 B2 | 订阅跑 30 分钟 → 按 topic+payload 统计重复报文为 0，`MQTT_IsAlive()` 不误判 | 待上板 |

> 关于 Program Size 没变：板2 当前 `main.c` 是骨架（83 行），**没有调用**这四个模块，链接器把它们的代码段整体丢弃了，所以编译验证的是"语法 / 类型 / 接口一致"，功能验证必须上板。

## 四、文档同步

- `README.md` 已同步：5.8 sys_usart（4 个计数接口 + 每路缓冲宏 + 编译期护栏）、5.30 esp8266（多任务安全 + 返回指针何时失效）、5.45 w25qxx_log（记录格式 32B/2048 条、`LogClearStep`、互斥量替代挂调度器、掉电安全依据改为"最后写 seq"）。
- 本文件即本工程 `改动清单.md`（板2 首次建立，格式对齐板1 同名文件）。

## 五、下一步提示

1. 上板跑第三节的四项验收；需要的话我可以把验收过程写成独立测试任务（不动你的 `main.c`）。
2. `README.md` 5.42 mqtt 一节还没写"取值顺序不能换"的说明，要不要一起补。
3. `FWLIB改动清单_待审.md`（审批稿）与新建的 `改动清单.md` 目前都是**未跟踪**状态；要入库你说一声，我不主动 `git add`。
