lmh666-yes/Second_Project_Demo/04_文档/架构与设计/程序模块与改动清单.md

# 程序模块与改动清单

日期：2026-10-11　　工程：`EnvMonitor\Project_1_检测端`、`EnvMonitor\Project_2_数据通信端`

本文件回答两个问题：两块板的程序模块搭建到底动了哪些文件；后续能不能只写一个新的 `main.c` 就用起来。文中数字均为实测：`.uvprojx` 里的文件列表、`git diff`、`本地工具\仓库巡检\改动分类.py`。

## 1. 一个工程由哪几部分组成

两个工程的结构相同，都是"一个 `main.c` + 一套驱动库 + FreeRTOS + 以太网库 + 芯片支持文件"：

| 目录 | 来源 | 内容 |
|---|---|---|
| `Project\main.c` | 本项目 | 唯一一个应用文件，任务与业务全部在这里 |
| `Project\FWLIB\inc`、`src` | 本项目驱动库 | 板级与器件驱动（串口、SPI、I2C、RTC、看门狗、LoRa、Flash 等） |
| `Project\FreeRTOS\src`、`inc`、`port` | 第三方 + 移植层 | 内核源码、`FreeRTOSConfig.h`、`heap_4.c`、`port.c`、`freertos_hooks.c` |
| `Project\ETH\src`、`inc`、`port` | 第三方（ST） | `stm32f4x7_eth.c` 等，两工程都参与编译但默认不启用 |
| `Project\RTE`、`Objects`、`Listings` | Keil 生成 | 启动文件、`system_stm32f4xx.c`、编译产物 |

Keil 工程文件：板1 是 `Project\标准模板.uvprojx`，板2 是 `Project\000标准模板库.uvprojx`。

实际参与编译的 `.c` 数量（实测 `<FilePath>` 列表）：

| 工程 | 合计 | `main.c` | FWLIB | FreeRTOS | ETH |
|---|---|---|---|---|---|
| 板1 检测端 | 45 | 1 | 35 | 8 | 1 |
| 板2 数据通信端 | 65 | 1 | 55 | 8 | 1 |

编译宏（实测 `<Define>`）：

- 板1：`USE_STDPERIPH_DRIVER, STM32F40_41xxx, HSE_VALUE=8000000, SYS_TEST_BOARD=1`
- 板2：`USE_STDPERIPH_DRIVER, STM32F40_41xxx, HSE_VALUE=8000000, SYS_TEST_BOARD=2`

两工程头文件搜索路径相同：`.\FWLIB\inc;.\FreeRTOS\inc;.\FreeRTOS\port;.\ETH\inc;.\ETH\port`。

## 2. 应用逻辑集中在 main.c

两份 `main.c` 同源：板1 那份 1071 行，板2 那份 1298 行，逐行比对有 1045 行相同（占板2 的 80.5%），27 个差异块。板2 多出来的是 ESP8266/MQTT 的 include、USART6 上的 LoRa 收发、下行命令通道 `vTaskCmdRx`。

两份文件的应用层 include（实测）：

- 板1：`gpio_core.h  led.h  delay.h  sys_clock.h  sys_tick.h  sys_nvic.h  sys_usart.h  sys_wdg.h  sys_rtc.h  lora_e22.h  sys_dht11.h  sys_modbus.h  w25qxx.h  w25qxx_log.h  modbus.h`
- 板2：上述基础上加 `sys_frame.h  esp8266.h  mqtt.h  semphr.h`

`main.c` 里放的内容：任务函数与任务表、队列与互斥量、组帧与解帧、上板自检序列、看门狗心跳上报、`GPIO_ClaimDump()`。

`main()` 的初始化顺序（板2 实测 `main.c:1187-1292`）：

```
SYS_NVIC_Init()                      // 必须是第一句，它设置 NVIC 优先级分组 Group_4
SYS_USART_Init(DBG, DBG_BAUD); SYS_USART_InitRxIT(DBG, DBG_BAUD)
... SYS_USART_InitRxIT(USART_QT, USART_QT_BAUD)
LED_Init() ... 各外设初始化
GPIO_ClaimDump()                     // 调度器启动前打印引脚占用与冲突
xQueueCreate / xTaskCreate / xSemaphoreCreateMutex
SYS_WDG_Init(APP_WDG_TIMEOUT_MS)
vTaskStartScheduler()
```

两块板共用一份源码，靠 `#if (SYS_TEST_BOARD == 1)` / `#else` 分板，`APP_TASK_COUNT` 也按板分开。

## 3. 本轮改过的文件

口径：`本地工具\仓库巡检\改动分类.py HEAD`。做法是把基线版本与工作区版本各自去掉注释、压掉空白再逐行比对，代码一致即判定"只改了注释"；再把字符串字面量内容掩码掉比一次，用来区分"只改文案"。基线是 git HEAD `ee264e8`（2026-10-09）。

| 目录 | 代码逻辑改动 | 仅字符串/文案 | 仅注释 |
|---|---|---|---|
| `Project_1_检测端` | 44 | 0 | 22 |
| `Project_2_数据通信端` | 54 | 0 | 52 |
| `QT_project\SerialMonitor` | 5 | 0 | 0 |

本轮没有新增或删除文件，改动全部是就地修改。Qt 目录另有若干新文件尚未纳入 git 跟踪（`devctl.*`、`physrange.h`、`thresholddialog.*`、`frameparser.*`、`datamodel.*`、`alarmmanager.*`、`consistencytest.*`、`tests\`、`tools\`）。

代码逻辑改动里与功能直接相关的部分：

| 文件 | 改动内容 |
|---|---|
| `FWLIB\inc\sys_usart.h`、`src\sys_usart.c` | 串口从 3 路扩到 6 路：USART1/2/3 与 UART4/UART5/USART6，含时钟、引脚、IRQ 与 DMA 分派 |
| `FWLIB\inc\sys_frame.h`、`src\sys_frame.c` | 定稿协议的组帧/解帧（`SYS_FRAME_Build/Get/Send/Poll`） |
| `FWLIB\src\w25qxx.c`、`w25qxx_log.c` | JEDEC 判据改为只校验容量字节、槽布局改为 32 字节、整扇区擦除后回填计数 |
| `FWLIB\src\mqtt.c`、`esp8266.c` | 增加判活（`MQTT_IsAlive()`）、修 `AT+CIPSEND` 命令拼装 |
| `FWLIB\src\modbus.c`、`sys_rs485.c` | 从机接收帧长、方向脚切换时序 |
| `FWLIB\src\at24c02.c` | 页边界处理、返回码语义 |
| `FWLIB\src\gpio_core.c` | 引脚占用登记与 `GPIO_ClaimDump()` 冲突检测 |
| `FWLIB\src\sys_wdg.c` | 心跳位图喂狗 |
| `main.c` | 任务、自检序列、转发链路、下行命令通道 |
| 板2 `main.c`、`FWLIB\inc\sys_frame.h` | 断网缓存补传通路：`0x16` 触发/停止、`0x15` 历史帧上报、`0x96` 进度应答、收尾清空缓存，另有补传任务 `vTaskReplay` 与自检 08b |
| Qt `frameparser.*`、`datamodel.*`、`devctl.*`、`mainwindow.*`、`consistencytest.cpp`、`main.cpp` | 历史帧解析、按原始时间戳入库与去重（键 = 原始时间戳 + 20 字节原帧）、CSV 增"数据来源"列（9 → 10 列）、补传按钮与只读进度、自检用例 |

其余文件是注释与说明文字整理，代码逻辑未动。

## 4. 后续新建一个 main.c 的做法

可以用模板工程派生新工程，但要注意拷贝范围与宏：

1. 整套拷贝工程目录（`Project` 整个目录），不要只拷 `main.c`：驱动库、FreeRTOS、Keil 工程文件都要一起走。
2. 在 Keil 的 C/C++ 选项里改 `<Define>` 的 `SYS_TEST_BOARD`（1 = 检测端，2 = 数据通信端），板卡型号宏 `STM32F40_41xxx` 保持不变。
3. 新 `main.c` 保留三件事：`SYS_NVIC_Init()` 放在第一句；`GPIO_ClaimDump()` 放在调度器启动前；`SYS_WDG_Init()` 与每个任务的心跳上报成对出现。
4. 若新工程要用模板库里没参与编译的驱动，在 Keil 的 FWLIB 分组里 Add Existing Files 加入对应 `.c`，并把新目录加进 IncludePath。
5. 编码与换行：`main.c` 是 GBK(936) + LF，`.uvprojx` 也是 GBK；用 UTF-8 编辑器保存会乱码。

两套驱动库的命名不完全一致，选模板时要注意：

- 板1 库带 `sys_` 前缀的器件文件：`sys_dht11.c`、`sys_modbus.c`、`sys_oled.c`、`sys_mpu6050.c`；
- 板2 库对应的是裸名文件：`dht11.c`、`modbus.c`、`oled.c`、`mpu6050.c`，另有 `w25qxx.c`、`w25qxx_log.c`、`at24c02.c`、`mqtt.c`、`esp8266.c`、`sys_can.c`、`sram.c` 等板1 库里没有的。
- 新 `main.c` 的 include 必须与所选那套库的文件名一致。

## 5. 已知需要收口的点

- 上位机跳线编号 P5/P6 已统一为 P6：板2 `FWLIB\inc\lora_e22.h:49,92` 与 `FWLIB\inc\sys_usart.h:13,24` 已改，依据是板2 `README.md:178,783,2402` 与原理图（P6 = 6 针 `USART2_TX/RX + RS485_RX/TX` 跳线座；板2 P5 是 18 针扩展排针）。设计文档 `数据传输端设计.md`、`外设采购清单.md:141`、`核心软件和FreeRTOS架构.md:100`、`main参考示例.md:152` 同步改完。
- 板1 的 `main.c` 里板2 分支缺失 `vTaskCmdRx`，已在 2026-10-11 把该分支改成 `#error`：把板1 工程的宏写成 `SYS_TEST_BOARD=2` 会直接编译报错，提示改用板2 工程下的 `main.c`。
- `本地工具\仓库巡检\sync_main.py` 原先保存改写前的引脚表文案块，已收口：删掉过期文案块，只保留"检查引脚表在不在"和板1 的四处结构补丁；由板1 覆盖写出板2 `main.c` 的步骤改为需要显式加 `--write-board2` 才会执行。
- 看门狗心跳原先有撞格：两板的监控任务也调用 `SYS_WDG_Heartbeat(APP_TASK_COUNT - 1U)`，与第三个业务任务（板1 `vTaskComm`、板2 `vTaskCmdRx`）占同一格，会掩盖该任务卡死。库语义（`FWLIB\inc\sys_wdg.h:46-52`）是"每个参与汇总的任务占 0~COUNT-1，监控任务只调 `SYS_WDG_HeartbeatPoll()`"，因此已删掉两板监控任务里的报到调用，原处改成注释说明。改动点：板1 `Project\main.c:912-915`、板2 `Project\main.c:1115-1118`。`SYS_WDG_HEARTBEAT_COUNT` 仍为 0（心跳汇总未启用），删除后行为与改前一致。
- 断网缓存补传已实现（板2 固件 + Qt 上位机两端）：板2 侧 `0x16` 触发/停止补传、`0x15` 历史帧逐条上报、`0x96` 回报进度，收尾清空缓存并恢复写入；Qt 侧解析历史帧、按原始时间戳入库、按"原始时间戳 + 20 字节原帧"去重、CSV 末列标"数据来源"。板2 `Project\main.c` 改动 +399/-5 行，`FWLIB\inc\sys_frame.h` +33 行，`FWLIB\src\sys_frame.c` 未改动。设计、实现差异与未做项见 `EnvMonitor\项目架构思路设计参考\断网缓存补传设计.md` 第 9、10 节。板2 全量复编 0 Error / 0 Warning，Qt 三项自检全 PASS。
- 板2 `FWLIB\src\gpio_core.c` 文件末尾缺换行（Keil 报 `#1-D: last line of file ends without a newline`）已补上，行尾仍为 CRLF；补后板2 全量复编 0 Error / 0 Warning。
