lmh666-yes/Second_Project_Demo/01_检测端_STM32F407/Project/GEC-M4原理图2016-07-29.pdf

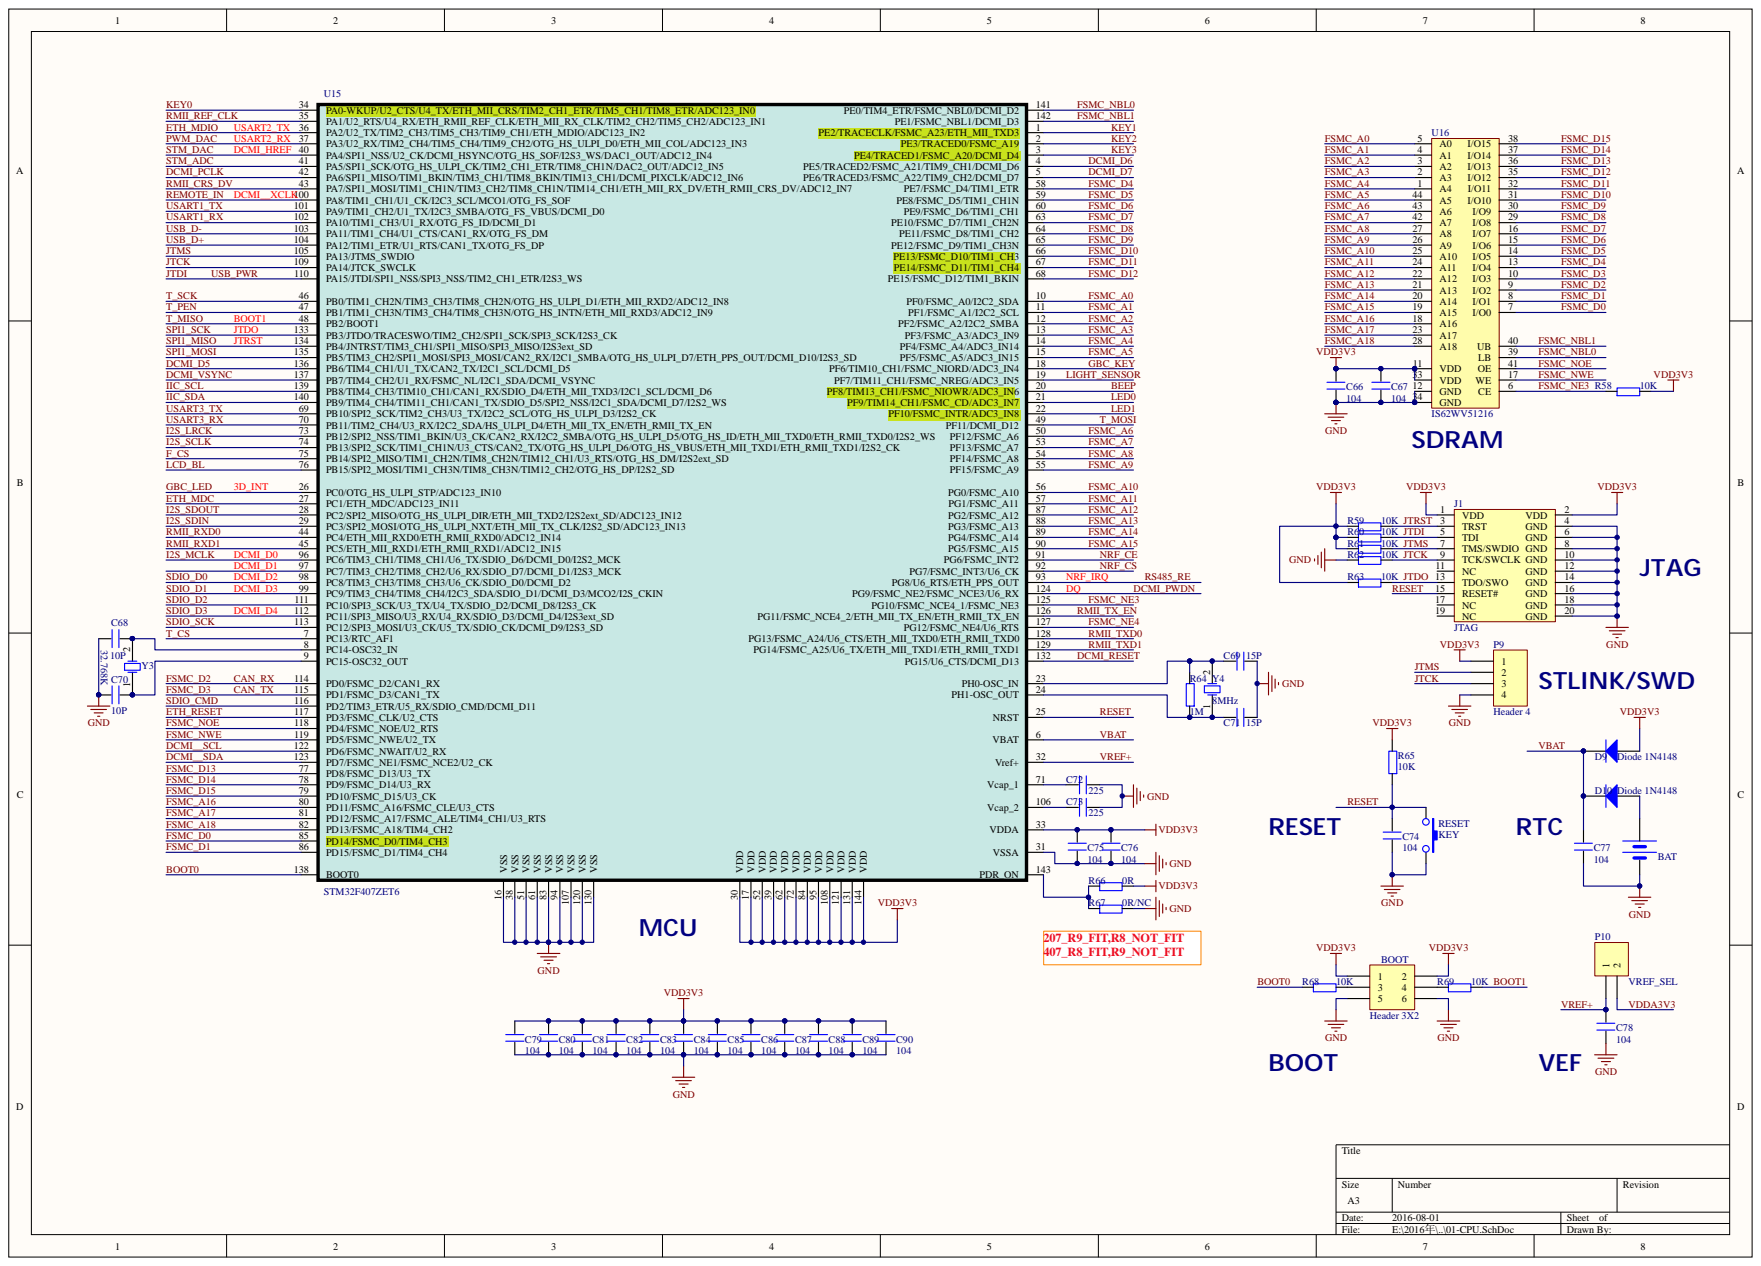
[picture p10: page 1]

A | A
D1 | LED2

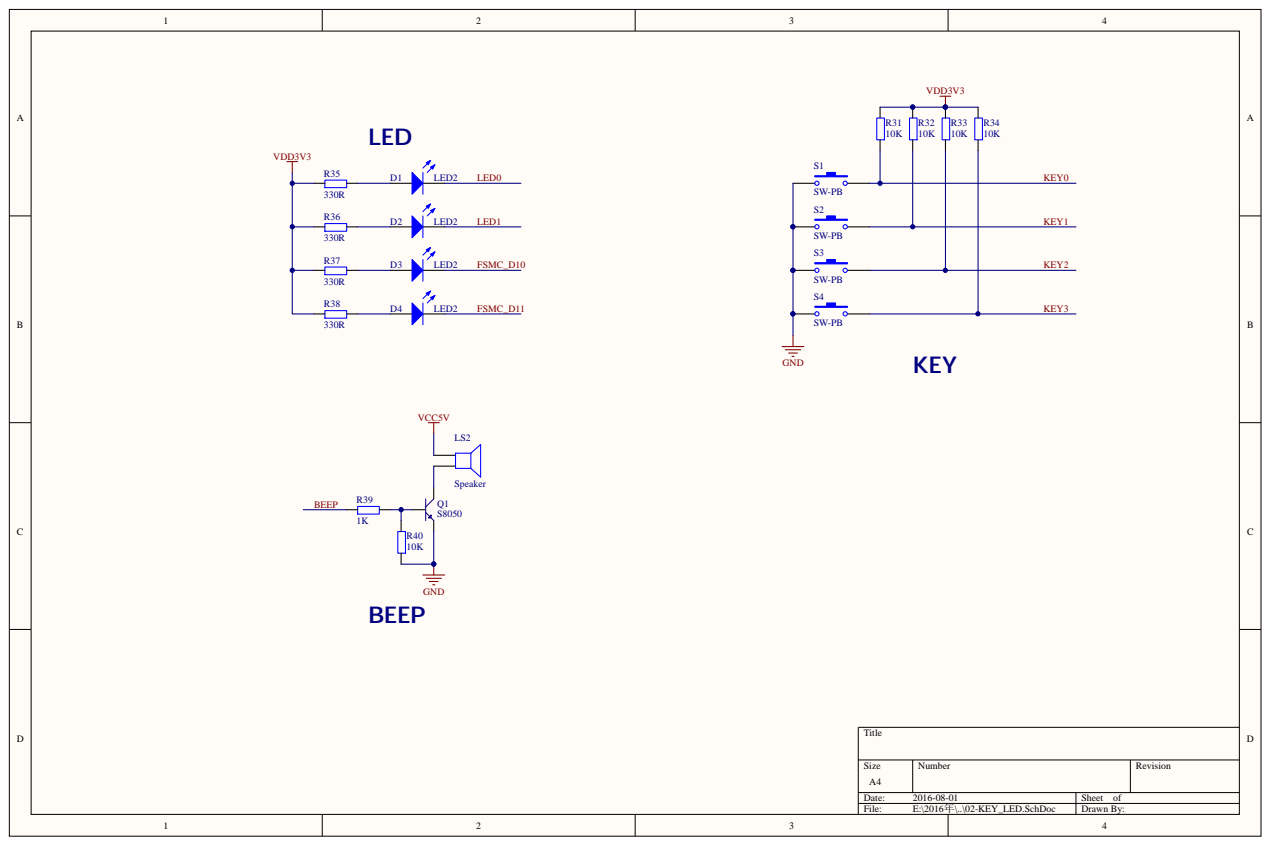
[picture p11: page 2]

A | A

R42 27R

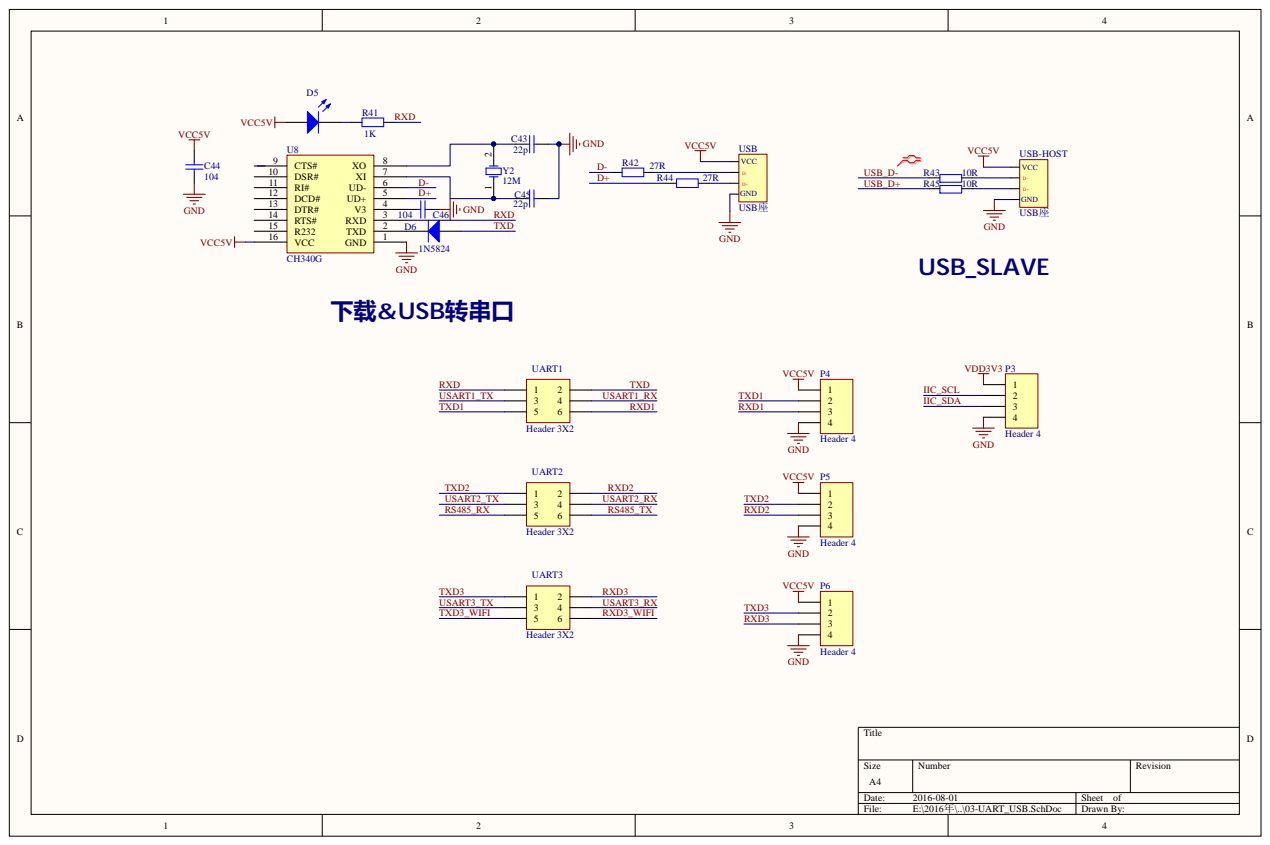
[picture p12: page 3]

A | A

D1 8

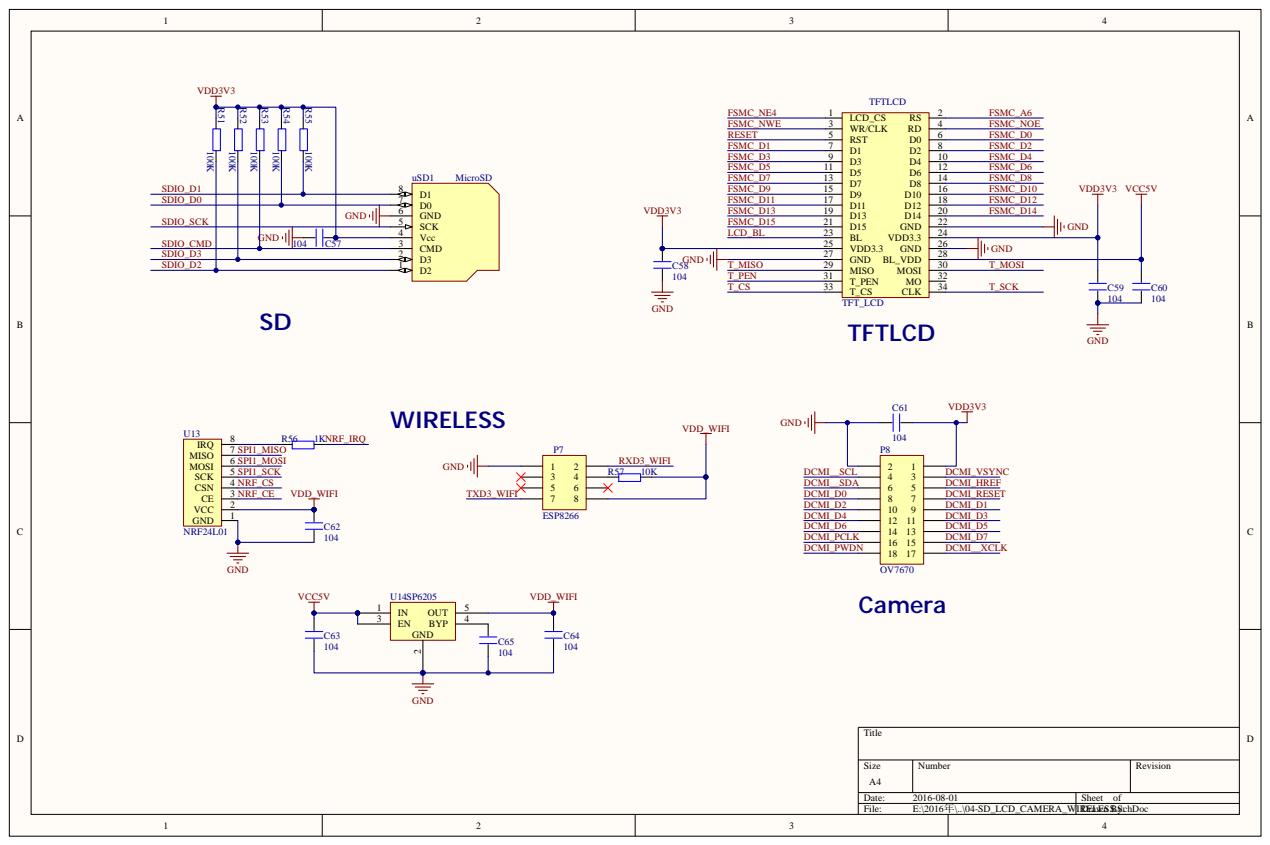
[picture p13: page 4]

11

22

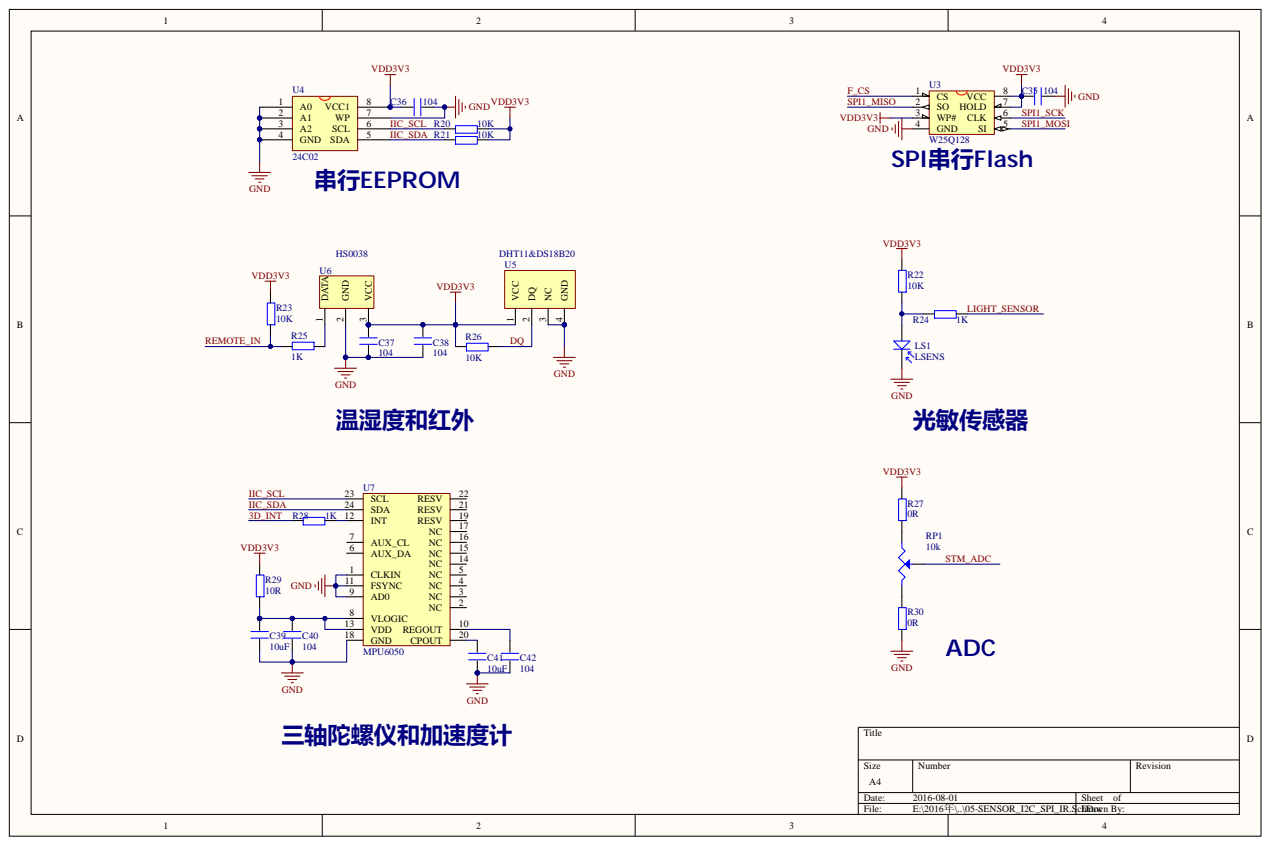
[picture p14: page 5]

A | A

## VDDA3V3C1

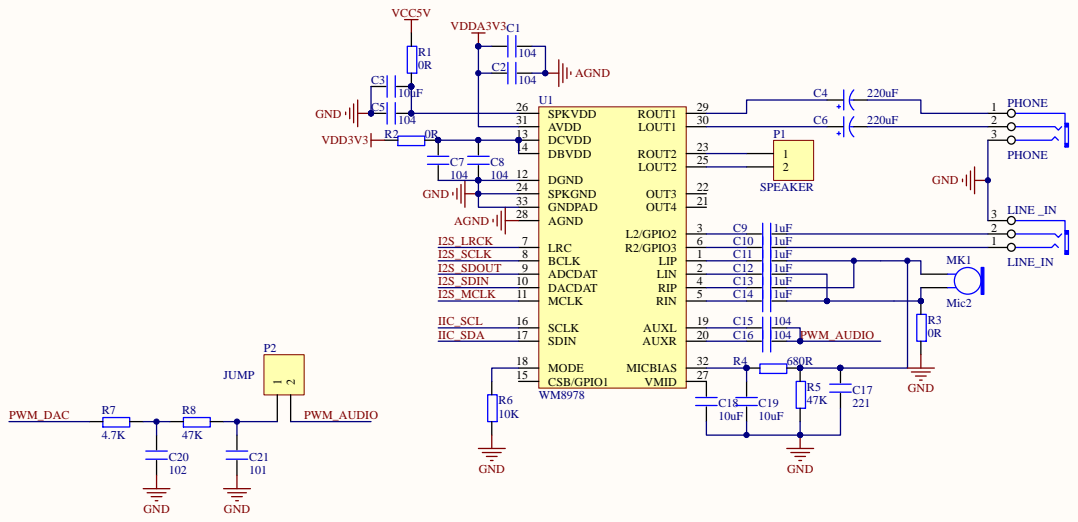
[picture p15: page 6]

A | A
LED2/nINTSEL | 2

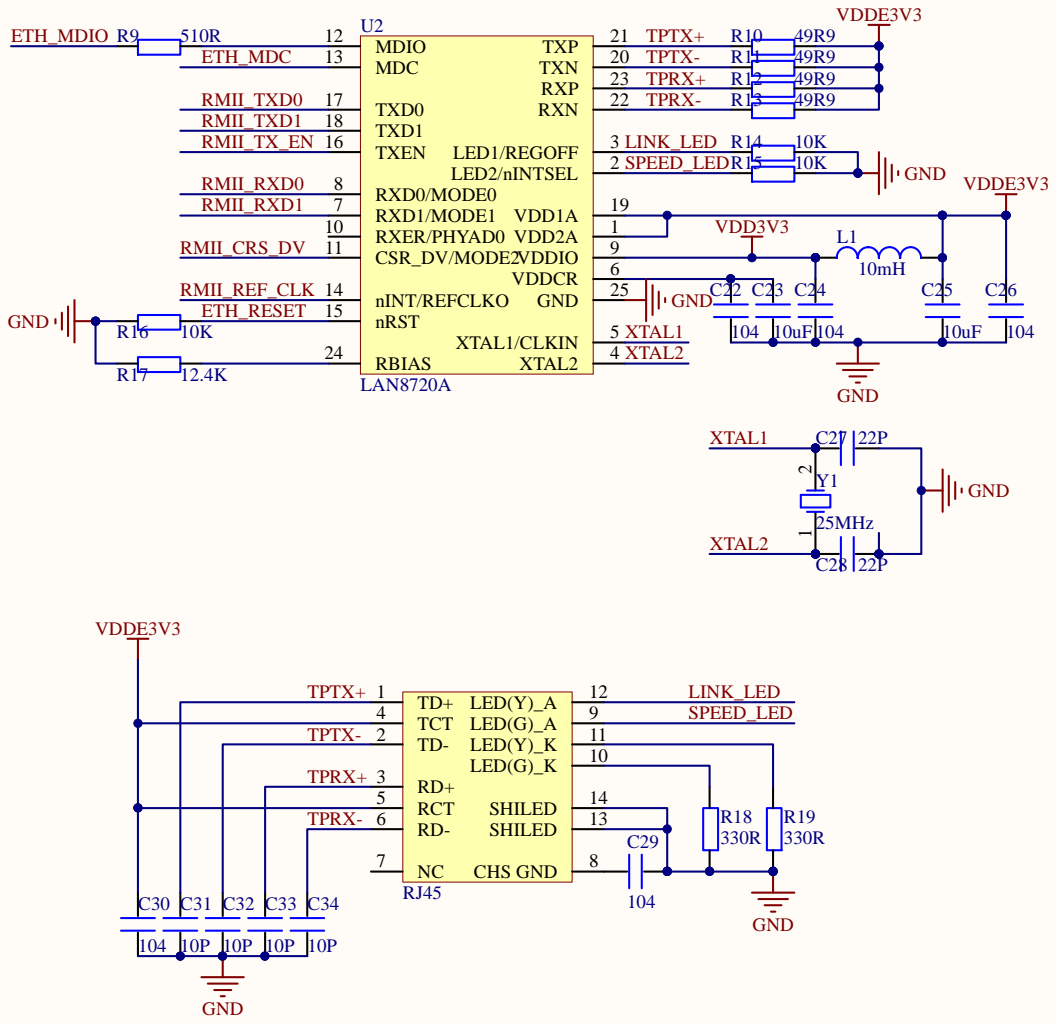
[picture p16: page 7]

A | A

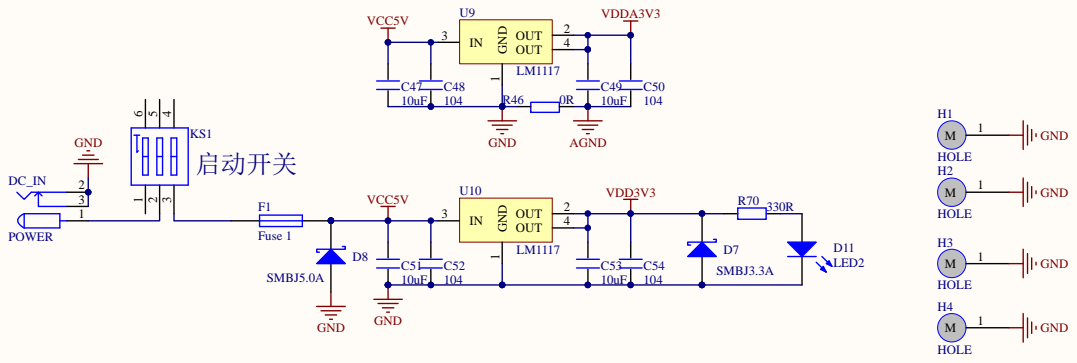
[picture p17: page 8]

A | A
VDD3V3 | GND

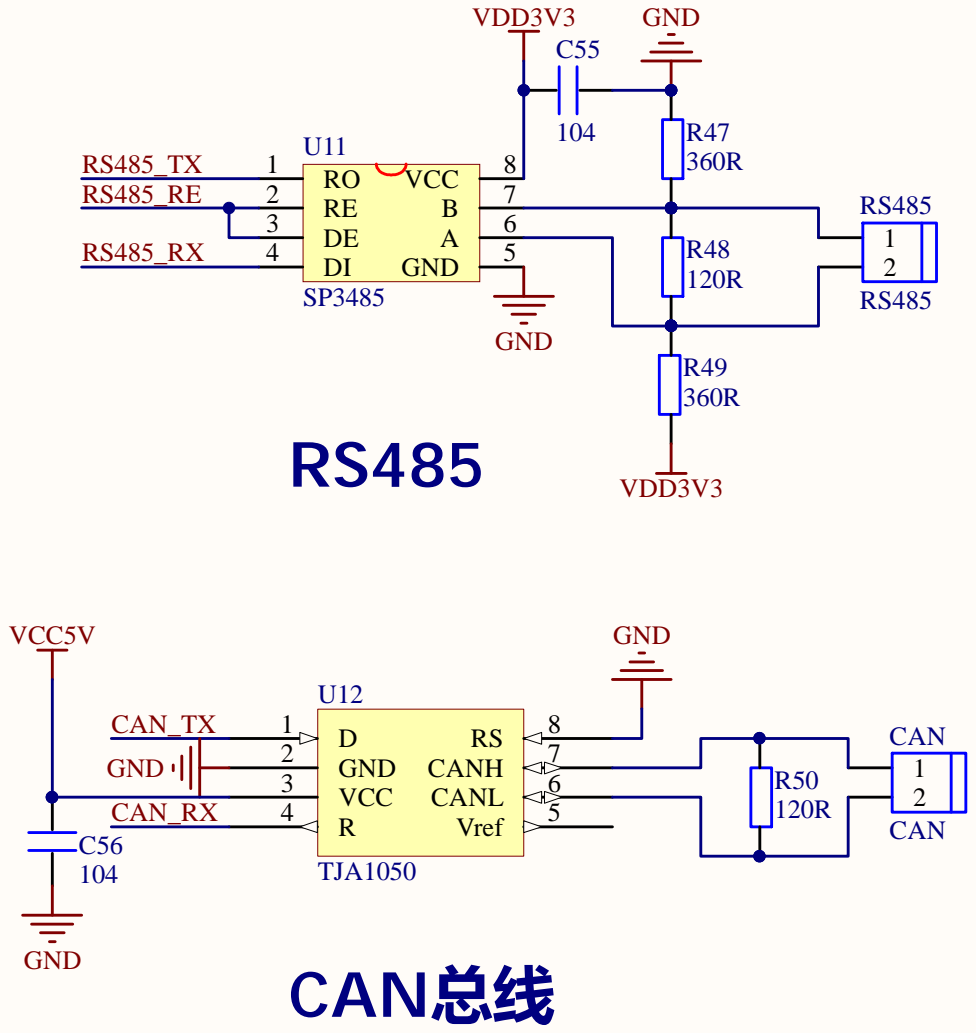
[picture p18: page 9]
