lmh666-yes/Second_Project_Demo/01_检测端_STM32F407/Project/FWLIB/src/sys_ccs811.c

#include "sys_ccs811.h"
/* 实现层;用法示例见同名 .h */
#include "delay.h"
#include "sys_tick.h"


/* ================================================================
 *  sys_ccs811.c — 外接空气质量传感器 CCS811(eCO2 + TVOC) 实现文件
 * ================================================================
 *  初始化顺序(手册要求;顺序错则器件不出数且不报错): 等 20ms → 读 0x20
 *  HW_ID 自检 → 0xFF 写 4 字节软复位 → 等 20ms → 轮询 0x00 等 APP_VALID
 *  (bit4)= 1 → 查 ERROR(bit0) → 0xF4 只发命令(APP_START) → 复读 STATUS 校验 FW_MODE(bit7) → 写 0x01 设模式。
 *  APP_START 只发寄存器号、不带数据,用 SYS_I2C_WriteCmd();
 *  SYS_I2C_WriteBytes(..., NULL, 0) 因 len == 0 返回 SYS_I2C_ERR_PARAM。
 *  数据就绪先读 STATUS.bit3 DATA_READY,再以时间兜底(见 ccs811_meas_period_ms() 上方)。
 *  静态表按 SYS_I2C_1/SYS_I2C_2/SYS_I2C_3 各存一份(同 sys_mpu6050 /
 *  sys_bmp280,共享总线互不干扰)。
 *
 *  寄存器速查: 0x00 STATUS(bit7 FW_MODE / bit4 APP_VALID / bit3 DATA_READY /
 *  bit0 ERROR); 0x01 MEAS_MODE(bit6:4 驱动模式 0 idle/1 1s/2 10s/3 60s/
 *  4 250ms,bit3 中断使能); 0x02 ALG_RESULT_DATA 4 字节(eCO2 大端 u16 +
 *  TVOC 大端 u16); 0x05 ENV_DATA 4 字节(湿度 大端 u16 /512 %RH + 温度
 *  大端 u16 /512 ℃,偏移 +25); 0x11 BASELINE 2 字节(断电保存/上电写回);
 *  0x20 HW_ID 固定 0x81; 0x23 FW_BOOT_VERSION / 0x24 FW_APP_VERSION; 0xE0 ERROR_ID(0 = 无错);
 *  0xF4 APP_START(无数据); 0xFF SW_RESET(写 0x11 0xE5 0x72 0x8A)。
 * ================================================================ */
/* ================================================================
 *                    内部定义
 * ================================================================ */

#define CCS811_REG_STATUS       0x00
#define CCS811_REG_MEAS_MODE    0x01
#define CCS811_REG_ALG_RESULT   0x02
#define CCS811_REG_ENV_DATA     0x05
#define CCS811_REG_BASELINE     0x11
#define CCS811_REG_HW_ID        0x20
#define CCS811_REG_FW_BOOT_VER  0x23
#define CCS811_REG_FW_APP_VER   0x24
#define CCS811_REG_ERROR_ID     0xE0
#define CCS811_REG_APP_START    0xF4
#define CCS811_REG_SW_RESET     0xFF

#define CCS811_STATUS_APP_VALID 0x10U   /* bit4: 片上应用固件已加载 */
#define CCS811_STATUS_ERROR     0x01U   /* bit0: 器件报错 */
#define CCS811_STATUS_DATA_READY 0x08U  /* bit3: 新数据就绪(读 0x02 后清 0) */
#define CCS811_STATUS_FW_MODE   0x80U   /* bit7: 1 = 已进入应用模式 */

/* 数据就绪判据: 只看时间。
 * CCS811 的 STATUS.bit3 = DATA_READY(手册 Table 7): 新数据就绪置 1、读 0x02 后清 0;手册未承诺它一定在整周期后才置位
 * (另有一种说法是部分固件把 bit3 挪作他用,该说法无手册依据;所以下面保留时间兜底"永远不就绪"或"永远就绪");故 DataReady 先查 bit3,查不到再改用"距上次成功读取
 * ≥ 当前模式周期"这一跨版本成立的判据。 */

/* 按测量模式给出数据更新周期(ms);MEAS_MODE 的 bit6:4 = 驱动模式(掩掉 bit3
 * 中断使能);模式 1/2/3/4 对应 1s / 10s / 60s / 250ms;模式值非法(如 0xFF)
 * 返回 0,由调用方用兜底周期。 */
static uint32_t ccs811_meas_period_ms(uint8_t mode)
{
    switch (mode & 0x70U) {
        case 0x00U: return 0U;                                  /* idle: 不测量 */
        case 0x10U: return 1000U;                               /* mode 1: 1s  */
        case 0x20U: return 10000U;                              /* mode 2: 10s */
        case 0x30U: return 60000U;                              /* mode 3: 60s */
        case 0x40U: return 250U;                                /* mode 4: 250ms */
        default:    return 0U;                                  /* 非法: 走兜底 */
    }
}

/* 每条总线上"上次成功读取"的时间戳(ms);时间判据的依据 */
static uint32_t s_last_read_ms[SYS_I2C_COUNT];

/* 本模块实际在用的器件地址(按总线各存一份)
 * 约束: InitAddr() 允许改成 0x5B,读数据必须用同一地址;读函数写死 0x5A
 * 会导致初始化成功但此后读不到数据。初值为默认地址,未 Init 也可调 GetHWID。 */
static uint8_t s_addr[SYS_I2C_COUNT] = {
    SYS_CCS811_ADDR, SYS_CCS811_ADDR, SYS_CCS811_ADDR
};


/* 内部辅助 */
/* 只发一个寄存器/命令字节,不带数据;供 APP_START(0xF4) 这类命令式写用。
 * 底层 SYS_I2C_WriteCmd() 的事务为 START → 地址+W → cmd → STOP。 */
static int ccs811_write_cmd(SysI2cId_t bus, uint8_t addr7, uint8_t reg)
{
    return SYS_I2C_WriteCmd(bus, addr7, reg);
}


/* 基础功能 */
uint8_t SYS_CCS811_Init(SysI2cId_t bus)
{
    uint8_t rc;

    /* 0x5A 无应答时再试 0x5B：ADDR 脚悬空/接高都会落到 0x5B */
    rc = SYS_CCS811_InitAddr(bus, SYS_CCS811_ADDR);
    if (rc == SYS_CCS811_ERR_HW_ID) {
        rc = SYS_CCS811_InitAddr(bus, SYS_CCS811_ADDR_ADDR_HIGH);
    }
    return rc;
}

int SYS_CCS811_GetHWID(SysI2cId_t bus)
{
    uint8_t id = 0U;

    if (bus >= SYS_I2C_COUNT) return SYS_I2C_ERR_PARAM;
    if (SYS_I2C_ReadByte(bus, s_addr[bus], CCS811_REG_HW_ID, &id) != SYS_I2C_OK) {
        return SYS_I2C_ERR_ADDR;
    }
    return (int)id;
}

int SYS_CCS811_GetStatus(SysI2cId_t bus)
{
    uint8_t st = 0U;

    if (bus >= SYS_I2C_COUNT) return SYS_I2C_ERR_PARAM;
    if (SYS_I2C_ReadByte(bus, s_addr[bus], CCS811_REG_STATUS, &st) != SYS_I2C_OK) {
        return SYS_I2C_ERR_DATA;
    }
    return (int)st;
}

int SYS_CCS811_GetErrorID(SysI2cId_t bus)
{
    uint8_t e = 0U;

    if (bus >= SYS_I2C_COUNT) return SYS_I2C_ERR_PARAM;
    if (SYS_I2C_ReadByte(bus, s_addr[bus], CCS811_REG_ERROR_ID, &e) != SYS_I2C_OK) {
        return SYS_I2C_ERR_DATA;
    }
    return (int)e;
}


/* 初始化(按手册顺序) */
uint8_t SYS_CCS811_InitAddr(SysI2cId_t bus, uint8_t addr7)
{
    static const uint8_t sw_reset_seq[4] = { 0x11U, 0xE5U, 0x72U, 0x8AU };
    uint8_t hw = 0U;
    uint8_t st = 0U;
    uint32_t t0;
    int err;

    if (bus >= SYS_I2C_COUNT) return SYS_CCS811_ERR_PARAM;

    /* 拉起总线(同 sys_mpu6050 / sys_bmp280),速率 400k */
    SYS_I2C_Init(bus, 400000);

    /* 记录本次地址;后续所有读函数都用它 */
    s_addr[bus] = addr7;

    /* 上电等待 20ms: 手册要求 SW_RESET 后 ≥20ms 才可通信,上电瞬间器件内部
     * 也在自复位;不等就发事务会 NACK,表现为"器件不在线" */
    delay_ms(SYS_CCS811_POWERON_DELAY_MS);

    /* 自检 HW_ID(0x20) 必须 = 0x81 */
    err = SYS_I2C_ReadByte(bus, addr7, CCS811_REG_HW_ID, &hw);
    if (err != SYS_I2C_OK) return (uint8_t)SYS_CCS811_ERR_HW_ID;
    if (hw != SYS_CCS811_HW_ID_VALUE) return SYS_CCS811_ERR_HW_ID;

    /* 软复位 SW_RESET(0xFF ← 0x11 0xE5 0x72 0x8A)到确定初始状态;
     * 寄存器号 + 4 字节数据,用 WriteBytes */
    err = SYS_I2C_WriteBytes(bus, addr7, CCS811_REG_SW_RESET, sw_reset_seq, 4U);
    if (err != SYS_I2C_OK) return (uint8_t)SYS_CCS811_ERR_SW_RESET;

    /* 软复位后必须等 ≥20ms 才能再通信 */
    delay_ms(SYS_CCS811_RESET_DELAY_MS);

    /* 轮询 STATUS(0x00) 等 APP_VALID(bit4)= 1,带超时;
     * 约束: APP_VALID = 0 表示片上应用固件未加载,手册禁止访问测量寄存器,
     * 此时读 0x02 不报错但返回全 0 / 脏数据,故超时报错而不返回假数据 */
    t0 = SYS_TICK_GetTick();
    for (;;) {
        if (SYS_I2C_ReadByte(bus, addr7, CCS811_REG_STATUS, &st) == SYS_I2C_OK &&
            (st & CCS811_STATUS_APP_VALID) != 0U) {
            break;                          /* 固件就绪,可以继续 */
        }
        /* 一次读失败不代表器件不在: 手册 Table 2 Note 2 指出"首次下载新固件后
         * 第一次复位最长 70ms 内器件可能 NACK"(AN-5 p16 同样警告)。把失败也
         * 算在超时窗口内,只有真等满 SYS_CCS811_APP_VALID_TIMEOUT_MS 才报错,
         * 否则 1000ms 的等待窗口形同虚设 */
        if (SYS_TICK_Elapsed(t0) >= SYS_CCS811_APP_VALID_TIMEOUT_MS) {
            return SYS_CCS811_ERR_APP_INVALID;
        }
    }

    /* 查 STATUS.ERROR(bit0): 置位时读 ERROR_ID(0xE0) 定位错误,再返回专门
     * 错误码;调用方也可用 SYS_CCS811_GetErrorID() 复查 */
    if ((st & CCS811_STATUS_ERROR) != 0U) {
        uint8_t e = 0U;
        (void)SYS_I2C_ReadByte(bus, addr7, CCS811_REG_ERROR_ID, &e);
        s_last_read_ms[bus] = 0U;           /* 没启动成功,时间判据归零 */
        return SYS_CCS811_ERR_DEV_ERROR;
    }

    /* APP_START(0xF4) 只发寄存器号,用 SYS_I2C_WriteCmd();
     * SYS_I2C_WriteBytes(..., NULL, 0) 因 len == 0 返回 SYS_I2C_ERR_PARAM */
    err = ccs811_write_cmd(bus, addr7, CCS811_REG_APP_START);
    if (err != SYS_I2C_OK) return (uint8_t)SYS_CCS811_ERR_WRITE_CMD;

    /* 复读 STATUS 确认真的进了应用模式: 手册 AN-5 p10-11 的范例在 APP_START
     * 之后读回 0x90(bit7 FW_MODE | bit4 APP_VALID);bit7 仍为 0 说明器件还停在
     * bootloader,此时写 MEAS_MODE 不会出数 */
    if (SYS_I2C_ReadByte(bus, addr7, CCS811_REG_STATUS, &st) == SYS_I2C_OK &&
        (st & CCS811_STATUS_FW_MODE) == 0U) {
        return (uint8_t)SYS_CCS811_ERR_APP_START;
    }

    /* 设测量模式 MEAS_MODE(0x01): 默认 0x10 = 恒供电 + 每 1 秒测量一次;
     * 可选模式见 .h 的 SYS_CCS811_MEAS_MODE_DEFAULT */
    err = SYS_I2C_WriteByte(bus, addr7, CCS811_REG_MEAS_MODE,
                            (uint8_t)SYS_CCS811_MEAS_MODE_DEFAULT);
    if (err != SYS_I2C_OK) return (uint8_t)SYS_CCS811_ERR_MEAS_MODE;

    /* 启动成功: 时间戳置为当前,使第一次 DataReady 等满一个测量周期再返回 1,
     * 避免读到未算好的旧数据 */
    s_last_read_ms[bus] = SYS_TICK_GetTick();

    return SYS_CCS811_OK;
}


/* 读取算法结果 */
int SYS_CCS811_Read(SysI2cId_t bus, SYS_CCS811_Data_t *out)
{
    uint8_t d[4];
    uint8_t st = 0U;
    uint8_t eid = 0U;
    int err;

    if (bus >= SYS_I2C_COUNT || out == 0) return SYS_CCS811_ERR_PARAM;

    /* 一次读 0x02 起连续 4 字节(CCS811 连续读不回地址自增,4 字节来自 0x02 的结果 FIFO): eCO2 与 TVOC 属同一次算法输出,
     * 分开读会取到不同时刻的值 */
    err = SYS_I2C_ReadBytes(bus, s_addr[bus], CCS811_REG_ALG_RESULT, d, 4U);
    if (err != SYS_I2C_OK) return err;

    /* 大端: 高字节在前 */
    out->eco2_ppm = (uint16_t)(((uint16_t)d[0] << 8) | (uint16_t)d[1]);
    out->tvoc_ppb = (uint16_t)(((uint16_t)d[2] << 8) | (uint16_t)d[3]);

    /* 读 STATUS / ERROR_ID 填入结构体,记录本次读数的器件状态;读失败非致命
     * (数据已取得),对应字段置 0 */
    if (SYS_I2C_ReadByte(bus, s_addr[bus], CCS811_REG_STATUS, &st) != SYS_I2C_OK) {
        st = 0U;
    }
    if (SYS_I2C_ReadByte(bus, s_addr[bus], CCS811_REG_ERROR_ID, &eid) != SYS_I2C_OK) {
        eid = 0U;
    }
    out->status   = st;
    out->error_id = eid;

    /* valid: APP_VALID 缺失或器件报错则无效,数据照填,调用方据此丢弃 */
    out->valid = ((st & CCS811_STATUS_APP_VALID) != 0U &&
                  (st & CCS811_STATUS_ERROR) == 0U) ? 1U : 0U;

    /* 读数成功,刷新时间戳;DataReady 判据以"成功读取"为起点 */
    s_last_read_ms[bus] = SYS_TICK_GetTick();

    return SYS_CCS811_OK;
}


/* 扩展功能 */
uint8_t SYS_CCS811_DataReady(SysI2cId_t bus)
{
    uint8_t mode = 0U;
    uint8_t st = 0U;
    uint32_t period;

    if (bus >= SYS_I2C_COUNT) return 0U;

    /* 主判据: STATUS.bit3 DATA_READY(手册 Table 7,读 0x02 后器件自动清 0) */
    if (SYS_I2C_ReadByte(bus, s_addr[bus], CCS811_REG_STATUS, &st) == SYS_I2C_OK &&
        (st & CCS811_STATUS_DATA_READY) != 0U) {
        return 1U;
    }

    /* 兜底: 读当前测量模式并换算成数据更新周期;读不到模式则用兜底周期 */
    if (SYS_I2C_ReadByte(bus, s_addr[bus], CCS811_REG_MEAS_MODE, &mode) != SYS_I2C_OK) {
        period = SYS_CCS811_DRDY_FALLBACK_MS;
    } else {
        period = ccs811_meas_period_ms(mode);
        if (period == 0U) {
            period = SYS_CCS811_DRDY_FALLBACK_MS;
        }
    }

    /* 时间兜底: 距上次成功读取是否已过一个测量周期;用无符号差值计算,
     * 计数器回绕(约 49.7 天)时结果仍正确 */
    return (SYS_TICK_Elapsed(s_last_read_ms[bus]) >= period) ? 1U : 0U;
}

int SYS_CCS811_SetEnvData(SysI2cId_t bus, float temp_c, float humi_rh)
{
    uint8_t d[4];
    int32_t t, h;

    if (bus >= SYS_I2C_COUNT) return SYS_CCS811_ERR_PARAM;

    /* 手册 AN-5 p18-19 明确禁止往"不支持的"温湿度字段写 0(编码即 0x0000),
     * 因此下边界不取 0、取手册默认值 50 %RH / 25 ℃(编码 0x6400);
     * 上边界按手册量程钳位: 湿度 100 %RH、温度 50 ℃ */
    if (humi_rh > 100.0f)  humi_rh = 100.0f;
    if (humi_rh < 0.5f)    humi_rh = 50.0f;
    if (temp_c > 50.0f)    temp_c = 50.0f;
    if (temp_c < -24.5f)   temp_c = 25.0f;

    /* 编码: 湿度 = RH × 512;温度 = (T + 25) × 512;各 2 字节大端。
     * 加 0.5f 为整数四舍五入,截断会系统性偏小 */
    h = (int32_t)(humi_rh * 512.0f + 0.5f);
    t = (int32_t)((temp_c + 25.0f) * 512.0f + 0.5f);

    d[0] = (uint8_t)(((uint32_t)h >> 8) & 0xFFU);   /* 湿度高字节 */
    d[1] = (uint8_t)((uint32_t)h & 0xFFU);          /* 湿度低字节 */
    d[2] = (uint8_t)(((uint32_t)t >> 8) & 0xFFU);   /* 温度高字节 */
    d[3] = (uint8_t)((uint32_t)t & 0xFFU);          /* 温度低字节 */

    return SYS_I2C_WriteBytes(bus, s_addr[bus], CCS811_REG_ENV_DATA, d, 4U);
}

int SYS_CCS811_GetBaseline(SysI2cId_t bus, uint16_t *out)
{
    uint8_t d[2];
    int err;

    if (bus >= SYS_I2C_COUNT || out == 0) return SYS_CCS811_ERR_PARAM;

    err = SYS_I2C_ReadBytes(bus, s_addr[bus], CCS811_REG_BASELINE, d, 2U);
    if (err != SYS_I2C_OK) return err;

    *out = (uint16_t)(((uint16_t)d[0] << 8) | (uint16_t)d[1]);   /* 大端 */
    return SYS_CCS811_OK;
}

int SYS_CCS811_SetBaseline(SysI2cId_t bus, uint16_t baseline)
{
    uint8_t d[2];

    if (bus >= SYS_I2C_COUNT) return SYS_CCS811_ERR_PARAM;

    d[0] = (uint8_t)((baseline >> 8) & 0xFFU);   /* 大端,与读对称 */
    d[1] = (uint8_t)(baseline & 0xFFU);

    return SYS_I2C_WriteBytes(bus, s_addr[bus], CCS811_REG_BASELINE, d, 2U);
}
