lmh666-yes/Second_Project_Demo/02_通信端_STM32F407/Project/FWLIB/src/sys_rtc.c

#include "sys_rtc.h"
/* 实现层；头文件注记见同名 .h */
#include "gpio_core.h"      /* 引脚/位 */
#include "delay.h"          /* 延时与 DWT 测时 */
#include "sys_nvic.h"       /* SYS_NVIC_SetPriority / EnableIRQ */

/* 上电流程：开 PWR 时钟，解锁备份域，起 LSE，等 LSERDY，选 RTC 时钟源，
 * 读备份寄存器魔数；有效则直接用，无效则复位备份域、重配 RTC、写默认时间
 * 备份域掉电后 RTC 寄存器全为 0x000000，读出来是 1970 年或乱值，
 * 用掉电不丢的备份寄存器存魔数，即可区分有效时间与垃圾值
 * 备份域复位 RCC_BackupResetCmd 必须在 PWR_BackupAccessCmd(ENABLE) 之后，
 * 否则复位命令被硬件静默忽略 */


/* 模块内部状态 */
static void     (*rtc_wakeup_cb)(void) = 0;
static void     (*rtc_alarm_cb)(void)  = 0;
static volatile uint32_t rtc_wakeup_cnt = 0;


/* 内部小工具 */

/* 等某个 RCC 标志置位，超时返回 0 */
static uint8_t rtc_wait_flag(uint8_t flag, uint32_t timeout_ms)
{
    uint32_t t0 = DWT_GetUs();

    while (RCC_GetFlagStatus(flag) == RESET) {
        if (DWT_ElapsedUs(t0) > (timeout_ms * 1000UL)) return 0U;
    }
    return 1U;
}

/* 配时钟源与预分频，只在首次上电调用
 * LSE 32768Hz : 128 × 256 = 32768，得 1Hz
 * LSI ~32000Hz: 128 × 250 = 32000，得 1Hz（约数，精度差）
 * 返回 0 = 成功，1 = RTC_Init 失败 */
static uint8_t rtc_config(uint32_t rtc_clk_src)
{
    RTC_InitTypeDef ri;

    /* 本函数内不得调用 RCC_BackupResetCmd */
    PWR_BackupAccessCmd(ENABLE);        /* 写 BDCR 前先解锁 DBP */
    RCC_RTCCLKCmd(ENABLE);
    (void)RTC_WaitForSynchro();

    ri.RTC_HourFormat   = RTC_HourFormat_24;
    ri.RTC_AsynchPrediv = 127U;         /* 异步分频 128 */
    ri.RTC_SynchPrediv  = (rtc_clk_src == RCC_RTCCLKSource_LSE) ? 255U : 249U;

    if (RTC_Init(&ri) != SUCCESS) return 1U;

    return 0U;
}

/* Unix 秒 ↔ 年月日：无查表、无循环 */
static int32_t rtc_days_from_civil(int32_t y, int32_t m, int32_t d)
{
    int32_t  era;
    uint32_t yoe;
    uint32_t doy;
    uint32_t doe;

    y -= (m <= 2) ? 1 : 0;
    era = (y >= 0 ? y : (y - 399)) / 400;
    yoe = (uint32_t)(y - era * 400);                          /* [0, 399] */
    doy = (uint32_t)((153 * (m + ((m > 2) ? -3 : 9)) + 2) / 5 + d - 1);
    doe = yoe * 365U + yoe / 4U - yoe / 100U + doy;           /* [0, 146096] */

    return era * 146097 + (int32_t)doe - 719468;
}

static void rtc_civil_from_days(int32_t z, int32_t *y_out, int32_t *m_out, int32_t *d_out)
{
    int32_t  era;
    uint32_t doe;
    uint32_t yoe;
    uint32_t doy;
    uint32_t mp;
    int32_t  y;
    int32_t  m;

    z += 719468;
    era = (z >= 0 ? z : (z - 146096)) / 146097;
    doe = (uint32_t)(z - era * 146097);                       /* [0, 146096] */
    yoe = (doe - doe / 1460U + doe / 36524U - doe / 146096U) / 365U;
    y   = (int32_t)yoe + era * 400;
    doy = doe - (365U * yoe + yoe / 4U - yoe / 100U);         /* [0, 365] */
    mp  = (5U * doy + 2U) / 153U;                             /* [0, 11] */
    y  += (doy >= 306U) ? 1 : 0;                              /* 1/3 之后进下一年 */
    m   = (int32_t)mp + ((mp < 10U) ? 3 : -9);                /* [1, 12] */

    if (y_out != 0) *y_out = y;
    if (m_out != 0) *m_out = m;
    if (d_out != 0) *d_out = (int32_t)(doy - (153U * mp + 2U) / 5U + 1U);
}

static void rtc_put2(char *p, uint8_t v)
{
    p[0] = (char)('0' + ((v / 10U) % 10U));
    p[1] = (char)('0' + (v % 10U));
}


/* 基础功能 */
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
