lmh666-yes/Second_Project_Demo/(commit log)

2026-11-03 环境监测系统：检测端/通信端固件 + Qt上位机 + 设计文档
2026-11-03 README 按实际代码重写：加「实际做到哪一步」对照表，修正过度乐观表述
